ycaf/mas306-rapport/rorboyer-Steinsland_Fiaz.tex

\documentclass[norsk,a4paper,twoside,11pt]{report}
% Alternative Options:
%	Paper Size: a4paper / a5paper / b5paper / letterpaper / legalpaper / executivepaper
% Duplex: oneside / twoside
% Base Font Size: 10pt / 11pt / 12pt

%% Language %%%%%%%%%%%%%%%%%%%%%%%%%%%%%%%%%%%%%%%%%%%%%%%%%
\usepackage[norsk]{babel} %francais, polish, spanish, ...
\usepackage[T1]{fontenc}
\usepackage[ansinew]{inputenc}
\usepackage{hyperref}
\usepackage{natbib}

\usepackage{lmodern} %Type1-font for non-english texts and characters
\usepackage{graphicx} %%For loading graphic files
\usepackage{amsmath}
\usepackage{amsthm}
\usepackage{amsfonts}

%% Line Spacing %%%%%%%%%%%%%%%%%%%%%%%%%%%%%%%%%%%%%%%%%%%%%
%\usepackage{setspace}
%\singlespacing        %% 1-spacing (default)
%\onehalfspacing       %% 1,5-spacing
%\doublespacing        %% 2-spacing

%% Other Packages %%%%%%%%%%%%%%%%%%%%%%%%%%%%%%%%%%%%%%%%%%%
%\usepackage{a4wide} %%Smaller margins = more text per page.
\usepackage{fancyhdr} %%Fancy headings
%\usepackage{longtable} %%For tables, that exceed one page

\usepackage{listings}
\usepackage{textcomp}

\usepackage{color}
\definecolor{darkgreen}{rgb}{0.3,0.6,0.3}
\definecolor{listinggray}{gray}{0.9}
\definecolor{lbcolor}{rgb}{0.9,0.9,0.9}

\lstset{
	backgroundcolor=\color{lbcolor},
	tabsize=4,
	rulecolor=,
	language=c++,
	basicstyle=\scriptsize,
	upquote=true,
	aboveskip={1.5\baselineskip},
	columns=fixed,
	showstringspaces=false,
	extendedchars=true,
	breaklines=true,
	prebreak = \raisebox{0ex}[0ex][0ex]{\ensuremath{\hookleftarrow}},
	frame=single,
	showtabs=false,
	showspaces=false,
	showstringspaces=false,
	identifierstyle=\ttfamily,
	keywordstyle=\color[rgb]{0,0,1},
	commentstyle=\color[rgb]{0.133,0.545,0.133},
	stringstyle=\color[rgb]{0.627,0.126,0.941},
}

\parindent 0mm
\setlength{\oddsidemargin}{0mm}
\setlength{\evensidemargin}{0mm}
\setlength{\topmargin}{-20mm}
\setlength{\textwidth}{165mm}
\setlength{\textheight}{260mm}

\hypersetup{
   pdfauthor={UiA Mechatronics Student},
   pdftitle={MAS306 Bachelor Thesis},
   pdfkeywords={report, mechatronics, master, University of Agder},
   pdfsubject={Project Report},
   colorlinks=true,
   citecolor=darkgreen,
   urlcolor=darkgreen,
   linkcolor=darkgreen,
   pdfstartview=Fit,
   pdfpagelayout=SinglePage,
   pdfcreator=pdflatex,
   pdfproducer=pdflatex
}

\begin{document}
\pagenumbering{roman}
\pagestyle{empty} %No headings for the first pages.
\input{titlepage}
\clearpage

\chapter*{Takksigelser}
Vi vil gjerne rette en stor takk til Morten Ottestad for veiledning og gode tips på veien, og Morten Kjeld Ebbesen for hjelp med mekanikken bak det hele. Vi vil også takke to av våre medelever, Tore Saua og Helge Andreas Falkum, for god hjelp med utforming av designet og den praktiske delen med bygging. 

\clearpage
\chapter*{Abstrakt}

\clearpage

\cleardoublepage %The first chapter should start on an odd page.
\pagestyle{plain} %Now display headings: headings / fancy / ...

\clearpage

% add table of contents, list of figures and tables
\tableofcontents 
\clearpage
\addcontentsline{toc}{chapter}{List of Figures}
\listoffigures
\clearpage
\addcontentsline{toc}{chapter}{List of Tables}
\listoftables
\clearpage
\lhead{\rightmark}
\pagenumbering{arabic}

\chapter{Introduksjon}
Denne oppgaven er tildelt av fakultet for teknologi og realfag ved Universitet i Agder. Det skal anvendes kunnskap som står i tråd med læringsmålene for en treårig bachelor i mekatronikk. 

\section{Metodikk}
Dette prosjektet tar for seg å designe og programmere en rørbøyemaskin som skal kunne forme rør uavhengig av lengde, og slike løsninger finnes det lite informasjon om. De fleste rørbøyemaskiner er installert med en dyttemekanisme i bakenden, som resulterer i at de blir store og tar mye plass om de skal kunne ta lange rør. Det ble derfor tatt i bruk SketchUp og SolidWorks for å lage gode løsninger i 3D-format. 
\section{Avgrensning}
Hovedoppgaven var å designe og konstruere hele rørbøyemaskinen. Gruppen ble dessverre svekket, da et medlem måtte hoppe av prosjektet. Dette gikk utover arbeidsfordelingen som opprinnelig var planlagt. Sammen med veileder ble da oppgaven kortet ned til å kun konsentrere seg om fremparten av maskinen, det gruppen har valgt å kalle XY-bordet.  
\section{Eksisterende rørbøyeteknikker}
Rørbøying har lenge vært en del av historien, og har vært i stadig utvikling. Det er relativt ukomplisert å bøye et rør. En metode er å gjøre det manuelt ved hjelp av en hydraulisk presse. Man kan bytte ut diene, og dermed enkelt kunne bøye rør med forskjellig diameter. Med disse manuelle pressene settes det begrensninger til utforming av røret, da de kun bøyer i én frihetsgrad. Det er i tillegg tidkrevende.  

Et annet alternativ er automatisk hydraulisk rørbøyer. Det er denne type teknikk som vil være den mest sammenlignbare metoden, opp mot oppgavens elektroniske CNC-maskin. En hydraulisk aktuator vil kunne oppnå et høyt moment på små maskiner\cite{HydVsEl}. Den vil ta litt større plass da aktuatoren må stå ved maskinen, hvor en elektrisk styrt aktuator kan plasseres uavhengig av maskinen. Det vil være noen fordeler med en hydraulisk maskin, men de mange fordelene med elektronikk vil veie mot. Slik som at en hydraulisk maskin vil ha høyere støynivå, vedlikehold med oljeskift og presisjon. 

\chapter{Teori}

\section{CNC-styring} 
Computer Numerical Control er elektroniske maskiner som utfører arbeid etter et forhåndsinnstilt program. CNC-styring er avkommet etter Computer Aided Design og Computer Aided Manufacturing (CAD/CAM) produksjoner \cite{NorskDatakunnskapNetwork}. 

De første numerisk styrte maskinene ble utviklet i USA på 1950-tallet. Det ble behov for maskiner som kunne produsere kompliserte og nøyaktige deler til fly. Etterhvert som elektronikken fikk mer innflytelse i maskinindustrien ble det tatt i bruk mikroprosessorer. Dette la grunnlaget for dagens databasert numeriske maskiner (CNC)\cite{Niskolen}. Mikroprosessorene gjorde det mulig å lagre opp til flere forhåndsprogrammerte programmer i hukommelsen til maskinen og lettere å rette opp feil i programmet. Hvor man tidligere måtte lage nye program kunne man nå rette dem opp i hukommelsen. Man tok også i bruk datamaskinens regnekunnskaper for å lettere regne ut koordinatene til maskinens posisjon. 

Programformatet for bruk av koding i CNC-styrte maskiner er regulert av den internasjonale standarden ISO 6983/1 og ISO 6983/2. Dette språket består av G- og M-funksjoner. G-funksjonene er forberedende funksjoner som plassering i X,Y,Z-planet, økende/minkende, høyre/venstre, valg av lengde/hastighet og slike ting. M-funksjonene er hjelpende funksjoner som stopp/start, på/av \cite{Niskolen}. 
\section{Kaldbearbeiding}

\section{Gripemekanisme}
Den mest vanlige metoden for mating av rør i eksisterende CNC-rørbøyemaskiner er å montere en dyttemekanisme i enden av maskinen. Det setter begrensninger til hvilken rørlengde det er mulig å jobbe med. Maskinen som skal konstrueres i denne oppgaven skal, i teorien, kunne ta en uendelig lengde. For å få dette til må det en form for gripemekanisme til. Det er viktig at mekanismen kan fungere godt med runde og glatte overflater. Og at det er høy friksjon mellom gjenstanden som skal ta tak i røret og røret. Balansen mellom å ta tak nok og for mye er veldig fin. Det er hensiktsmessig at mekanismen ikke griper så hardt at det blir skade eller deformasjon på røret. For å få dette til er det mulig å bruke prinsippet til en lift-tong. Den lift-tong vil gripe med en kraft som er proporsjonal med vekten til gjenstanden den skal løfte \cite{N.Sclater}. Dette prinsippet må anvendes på en måte slik at den kan brukes på en horisontal kraft. 
\section{Belastninger} 
For å ha få en oversikt over hvilke krefter som virker på røret når det bøyes, settes opp et enkelt FLD (Free-Body-Diagram), som er illustrert i figur \ref{FLD}. Det er satt opp et lokalt koordinatsystem som følger aksen til røret. Det er kraften $P_L$ som sier noe om hvor stort moment som trengs for å dytte røret i X-retning, og den kraften som er viktigst å finne ut for å kunne vite om motoren har stor nok kraft til å klare oppgaven. 

\begin{figure}[h]
\centering
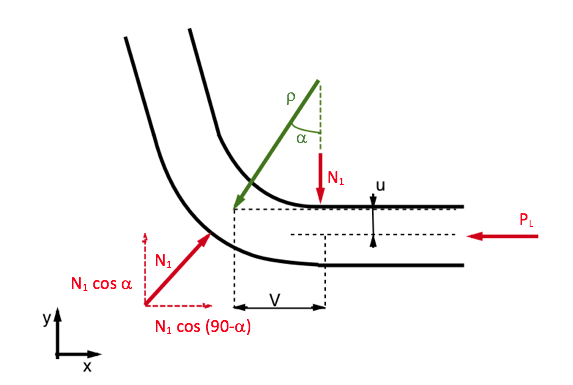
[picture p1: Pics/krefterror.png]

\caption[Krefter på rør]{Enkelt FLD av kreftene som virker på røret}
\label{FLD}
\end{figure}

\begin{equation}\label{u}
u=\rho\cdot(1-cos\alpha)
\end{equation}
\begin{equation}\label{V}
V=\rho\cdot sin \alpha
\end{equation}
Hvor: \\
$u$=Forskyvning på skinnene\\
$V$=Avstand fra stuss og senter av sfærisk lager \\
$\alpha$=Bøyeradius i radianer\\
$\rho$= Radius av bøyen på røret \\

$V$ og $u$ er konstanter som kan hentes ut i fra konstruksjonen. Vi sitter da igjen med to ligninger og ukjent. Ved å løse ligning \ref{V} med hensyn på $\rho$, og sette den nn i ligning \ref{u} får vi

\begin{equation}\label{alpha}
u=\frac{V}{sin\alpha}\cdot(1-cos\alpha)
\end{equation}

Denne ligningen kan løses grafisk. Ved å finne det maksimale $u$ kan være, finner man den maksimale bøyeradien som er mulig å oppnå. Det er da mulig å løse ligning \ref{rho} og finne $\rho$.

\begin{eqnarray}\label{rho}
\rho=\frac{u}{1-cos\alpha}
\end{eqnarray}

For at røret skal få varig derformasjon må det over flytegrensen, slik at det får en plastisk deformasjon. Dette vil i teorien skje i ytterpunktene av røret. Mens i midten vil holde seg under flytegrensen. For å finne denne grensen bruker man 
\begin{equation}
\epsilon_y=\frac{-y}{\rho}
\end{equation}
\begin{eqnarray}
\sigma_y&=&E\cdot\epsilon_y \Downarrow\nonumber\\
\epsilon_y&=&\frac{\sigma_y}{E}
\end{eqnarray}
Dette gir 
\begin{eqnarray}\label{y}
\frac{-y}{\rho}&=&\frac{\sigma_y}{E} \Downarrow\nonumber\\
y&=&\frac{-\sigma_y\cdot\rho}{E}
\end{eqnarray}\\
Hvor: \\
$\epsilon_y$=Tøyning\\
$y$= Avstanden fra senter av røret til den plastiske deformasjonen begynner\\
$\rho$= Radiusen av bøyen på røret\\
$E$=Elasitetsmodulen\\
$\sigma_y$=Flytegrensen til metallet\\
 
 I figur \ref{fig;pl} er det illustrert med to røde streker hvor overgangen fra den elastiske deformasjonen til plastisk deformasjon vil skjer. Lengden $y$ er ukjent, så nøyaktig hvor dette skille går finner man ikke ut før man har løst ligning \ref{y}. 
\begin{figure}[h!] 
\centering
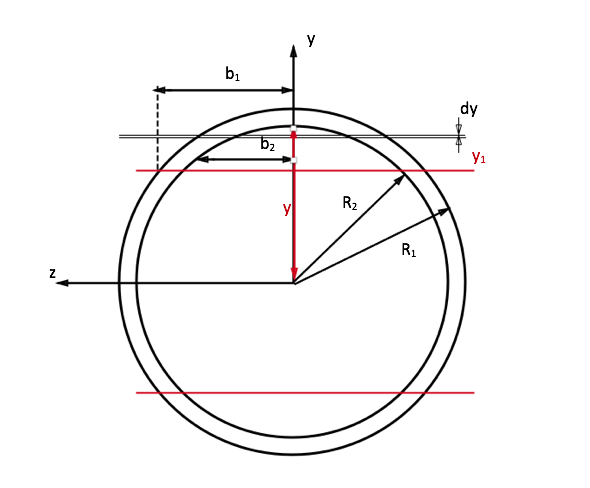
[picture p2: Pics/plastisk.png]

\caption[Plastisk deformasjon]{llustrasjon om hvor det plastiske området begynner}
\label{fig;pl}
\end{figure}

\begin{eqnarray}
R_1^2&=&b_1^2+y^2 \Downarrow\nonumber\\
 b_1&=&\sqrt{R_1^2-y^2}
\end{eqnarray}
\begin{eqnarray}
R_2^2&=&b_2^2+y^2 \Downarrow\nonumber\\ 
b_2&=&\sqrt{R_2^2-y^2}
\end{eqnarray}
Momentet som trengs for å komme opp i plastisk deformasjon er utledet ut i fra figur \ref{fig;pl}. 

\begin{eqnarray}\label{plastisk}
M_P&=&\int_{F}y dF \Downarrow \nonumber\\
&=&\int_{y_1}^{R_1}y\cdot\sigma_y\cdot2b_1 dy - \int_{y_1}^{R_2}y\cdot\sigma_y\cdot2b_2 dy \Downarrow\nonumber\\
&=&\frac{2}{3}\cdot\sigma_y((R_1^2-y_1^2)^\frac{3}{2}-(R_2^2-y_1^2)^\frac{3}{2})
\end{eqnarray}
Hvor:\\
$M_P$=Moment for å oppnå plastisk deformasjon\\
$\sigma_y$=Flytegrensen\\ 
$b_1$=Bredden fra senterlinje til yttersiden av røret\\
$b_2$=Bredden fra senterlinje til innsiden av røret\\
$R_1$=Ytre radius\\
$R_2$=Indre radius\\
$y_1$= Grensen til plastisk deformasjon\\

Momentene som regnes ut i ligning \ref{plastisk} og \ref{elastisk} er kun for halve høyden av røret, så svaret må ganges med to. I figur \ref{fig;el} er samme rør illustret på nytt, men denne gangen med hensyn på den elastiske deformasjonen. Det er 

\begin{figure}[h!]
\centering
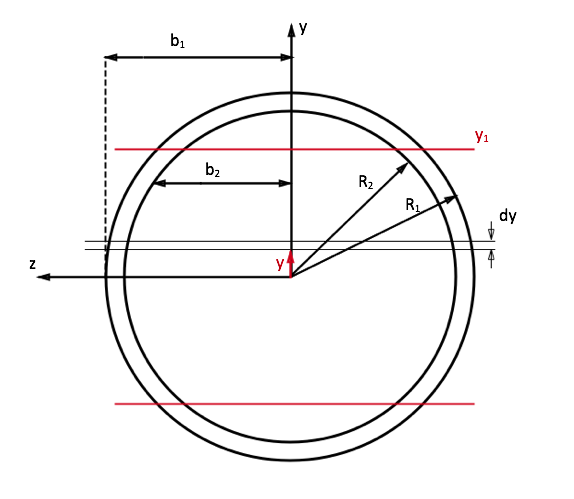
[picture p3: Pics/elastisk.png]

\caption[Elastisk deformasjon]{Illustrasjon av hvor det elastiske området vil befinne seg}
\label{fig;el}
\end{figure}

\begin{eqnarray}\label{elastisk}
M_E&=&\int_{F}ydF\Downarrow\nonumber\\
&=&\int_{A}y\cdot\sigma_ydA\Downarrow\nonumber\\
&=&\int_{0}^{y_1}y\cdot\frac{\sigma_y}{y_1}\cdot y\cdot2b_1dy-\int_{0}^{y_1}y\cdot\frac{\sigma_y}{y_1}\cdot y\cdot2b_2dy\Downarrow\nonumber\\
&=&2\frac{\sigma_y}{y_1}\cdot(-y_1\frac{(R_1^2-y_1^2)^\frac{3}{2}}{4})+\frac{R_1^2\cdot y_1\sqrt{R_1-y_1^2}}{8}+\frac{R_1^4}{8}\cdot\arcsin\frac{y_1}{R_1}\nonumber\\ &-& 2\frac{\sigma_y}{y_1}\cdot(-y_1\frac{(R_2^2-y_1^2)^\frac{3}{2}}{4})+\frac{R_2^2\cdot y_1\sqrt{R_2-y_1^2}}{8}+\frac{R_2^4}{8}\cdot\arcsin\frac{y_1}{R_2}
\end{eqnarray}
Hvor:\\
$M_E$=Momentet for å oppnå elastisk deformasjon\\
$\sigma_y$=Flytegrensen\\ 
$b_1$=Bredden fra senterlinje til yttersiden av røret\\
$b_2$=Bredden fra senterlinje til innsiden av røret\\
$R_1$=Ytre radius\\
$R_2$=Indre radius\\
$y_1$= Avstanden opp til plastisk deformasjon\\

\begin{eqnarray}\label{kraft}
M_E+M_P&=&V\cdot N_1\Downarrow\nonumber\\
N_1&=&\frac{M_E+M_P}{V}
\end{eqnarray}
Hvor:

$M_E$=Momentet for å oppnå elastisk deformasjon\\ 
$M_P$=Momentet for å oppnå plastisk deformasjon\\ 
$N_1$=Kraften som står vinkelrett på røret\\

\begin{eqnarray}\label{dyttekraft}
\sum F_x=0N&=&-P_L+N_1\cdot \cos(\frac{\pi}{2}-\alpha)\Downarrow\nonumber\\
P_L&=&N_1\cdot\cos(\frac{\pi}{2}-\alpha)
\end{eqnarray}

Hvor:\\
$P_L$=Kraften som må til for å dytte røret\\ 
$N_1$=Kraften som står vinkelrett på røret\\

\chapter{Konstruksjon og styring}
(Her beskrives fremgangsmåten i detalj slik at resultatet kan reproduseres av andre)
\section{Utstyr}
Før planleggingen av designet var det hensiktsmessig å gå over lagret, for å få en oversikt over hva som var tilgjengelig og hva som eventuelt måtte kjøpes inn. Vi hadde tilgang på ledeskruer med tilhørende mutter, samt skinner med vogn som sklir lett frem og tilbake. Dette skulle implementeres for å kunne laget et plan som kunne bøye røret i X- og Y-retning, og føre røret fremover. Det resterende som manglet for å kunne konstruere en full rørbøyemaskin måtte tegnes og konstrueres selv, ved hjelp av SolidWorks og SketchUp. 

Programvaren som skal brukes for å styre X-Y-Z-planet er Mach3. Dette er et mye brukt kontrollsystem for CNC-maskiner. Det virker bra i CAD/CAM produksjoner, som med laserkuttere og fres for å nevne noen. 

\section{Design}
Hele prosessen med oppgaven startet med designet. Flere maskiner ble undersøkt for å få inspirasjon til design. Og det ble relativt tidlig laget et utkast av en maskin, som vises i figur \ref{forste}. Den er installert med to motorer for å styre den delen som skal bevege seg i X- og Y-retning. Det er også en motor i bakenden, for å dytte røret fremover. Men den mekanismen måtte re-designes da maskinen skulle ha gripemekanisme for å kunne ta uendelig lange rør. I figur \ref{andre} ser man det neste konseptet som ble designet. I denne designfasen ble den fremste delen av maskinen, den delen som skal bevege seg i X-Y-planet, videreutviklet.  Utfordringene kom når midt-delen, med en matemekanisme, skulle tegnes. Her er den med den første ideen til en gripemekanisme, men denne prosessen er forklart nærmere i de videre kapitlene angående gripemekanismen og rotasjon av rør.

\begin{figure}[h!]
\centering
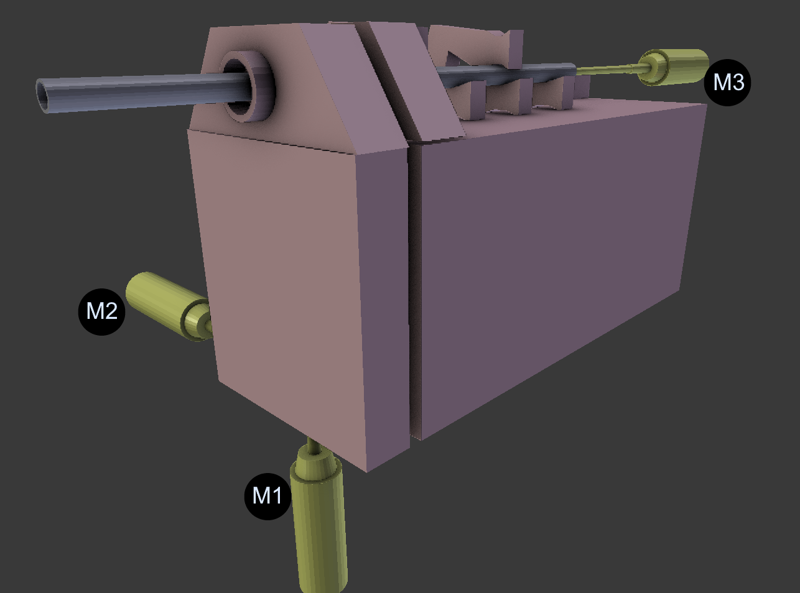
[picture p4: Pics/prinsippSkisse_1.png]

\caption[Konsept 1]{Første konseptet}
\label{forste}
\end{figure}
\begin{figure}[h!]
\centering
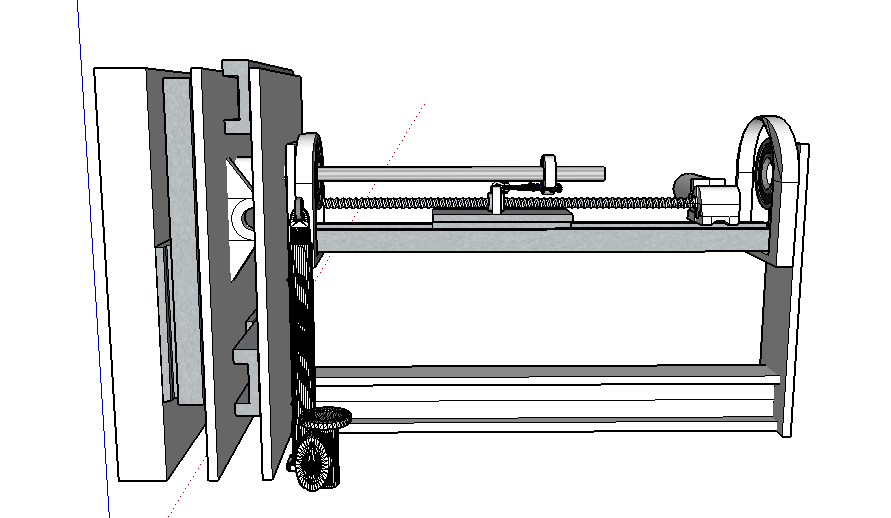
[picture p5: Pics/Ide2.png]

\caption[Konsept 2]{Det andre konseptet}
\label{andre}
\end{figure}
Det er lagt mye arbeid i at maskinen skal være kompakt, slik at den tar lite plass. Den endelig maskinen er designet med i alt tre motorer og en lineær-sylinder. Det er plassert en motor på bakerste del for å styre skruen i Z-retning. Denne jobber sammen med lineær-sylinderen for å rotere røret i spesifikke grader. En motor er festet på undersiden av XY-bordet for å styre skruen i Y-retning og en tredje motor på siden for å styre skruen i X-retning. I figur \ref{ide3} er hele konstruksjonen illustrert, hvor røret blir matet i Z-retning mot venstre. 

\begin{figure}[h]
\centering
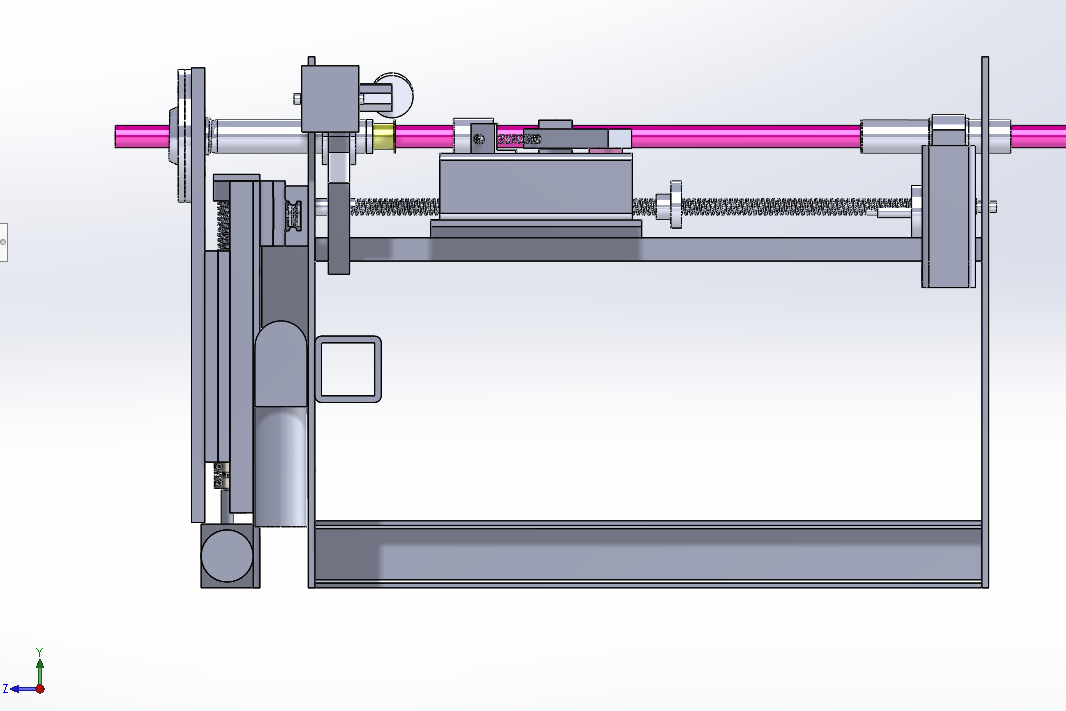
[picture p6: BildeZY.PNG]

\caption{Full illustrasjon av design}
\label{ide3}
\end{figure}

\section{Materialer}
Alle materialene som måtte produseres fra bunnen av er tiltenkt å være i stål. Stålplatene er på 10mm med hull som er tilpasset de ferdigproduserte skinnene. Disse passer til en M8 bolt. Skinnene og vognene er av aluminium, så ingen av delen kunne sveises til stålplatene. I figur X ser man en skinne og vogn montert fast i en plate. 

Det er brukt lager fra Igus til opplagring av skruer og stussen. Disse er laget i plastikk, og trenger ingen vedlikehold eller smøring \cite{Igus}. Lagrene som er valgt ut for X-og Y-skrue kan tåle opp til 120 MPa \cite{IgusQ2}. Og lageret som er valgt ut til stussen tåler opp til 80MPa \cite{IgusG}

\begin{figure}[h!]
\centering
\graphicspath{{Pics}}
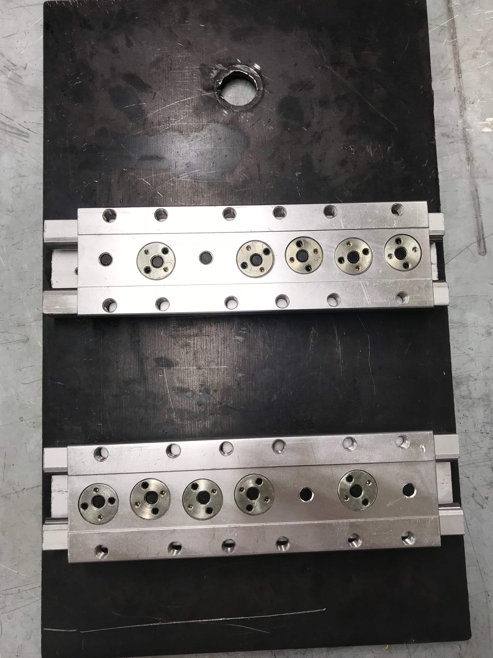
[picture p7: IMG_E1818.jpg]

\caption[Skinner]{Her er skinene og vognen montert på en av stålplatene som skal styre øyet}
\label{stal}
\end{figure}
\pagebreak
\section{Mating av rør}
Prosessen med å finne en mekanisme for å mate røret i Z-retning var den mest krevende. En av de første ideene var en lift-tong festet til en ledeskrue, med to halvmåner som tar tak i røret, dette er illustrert i figur \ref{grip1} Ideen var at halvmånene skulle klemme til når skruen gikk i positiv retning, og løse opp når den skulle gå i negativ retning for å hente mer rør. Problemet med denne løsningen er at den bare tar tak i nedre del av halvmånen. Når dette skal rotere vil det skape et uønsket moment. Dette ble løst ved å montere på en til klype på toppen av halvmånene, og laget et slags hus, som man kan se i figur \ref{grip2}. Men ved nærmere ettertanke ble det avklart at det ble for avansert å produsere. Det var det nåværende gripehuset ble konstruert, figur \ref{grip3} Det er større og mer robust, og skal fungere på samme måte med at det griper til i positiv retning og slipper opp i negativ retning. Dette kan enklere produseres da det er brukt forskjellige typer standardiserte stålkomponenter. I motsetning til de første to ideene hvor lift-tongen måtte vært skjært ut i ulike former. 
\begin{figure}
\centering
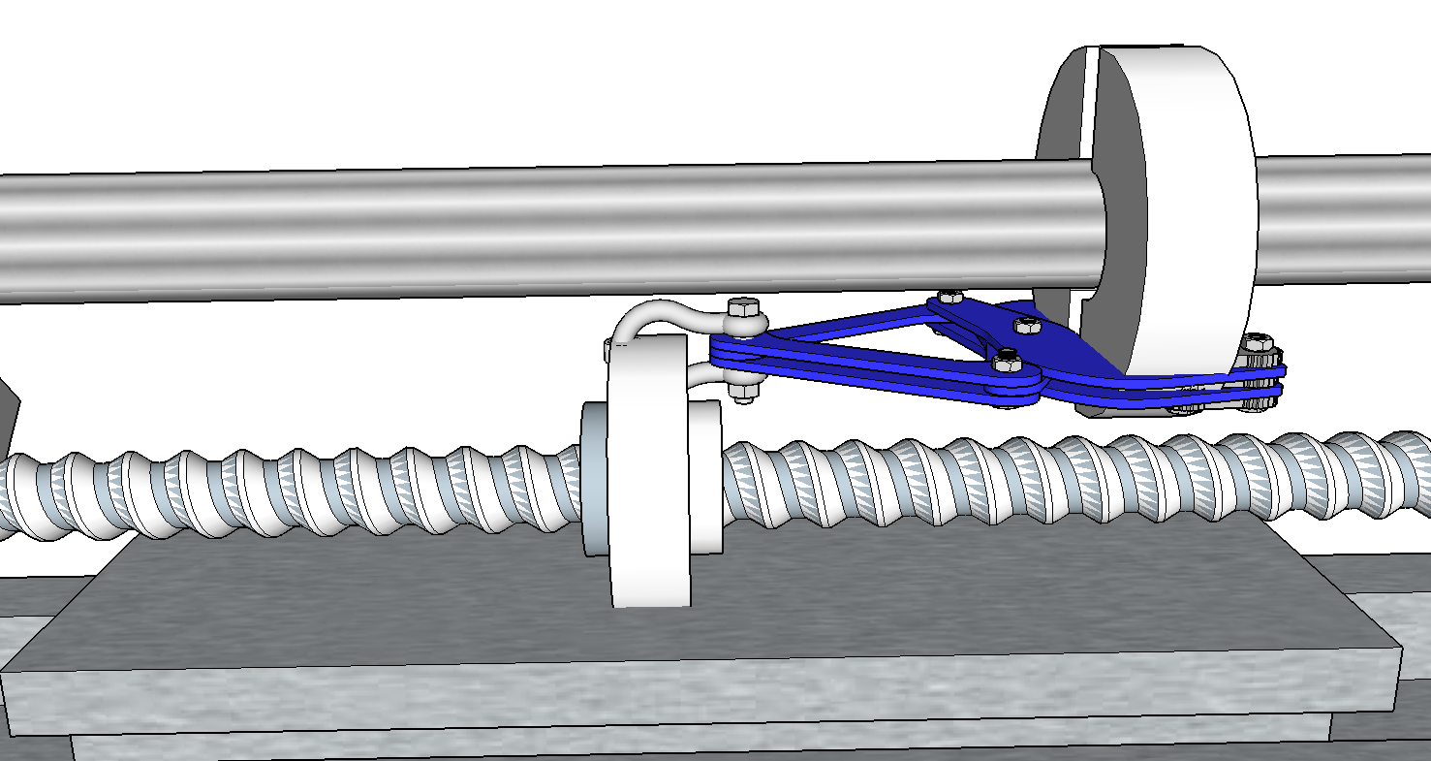
[picture p8: Pics/GripeKonsept.PNG]

\caption[Gripemekanisme 1]{Den første ideen til gripemekanisme}
\label{grip1}
\end{figure}
\begin{figure}
\centering
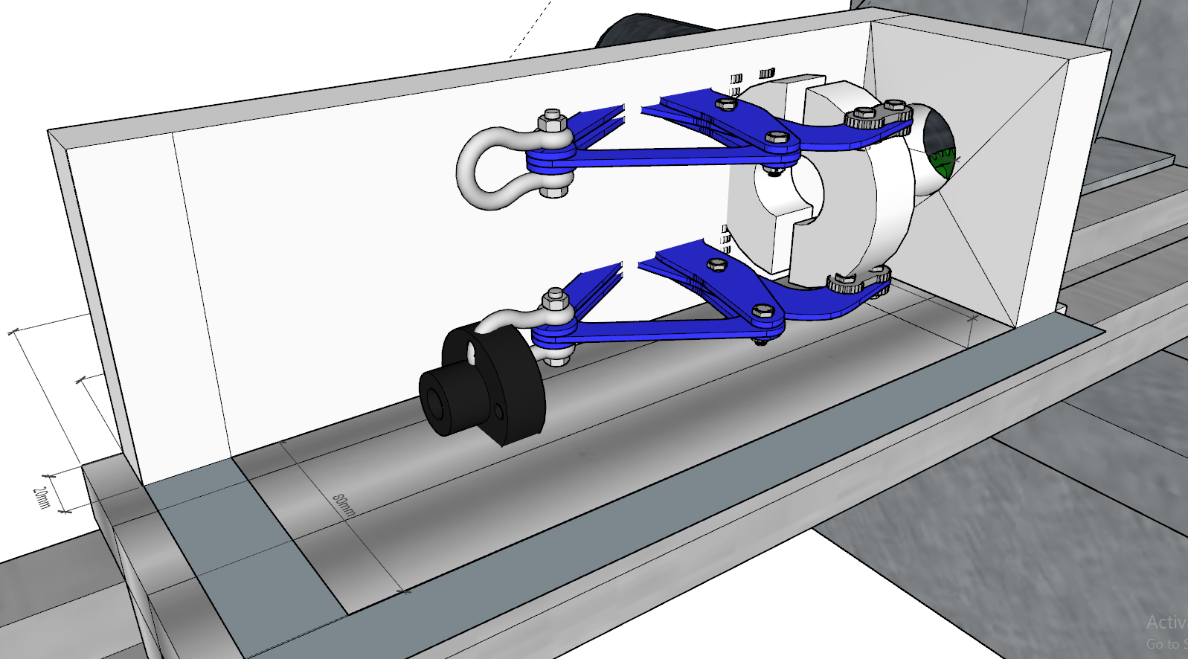
[picture p9: Pics/gripeHusConcept.PNG]

\caption[Gripemekanisme 2]{Den andre ideen til gripemekanisme}
\label{grip2}
\end{figure}
\begin{figure}
\centering
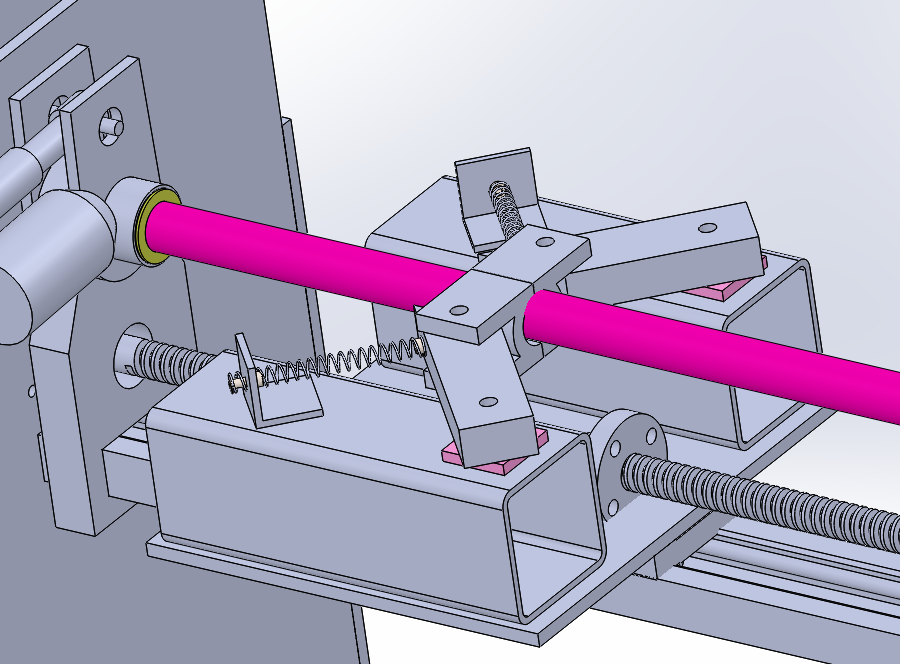
[picture p10: Pics/Gripemekanisme.png]

\caption[Gripemekanisme 3]{Den endelige gripemekanismen}
\label{grip3}
\end{figure}
\pagebreak
\subsection{Gripehus}
I fra figur \ref{FLD} ser man at det kommer en kraft $P_L$ på røret. Det er denne kraften som trengs for å kunne føre og bøyet røret. For å finne denne, må ligning \ref{u} - \ref{dyttekraft} anvendes. Hvis man tar utgangspunktet i at det skal bøyes et rør med flytegrenser $\sigma_y = 195MPa$ og E-modul $E=210 GPa$. Et rør med tykkelse $t=2,65mm$ gir en ytre radius $R_1= 16,85mm$ og indre radius $R_2=14,2mm$. $u$ er den maksimale skyvningen skinnene kan ha i X- og Y-retning før det sfæriske lageret går ut av posisjon. Og den er funnet til å være $u=15mm$. $V$ er avstanden fra stussen til senter av det sfæriske lageret. Ut i fra konstroksjonen kan man lese av at denne er $V=40.33mm$. 

\begin{equation}\label{alphanew}
u=\frac{V}{sin\alpha}\cdot(1-cos\alpha)
\end{equation}

Ut i fra figur \ref{graf} kan man se av $\alpha$ = 0,712 rad

\begin{figure}[h!]
\centering

\caption[Graf]{Grafen viser sammenhengen mellom $u$ og $\alpha$}
\label{graf}
\end{figure}

\begin{eqnarray}\label{rhonew}
\rho&=&\frac{u}{1-\cos\alpha}\nonumber\\
&=&\frac{15mm}{1- \cos 0,712}\nonumber\nonumber\\
&=&{\underline{\underline{61,717mm}}}
\end{eqnarray}

\begin{eqnarray}\label{ynew}
y&=&\frac{-\sigma_y\cdot\rho}{E}\nonumber\\
&=&\frac{-(-195MPa)\cdot61,717mm}{210\cdot10^3 MPa}\nonumber\\
&=&\underline{\underline{0,057mm}}
\end{eqnarray}\\

\begin{eqnarray}\label{plastisknew}
M_P&=&\frac{2}{3}\cdot\sigma_y((R_1^2-y_1^2)^\frac{3}{2}-(R_2^2-y_1^2)^\frac{3}{2})\nonumber\\
&=&\frac{2}{3}\cdot195MPa(((16,85mm)^2-(0,057mm)^2)^\frac{3}{2}-((14,2mm)^2-(0,057mm)^2)^\frac{3}{2})\nonumber\\
&=&\underline{249 703,099Nmm}
\end{eqnarray}

Dette er kun momentet for å komme opp i plastisk deformasjon for halve røret. For å få et korrekt tall for hele røret, må svaret ganges med to. Så dette gir at det fullstendige momentet som må til er 

\begin{eqnarray}
M_P &=& 2 \cdot 249703,099\nonumber\\
&=&\underline{\underline{499 406,198Nmm}}
\end{eqnarray}

\begin{eqnarray}\label{elastisknew}
M_E&=&2\cdot \frac{195MPa}{0,057mm}\cdot(-0,057mm\frac{((16,85mm)^2-(0,057mm)^2)^\frac{3}{2}}{4})\nonumber\\
&+&\frac{(16,85mm)^2\cdot 0,057mm\sqrt{(16,85mm)^2-(0,057mm)^2}}{8}\nonumber\\
&+&\frac{(16,85mm)^4}{8}\cdot\arcsin\frac{0,057mm}{16,85mm}\nonumber\\ 
&-& 2\cdot \frac{195MPa}{0,057mm}\cdot(-0,057mm\frac{((14,2mm)^2-(0,057mm)^2)^\frac{3}{2}}{4})\nonumber\\
&+&\frac{(14,2mm)^2\cdot 0,057mm\sqrt{(14,2mm)^2-(0,057mm)^2}}{8}\nonumber\\
&+&\frac{(14,2)^4}{8}\cdot\arcsin\frac{0,057mm}{14,2mm}\nonumber\\
&=& 9,892 Nmm - 8,336Nmm\nonumber\\
&=&\underline{1,555Nmm}
\end{eqnarray}

I dette tilfellet er det også bare regnet ut den elastiske deformasjonen for halve røret. Så dette svaret på også ganges med to. 

\begin{eqnarray}
M_E&=& 2 \cdot 1,555Nmm\nonumber\\
&=&\underline{\underline{3,111Nmm}} 
\end{eqnarray}

\begin{eqnarray}\label{n1}
N_1&=&\frac{M_E+M_P}{V}\nonumber\\
&=&\frac{3,111Nmm+499 406,198Nmm}{40,33mm}\nonumber\\
&=&\underline{\underline{12 383,073N}}
\end{eqnarray}

\begin{eqnarray}\label{pl}
P_L&=&N_1\cdot\cos(\frac{\pi}{2}-\alpha)\nonumber\\
&=&12 383,073\cdot \cos(\frac{\pi}{2}-0,712rad)\nonumber\\
&=&\underline{\underline{8091,923N}}
\end{eqnarray}

\subsection{Opplagring}

\clearpage
\section{Rotasjon av rør}
Ifølge kravspesifikasjonen skal røret kunne rotere $\pm45^\circ$. Maksimalt nødvendig moment for å kunne rotere røret oppstår når røret roteres mot bøyeretningen. Det vil være avhengig av friksjonen pga. $P_{u}$ og smøring i det sfæriske lageret. 

\begin{figure}[h!]
\centering
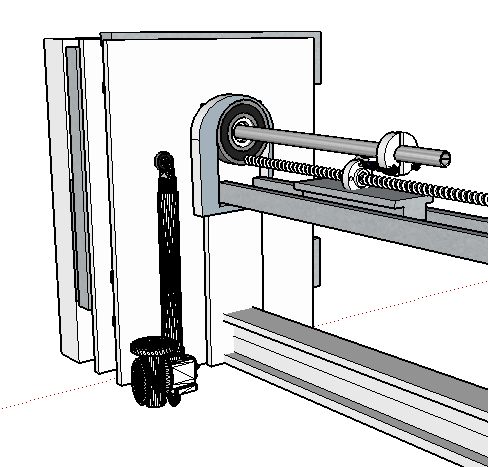
[picture p11: Pics/sylinder2.png]

\caption[Sylinder 1]{Første ide til hvordan rotere røret}
\label{syl1}
\end{figure}

\begin{figure}[h!]
\centering
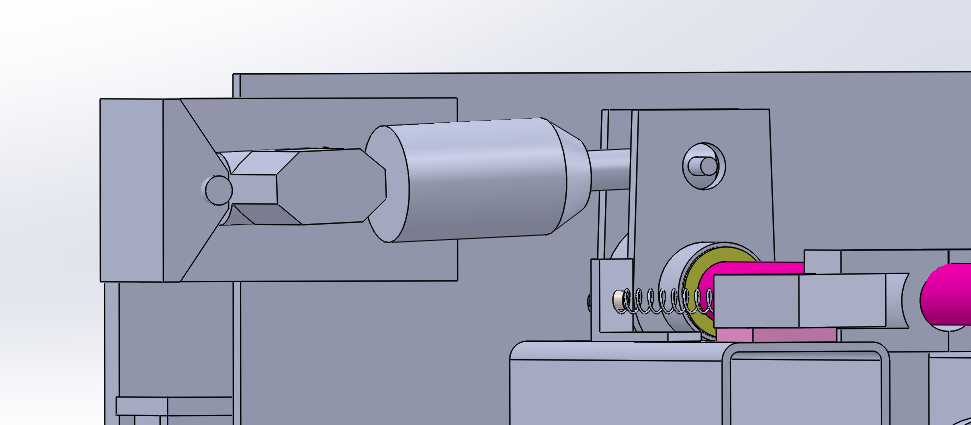
[picture p12: Pics/Sylinderny.png]

\caption[Sylinder 2]{Hvordan rotasjonsmekanismen ble seende ut til slutt}
\label{syl2}
\end{figure}

\subsection{Elektrisk sylinder}
\section{Bøyemekanisme}
\subsection{Sfærisk lager}
Det sfæriske lageret er formet som en kule, som sitter fast mellom to skiver. 
\begin{figure}
\centering
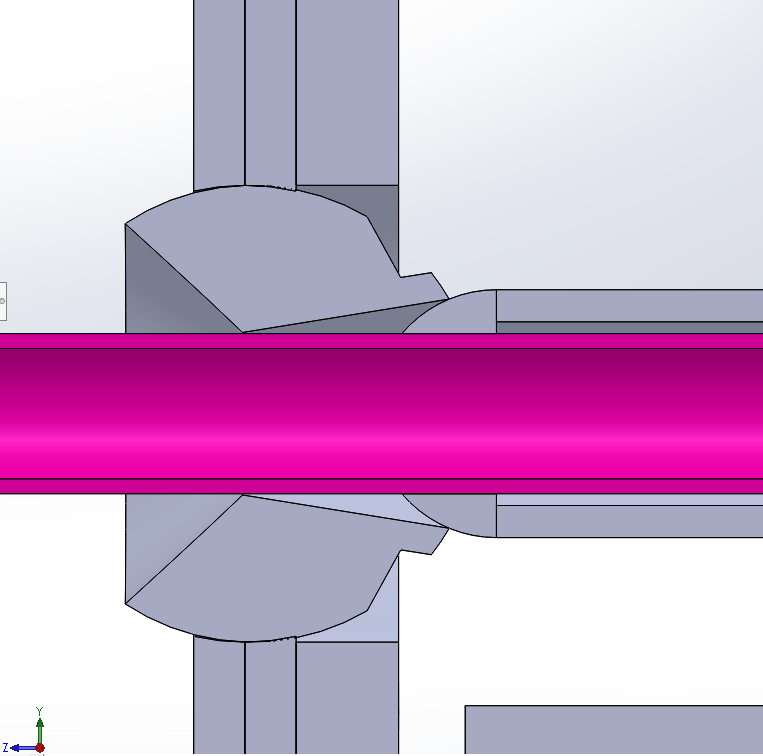
[picture p13: Pics/Kuttoye.png]

\caption[Sfærisk lager]{Hvordan det sfæriske øyet er utformet innvendig}
\label{sferiskkutt}
\end{figure}

\begin{figure}
\centering
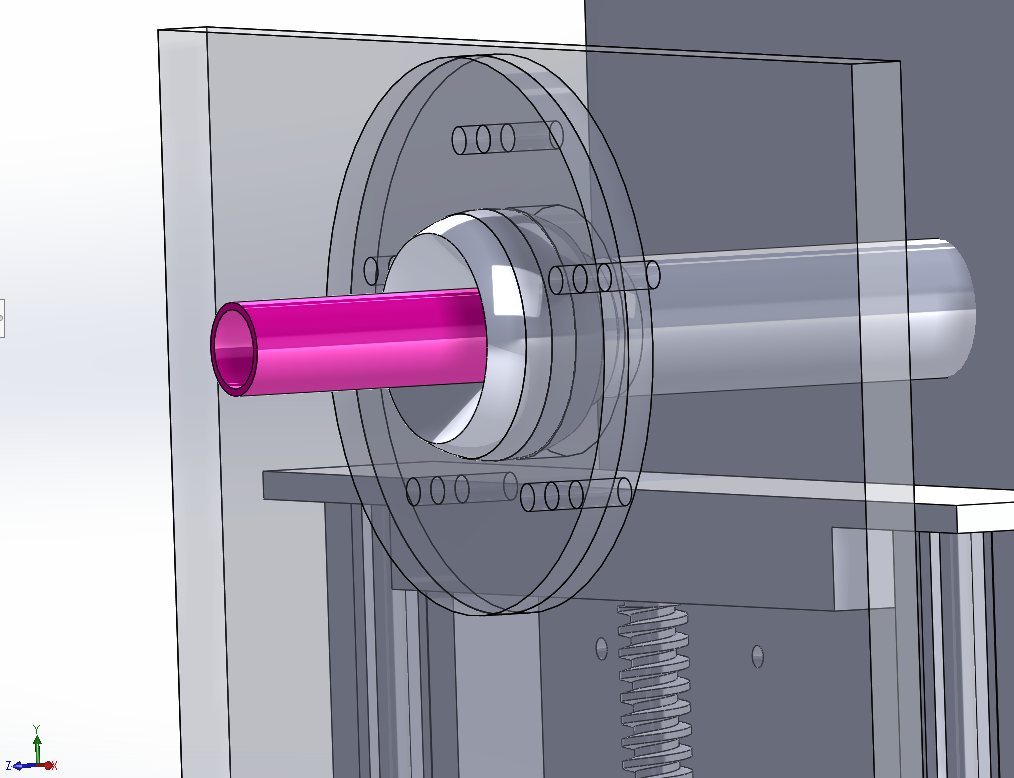
[picture p14: Pics/rontgenoye.PNG]

\caption[Sfærisk lager]{Hvordan det sfæriske lageret ser ut festet i mellom skivene}
\label{sferisk1}
\end{figure}
\clearpage

\section{XY-bord}
Systemet er basert på samme prinsipp som en fres. XY-bordet fungerer på samme måte som et verktøy som beveger seg i XY-planet. Matingen i Z-aksen tilsvarer Z-bevegelsen til verktøyet, og rotasjonen av røret tilsvarer «spindle-speed». 

I det gitte senarioet i figur \ref{FLD} vil den maksimale kraften som utsetter på skruen være 
$N_1 \cdot \cos \alpha$. I og med at røret bøyes i Y-retning, i forhold til koordinatsystemet til maskinen, vil skruen i Y-retning ta opp all kraften. Hadde man tatt samme senario, men vridd røret så det bøydes med samme grader i X-retning, ville det vært skruen i X-retning som tok opp kreftene. Man kan da konkludere med at skal man fordele kreftene mellom de to skruene vil det være hensiktsmessig å rotere røret slik at det sto midt i planet mellom X og Y. 

Vi fant den maksimale bøyeradien maskinen kan oppnå til å være alpha=0.712 rad. Det betyr at den maksimale kraften hver skrue vil være utsatt for, ved det mest ekstreme tilfelle vil være 

\begin{equation}\label{}
N_s=N_1 \cdot \cos\alpha=12 383,072 N \cdot \cos 0,712
=\underline{\underline{9373,433 N}}
\end{equation}

\begin{figure}[h!]
\centering
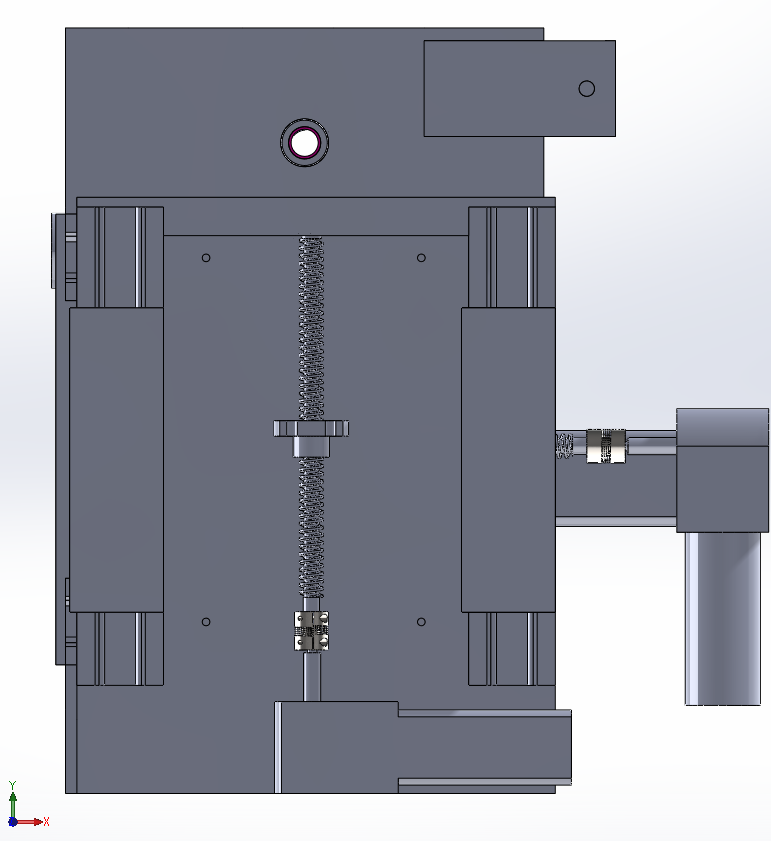
[picture p15: rontgenYskrue.PNG]

\caption[Y-mekanisme]{Bildet viser hvordan Y-mekanismen er designet}
\label{ymek}
\end{figure}
%denne skal under Design

\begin{figure}[h!]
	\centering
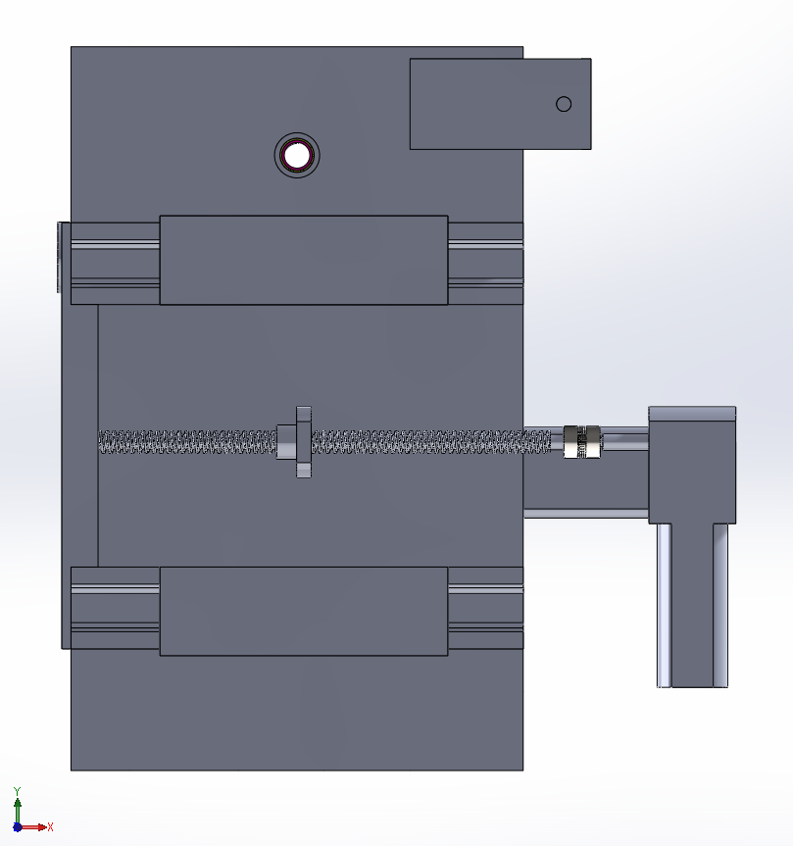
[picture p16: RontgenXskrue.PNG]
	
	\caption[X-mekanisme]{Bilde viser hvordan X-mekanismen er designet}
	\label{xmek}
\end{figure}
%Denne skal under Design
\pagebreak

\subsection{Ledeskinne}
\subsection{Ledeskrue}
Ledeskruene som er brukt er av typen trapesgjenget ledeskrue. Det er denne type skrue som er best egnet å bruke når man har en last som skal bevege seg i begge retninger\cite{MachineDesign}.  I figur \ref{acme} ser man hvordan trapesskruen er utformet i forhold til firkantgjenger og saggjenger. Trapesgjengen har en vinkel på $29^\circ$ mellom hver gjenge. Skruen som brukes i denne oppgaven har en ytre diameter på $ d_y=25mm $ og en indre diameter $ d_i=19mm $ og stinging på gjengene er $ P=5mm $.

\begin{figure}[h!]
\centering
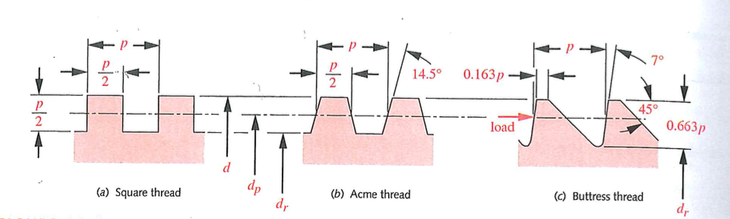
[picture p17: Pics/acme.png]

\caption[Ledeskruer]{Bildet illustrerer tre forskjellige ledeskruer}
\cite{MachineDesign}
\label{acme}
\end{figure}

Momentet som oppstår når skruene går frem og tilbake er regnet ut ved å anvende et ligningsett fra Machine Design \cite{MachineDesign} som omhandler momentregning på en ledeskrue. Ligningssettet består av en ligning for momentet når skruen går fremover og en ligning for momentet når skruen går bakover. 

Vi kan regne ut midtdiameteren på skruen ($d_p$ i figur \ref{acme}) som; (\cite{Midtdiameter})

\begin{eqnarray}
d_m&=&\frac{d_y+d_i}{2}\nonumber\\
&=&\frac{25mm+19mm}{2}\nonumber\\
&=&\underline{\underline{22mm}}
\end{eqnarray}

Når skruen går fremover blir momentet regnet ut som 

\begin{eqnarray}
M_F&=&M_{SF}+M_L\nonumber\\
&=&\frac{N_S\cdot d_m}{2}\cdot \frac{(\mu_S\cdot \pi \cdot d_m + P\cdot \cos \alpha_t)}{(\pi\cdot d_m\cdot \cos \alpha_t - \mu_S\cdot P)}+\mu_L\cdot N_S \cdot \frac{d_L}{2}\nonumber\\
&=&\frac{8818,667N\cdot 22mm}{2}\cdot \frac{(0,17\cdot \pi \cdot 22mm + 5mm\cdot \cos 14,5^\circ)}{(\pi\cdot 22mm\cdot \cos 14,5^\circ -0,17\cdot 5mm)}\nonumber\\
&+&0,42\cdot 8818,667N \cdot \frac{20mm}{2}\nonumber\\
&=&\underline{\underline{61 398,988 Nmm}}
\end{eqnarray}

Når skruen går bakover blir momentet regnet ut som 
\begin{eqnarray}
M_B&=&M_{SB}+M_L\nonumber\\
&=&\frac{N_S\cdot d_m}{2}\cdot \frac{(\mu_S\cdot \pi \cdot d_m - P\cdot \cos \alpha_t)}{(\pi\cdot d_m\cdot \cos \alpha_t + \mu_S\cdot P)}+\mu_L\cdot N_S \cdot \frac{d_L}{2}\nonumber\\
&=&\frac{8818,667N\cdot 22mm}{2}\cdot \frac{(0,17\cdot \pi \cdot 22mm - 5mm\cdot \cos 14,5^\circ)}{(\pi\cdot 22mm\cdot \cos 14,5^\circ + 0,17\cdot 5mm)}\nonumber\\
&+&0,42\cdot 8818,667N \cdot \frac{20mm}{2}\nonumber\\
&=&\underline{\underline{46 928,558Nmm}}
\end{eqnarray}

$ Hvor: $ 

$M_L$=Momentet fremover

$M_B$=Momentet bakover

$M_{SF}$=Momentet fra skruen fremover

$M_{SB}$=Momentet fra skruen bakover

$M_L$=Momentet fra lageret 

$N_S$=Kraften som påføres skruen 

$P$=Stigningen i gjengen 

$d_m$=Midtdiameter på skruen 

$\alpha_t$=Vinkel på trapesgjengene i grader

$d_L$=Diameter på lager \cite{IgusQ2}

$\mu_S$=Friksjon stål mot stål med smøring \cite{Friksjon}

$\mu_L$=Friksjon stål mot lager \cite{IgusQ2}\\

$ M_F $ og $ M_B $ blir da det totale momentet som trengs for å bevege lasten frem og tilbake. Som tidligere er det brukt krefter for det mest ekstreme tilfellet maskinen kommer til å oppnå. Så dette momentet vil også være det største mulige. 
\subsection{Motorer}
\section{Motordrivere}
\section{Mach3-software}
Systemet er basert på samme prinsipp som en fres. XY-bordet fungerer på samme måte som et verktøy som beveger seg i XY-planet. Matingen i Z-aksen tilsvarer Z-bevegelsen til verktøyet, og rotasjonen av røret tilsvarer «spindle-speed».

\textit{Figur 1: Sammenheng mellom tradisjonell fres og rørbøyer}

\textbf{Driver – DCS810}
Motorstyringen skal skje ved hjelp av en motor driver av typen DCS810. Dette er en servo-driver som konverterer et lav-spennings kontroll-signal om til høy-spenningssignal som driver motoren. 
Driveren har 
Prosjektet er basert på å bruke material og utstyr som er lett tilgjengelig I tråd med dette blir det benyttet en «single-ended» enkoder i motsetning til en differensial enkoder. I tillegg, så er det i utgangspunktet snakk om korte kabellengder.
\pagebreak

\begin{figure}[h]
	\centering
	
	\caption[Driver]{Tilkoblinger til driveren for x-aksen}
\end{figure}

\textbf{Kontroller}
Kontrolleren som ble benyttet er en BSMCE04U-PP.  Den bruker USB-tilkobling til PC og vil gjenkjennes av Mach3.

\textit{Figur 3: Koblingsskjema av kontroller til driver}

\textbf{Pulsing}

For å finne nødvendige antall pulser som Mach3 skal sende, må man vite noe om hele drivsystemet, dvs. motor, enkoder, gir og ledeskrue.

Utvekslingsforholdet ble målt på to forskjellige måter og ga to forskjellige resultater. Det ble først målt uten enkoder. Det foregikk ved å vri enkoder-akselen til akselen ut av girboksen (last akselen) hadde gått en omdreining. Utvekslings forholdet ble da målt til 32:1. Det ble antatt at enkoder-akselen har samme utvekslingsforhold som ut fra motoren til girboksen. 

Den andre metoden gikk ut på å koble enkoderen til en Arduino som vist i figur [nr]. Se for øvrig kode i tillegg [nr]. Motoren ble koblet til en variabel strømforsyning. 

Figur: Arduino-krets

Deretter ble motoren kjørt flere ganger mens enkoder-verdier ble lest av i Arduino-IDEens seriellmonitor.  

Ardiuno teller hvert step og lagrer dette i variabelen $ encoder0Pos $ for å få dette omgjort til grader brukes følgende linje med kode: 

\begin{lstlisting}
angle = encoder0Pos * (360.0/2400.0);
\end{lstlisting}

Dette vil gi verdier som ligger rundt $ 9820 $ for en rotasjon av lastakselen. Siden man fra før hadde funnet utvekslingsforholdet til å være $ 32:1 $. Dette gir antall grader som følger:

\begin{equation}\label{key}
\theta _{maks}=\frac{\phi}{(u.f.)} = \frac{9820 ^\circ }{32} = 306.9 ^\circ
\end{equation}

Da dette ikke ga riktig antall grader måtte man finne en et nytt utvekslingsforhold:

\begin{equation}\label{key}
\ (u.f.)_{ny}=\frac{\phi}{360^\circ } = \frac{9820^\circ }{360^\circ} = 27.28 ^\circ
\end{equation}

Ny kode blir da:
\begin{lstlisting}
angle = (encoder0Pos * (360.0/2400.0))/27.28;
\end{lstlisting}

Med det nye utvekslingsforholdet funnet til å være 27,28, måles konsistent verdier på$ \approx 360^\circ $ 

Det ble ikke gjort ytterligere forsøk med Arduino for å forbedre nøyaktigheten, da det ble antatt at Mach3 kan gi et annet resultat.

Stigningen for gjengene er 5 mm dette gir:

$$
P = 5 mm
$$
Antall skrue omdreininger per millimeter, $rev_{skrue}$: $$\frac{1}{P} = \frac{1}{5} = 0,25 [\frac{rev}{mm}]$$ 

Motoromdreininger per millimeter ($Teoretisk\ \vee\ Kompensert$): $$rev_{skrue} \cdot utvekslingsforhold\ til\ girboks$$
$$0,25\cdot32 = \underline{8} \qquad\vee\qquad
0,25\cdot27,3 = \underline{6,825}$$

Motorpulser per omdreinging: $2400$ 

Mach3 steps per millimeter: $$2400 \cdot 8 = 19200$$

Mach3 steps per unit = Mach3 steps per rev x Motor revs per unit

For posisjonsgjenkjenning ble det brukt en kvadraturenkoder. Denne har 600 åpninger i skiven sin, og genererer 4 utpulser per åpning, som gir totalt 2400 utpulser. 

$$
P = 5 mm
$$
Antall skrue omdreininger per millimeter, $rev_{skrue}$: $$\frac{1}{P} = \frac{1}{5} = 0,25 [\frac{rev}{mm}]$$ 
Motoromdreininger per millimeter ($Teoretisk\ \vee\ Kompensert$):

\begin{equation}\label{girutv}
rev_{skrue} \cdot utvekslingsforhold\ til\ girboksen\Downarrow\nonumber
0,25\cdot32=\underline{8} \qquad\vee\qquad
0,25\cdot27,3=\underline{6,825}
\end{equation}

Motorpulser per omdreinging: $2400$

Mach3 steps per millimeter: $$$$ \\ $$2400 \cdot 8 = 19200$$
Mach3 steps per unit = Mach3 steps per rev x Motor revs per unit

Andre styringskomponenter:

\begin{itemize}
	\item Nødstoppknapp
	\item "Hjembryter"
	\item Grensebrytere for hver akse (+/-)
	\item Manuell puls generator (MPG)
\end{itemize}

Nødstoppknapp skal være med alle CNC-maskiner for rask tilgang til stopp i tilfelle uønsket drift. Hjembryteren brukes for å signalisere til maskinkontrolleren at verktøyet er en ønsket startstilling. I dette tilfellet, når det sfæriske lageret er midtstilt (slik at rør som føres gjennom ikke bøyes.) Grensebryterne brukes til å signalisere til kontrolleren at en akse er ved sin maksimale grense. I dette tilfellet er det når vognen har flyttet seg $\pm15$\ mm. 
\subsection{CAD til G-code}
Flyten  fra en 3D-modell til G-code er vanligvis som følger:

Solidworks $ \rightarrow $ CAM $ \rightarrow $ Mach3

I prinsippet kan en 3D CAD-fil importeres til et CAM-program som generer G-koder. Disse G-kodene kan så lastes inn i Mach3.
Nødvendig u, for en gitt bøyeradius, R er avhengig av materialet (og rørdiameter?) (Kilde: tubenet) Dersom man bruker u/R forholdet,  9/80 (Kobber, d = 20.0mm, t = 1.0mm) gir dette følgende koordinat: 

\chapter{Resultater}
\section{Analyse}
\section{Testing av rør}

\chapter{Diskusjon}
\section{Prinsipper, Forhold, Generaliseringer}
(Her trekkes man frem hvilke prinsipper, forhold og generaliseringer man kan finne ut i fra resultatene)
\section{Presentasjon av analyse, modell eller teori}

\section{(Utfordringer)}
\section{(Mulige forbedringer)}

\chapter{Konklusjon}

\appendix

\chapter{}
\begin{lstlisting}
#define encoder0PinA 2
#define encoder0PinB 3

volatile unsigned int encoder0Pos = 0 ;

float angle = 0.0;

void setup ( ) {
pinMode( encoder0PinA , INPUT ) ;
pinMode( encoder0PinB , INPUT ) ;

void doEncoderA ( ) ;

void doEncoderB ( ) ;

// encoder pin on interrupt 0 (pin 2)
attachInterrupt (0, doEncoderA , CHANGE) ;

// encoder pin on interrupt 1 (pin 3)
attachInterrupt( 1 , doEncoderB , CHANGE) ;

Serial.begin(9600);
}

void loop ( ) {
//Serial.println (encoder0Pos, DEC);
angle = (encoder0Pos * (360.0/2400.0))/27.3;
Serial.println (angle);
}

void doEncoderA(){
// look for a low-to-high on channel A
if (digitalRead(encoder0PinA) == HIGH) {
//check channel B to see which way encoder us turning
if(digitalRead(encoder0PinB) == LOW)  {
encoder0Pos = encoder0Pos + 1;
}
else {
encoder0Pos = encoder0Pos - 1; // CCW
}

}

else { // must be a high-to-low edge on channel A
// check channel B to see which way encoder is turning
if (digitalRead(encoder0PinB) == HIGH) {
encoder0Pos = encoder0Pos + 1; //CW
}
else {
encoder0Pos = encoder0Pos - 1; // CCW
}
}
}

void doEncoderB ( ) {
// look for a low-to-high on channel B
if (digitalRead(encoder0PinB) == HIGH) {
// check channel A to see which way encoder is turning
if ( digitalRead(encoder0PinA) == HIGH) {
encoder0Pos = encoder0Pos + 1 ; // CW
}
else {
encoder0Pos = encoder0Pos - 1; // CCW
}
}

// Look for a high -to-low on channel B
else {
// check channel B to see which way encoder is turning
if (digitalRead (encoder0PinA) == LOW) {
encoder0Pos = encoder0Pos + 1 ; // CW
}
else {
encoder0Pos = encoder0Pos - 1; // CCW
}
}
}

\end{lstlisting}
\chapter{}
\begin{lstlisting}
% Initialize
clear all
close all
clc

dt = 0.001;
v = 40.33;
a = -1:dt:1;

%Solve function
solution = fsolve(@fcn,1)

%Plot
for i = 1:length(a)
u(i) = v*(1 - cos(a(i)))/(sin(a(i)));
end

plot(a,u)
line([0 solution],[15 15], 'Color','m');
hold on
plot(solution,15,'-o','MarkerIndices',[1])
grid on;

xlim([0 1])
xlabel('a')
ylabel('U')

function x = fcn(a)
v=40.33;
x=(v/sin(a)*(1-cos(a))-15);
end
\end{lstlisting}
\chapter{} 
%\includegraphics[scale=0.49,angle=90,origin=c]{Vedlegg/BakersteVegg}
%
%\includegraphics[scale=0.49,angle=90,origin=c]{Vedlegg/H-bjelke}
%
%\includegraphics[scale=0.49,angle=90,origin=c]{Vedlegg/Plate}
%
%\includegraphics[scale=0.49,angle=90,origin=c]{Vedlegg/mellomplate}
%
%\includegraphics[scale=0.49,angle=90,origin=c]{Vedlegg/veggoye}
%
%\includegraphics[scale=0.49,angle=90,origin=c]{Vedlegg/skinner}
%
%\includegraphics[scale=0.49,angle=90,origin=c]{Vedlegg/Vogn}
%
%\includegraphics[scale=0.49,angle=90,origin=c]{Vedlegg/Skrue}
%
%\includegraphics[scale=0.49,angle=90,origin=c]{Vedlegg/Mutter}
%
%\includegraphics[scale=0.49,angle=90,origin=c]{Vedlegg/Stuss}
%
%\includegraphics[scale=0.49,angle=90,origin=c]{Vedlegg/sferisklager1}
%
%\includegraphics[scale=0.49,angle=90,origin=c]{Vedlegg/sferiskfest1}
%
%\includegraphics[scale=0.49,angle=90,origin=c]{Vedlegg/sferiskfest2}
%
%\includegraphics[scale=0.49,angle=90,origin=c]{Vedlegg/FesteMotor}
%
%\includegraphics[scale=0.49,angle=90,origin=c]{Vedlegg/MotorBrakettX}
%
%\includegraphics[scale=0.49,angle=90,origin=c]{Vedlegg/MotorBrakettY}
%
%\includegraphics[scale=0.49,angle=90,origin=c]{Vedlegg/opplagring}
%
%\includegraphics[scale=0.49,angle=90,origin=c]{Vedlegg/kopling}
%
%\includegraphics[scale=0.49,angle=90,origin=c]{Vedlegg/Matelager}
%
%\includegraphics[scale=0.49,angle=90,origin=c]{Vedlegg/Sylinderfeste}
%
%\includegraphics[scale=0.49,angle=90,origin=c]{Vedlegg/matelagersyl}
%
%\includegraphics[scale=0.49,angle=90,origin=c]{Vedlegg/materplattform}
%
%\includegraphics[scale=0.49,angle=90,origin=c]{Vedlegg/materbjelke}
%
%\includegraphics[scale=0.49,angle=90,origin=c]{Vedlegg/materarm}
%
%\includegraphics[scale=0.49,angle=90,origin=c]{Vedlegg/materfjerholder}
%
%\includegraphics[scale=0.49,angle=90,origin=c]{Vedlegg/materhalvmane}
%
%\includegraphics[scale=0.49,angle=90,origin=c]{Vedlegg/materfjer}

\bibliographystyle{plainnat}
\bibliography{bibliografiDatabase}{}

\end{document}
