ycaf/mas306-rapport/titlepage.tex

% Alternative Options:
%	Paper Size: a4paper / a5paper / b5paper / letterpaper / legalpaper / executivepaper
% Duplex: oneside / twoside
% Base Font Size: 10pt / 11pt / 12pt

\begin{titlepage}

\begin{center}


\vspace{1cm}

{\LARGE
\textsc{Konstruksjon og styring av friform r\o rb\o yemaskin }\\

\vspace{0.5cm}

<Undertittel> \\

\vspace{4.5cm}

{\bf{Ine Lee Steinsland\\ 
		Yasin Chris Aure Fiaz\\}}

\vspace{4cm}

{\bf{Supervisor}} \\
Morten Ottestad

\vspace{3cm}

\vspace{2cm}

University of Agder, 2018 \\
Faculty of Engineering and Science \\
Department of Engineering Sciences

\end{center}
\end{titlepage}
