ycaf/mas306-rapport/rorboyer-Steinsland_Fiaz.pdf

## <Undertittel>

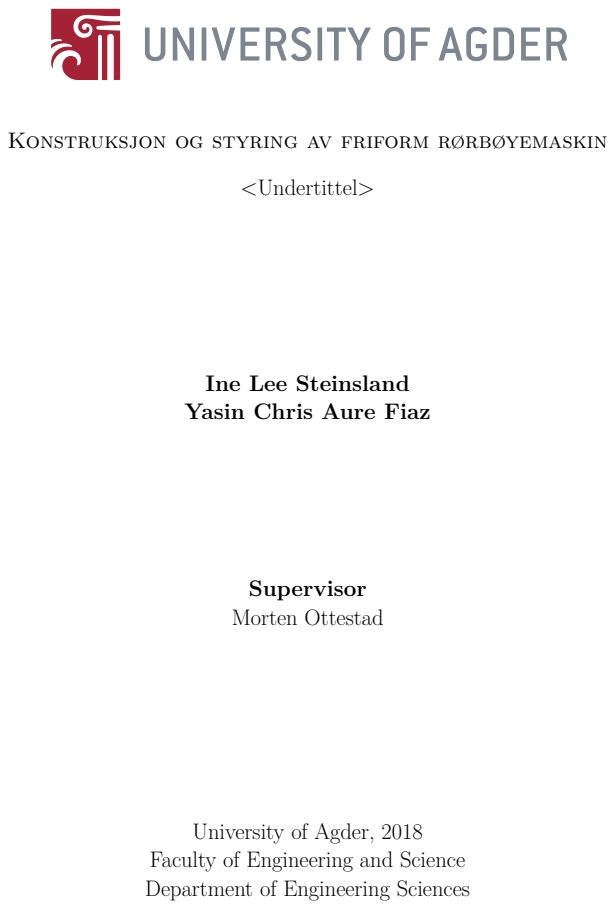
[picture p18: page 1]
Supervisor Morten Ottestad

Konstruksjon og styring av friform rørbøyemaskin

Ine Lee Steinsland
Yasin Chris Aure Fiaz

University of Agder, 2018
Faculty of Engineering and Science
Department of Engineering Sciences

# Takksigelser

Morten Ottestad, Morten Kjeld Ebbesen, Tore Saua, Helge Falkum Igus for hjelp med lager og sponsing(?) av dette

ii

# Abstrakt

iii

# Innhold

List of Figures | vii
List of Tables | viii
1 Introduksjon | 1
2 Teori | 2
3 Konstruksjon og styring | 7
4 Resultater | 19
5 Diskusjon | 20
6 Konklusjon | 21

v

A 22

B 24

C 25

vi

# Figurer

2.1 Krefter på rør | | 3
2.2 Plastisk deformasjon | | 4
2.3 Elastisk deformasjon | | 5
3.1 Konsept 1 | | 7
3.2 Konsept 2 | | 8
3.3 Full illustrasjon av design | | 8
3.4 Skinner | | 9
3.5 Gripemekanisme 1 | | 9
3.6 Gripemekanisme 2 | 10
3.7 Gripemekanisme 3 | 10
3.8 Graf | 11
3.9 Sylinder 1 | 13
3.10 Sylinder 2 | 13
3.11 Y-mekanisme | 14
3.12 X-mekanisme | 15
3.13 Driver | 16

vii

# Tabeller

viii

# Kapittel 1

# Introduksjon

Denne oppgaven er tildelt av fakultet for teknologi og realfag ved Universitet i Agder. Det skal anvendes kunnskap som står i tråd med læringsmålene for en treårig bachelor i mekatronikk.

### 1.1 Metodikk

Dette prosjektet tar for seg å designe og programmere en rørbøyemaskin som skal kunne forme rør uavhengig av lengde, og slike løsninger finnes det lite informasjon om. De fleste rørbøyemaskiner er installert med en dyttemekanisme i bakenden, som resulterer i at de blir store og tar mye plass om de skal kunne ta lange rør. Det ble derfor tatt i bruk SketchUp og SolidWorks for å lage gode løsninger i 3D-format.

### 1.2 Avgrensning

Hovedoppgaven var å designe og konstruere hele rørbøyemaskinen. Gruppen ble dessverre svekket, da et medlem måtte hoppe av prosjektet. Dette gikk utover arbeidsfordelingen som opprinnelig var planlagt. Sammen med veileder ble da oppgaven kortet ned til å kun konsentrere seg om fremparten av maskinen, det gruppen har valgt å kalle XY-bordet.

### 1.3 Eksisterende rørbøyeteknikker

Rørbøying har lenge vært en del av historien, og har vært i stadig utvikling. Det er relativt ukomplisert å bøye et rør. En metode er å gjøre det manuelt ved hjelp av en hydraulisk presse. Man kan bytte ut diene, og dermed enkelt kunne bøye rør med forskjellig diameter. Med disse manuelle pressene settes det begrensninger til utforming av røret, da de kun bøyer i én frihetsgrad. Det er i tillegg tidkrevende.
Et annet alternativ er automatisk hydraulisk rørbøyer. Det er denne type teknikk som vil være den mest sammenlignbare metoden, opp mot oppgavens elektroniske CNC-maskin. En hydraulisk aktuator vil kunne oppnå et høyt moment på små maskinerW. Pawlus [2016]. Den vil ta litt større plass da aktuatoren må stå ved maskinen, hvor en elektrisk styrt aktuator kan plasseres uavhengig av maskinen. Det vil være noen fordeler med en hydraulisk maskin, men de mange fordelene med elektronikk vil veie mot. Slik som at en hydraulisk maskin vil ha høyere støynivå, vedlikehold med oljeskift og presisjon.

# Kapittel 2

# Teori

### 2.1 CNC-styring

Computer Numerical Control er elektroniske maskiner som utfører arbeid etter et forhåndsinnstilt program. CNC-styring er avkommet etter Computer Aided Design og Computer Aided Manufacturing (CAD/CAM) produksjoner Network.
De første numerisk styrte maskinene ble utviklet i USA på 1950-tallet. Det ble behov for maskiner som kunne produsere kompliserte og nøyaktige deler til fly. Etterhvert som elektronikken fikk mer innflytelse i maskinindustrien ble det tatt i bruk mikroprosessorer. Dette la grunnlaget for dagens databasert numeriske maskiner (CNC)Industriskolen. Mikroprosessorene gjorde det mulig å lagre opp til flere forhåndsprogrammerte programmer i hukommelsen til maskinen og lettere å rette opp feil i programmet. Hvor man tidligere måtte lage nye program kunne man nå rette dem opp i hukommelsen. Man tok også i bruk datamaskinens regnekunnskaper for å lettere regne ut koordinatene til maskinens posisjon.
Programformatet for bruk av koding i CNC-styrte maskiner er regulert av den internasjonale standarden ISO 6983/1 og ISO 6983/2. Dette språket består av G- og M-funksjoner. G-funksjonene er forberedende funksjoner som plassering i X,Y,Z-planet, økende/minkende, høyre/venstre, valg av lengde/hastighet og slike ting. M-funksjonene er hjelpende funksjoner som stopp/start, på/av Industriskolen.

### 2.2 Kaldbearbeiding

### 2.3 Gripemekanisme

Den mest vanlige metoden for mating av rør i eksisterende CNC-rørbøyemaskiner er å montere en dyttemekanisme i enden av maskinen. Det setter begrensninger til hvilken rørlengde det er mulig å jobbe med. Maskinen som skal konstrueres i denne oppgaven skal, i teorien, kunne ta en uendelig lengde. For å få dette til må det en form for gripemekanisme til. Det er viktig at mekanismen kan fungere godt med runde og glatte overflater. Og at det er høy friksjon mellom gjenstanden som skal ta tak i røret og røret. Balansen mellom å ta tak nok og for mye er veldig fin. Det er hensiktsmessig at mekanismen ikke griper så hardt at det blir skade eller deformasjon på røret. For å få dette til er det mulig å bruke prinsippet til en lift-tong. Den lift-tong vil gripe med en kraft som er proporsjonal med vekten til gjenstanden den skal løfte Sclater [2011]. Dette prinsippet må anvendes på en måte slik at den kan brukes på en horisontal kraft.

### 2.4 Belastninger

For å ha få en oversikt over hvilke krefter som virker på røret når det bøyes, settes opp et enkelt FLD (Free-Body-Diagram), som er illustrert i figur 2.1. Det er satt opp et lokalt koordinatsystem som følger aksen til røret. Det er kraften PL som sier noe om hvor stort moment som trengs for å dytte røret i X-retning, og den kraften som er viktigst å finne ut for å kunne vite om motoren har stor nok kraft til å klare oppgaven.


Figur 2.1: Enkelt FLD av kreftene som virker på røret

u = ρ · (1 − cosα) | (2.1)
V = ρ · sinα | (2.2)

Hvor:
u=Forskyvning på skinnene
V =Avstand fra stuss og senter av sfærisk lager α=Bøyeradius i radianer
ρ= Radius av bøyen på røret

V og u er konstanter som kan hentes ut i fra konstruksjonen. Vi sitter da igjen med to ligninger og ukjent. Ved å løse ligning 2.2 med hensyn på ρ, og sette den nn i ligning 2.1 får vi

u =

V
sinα
- (1 − cosα) | (2.3)

Denne ligningen kan løses grafisk. Ved å finne det maksimale u kan være, finner man den maksimale bøyeradien som er mulig å oppnå. Det er da mulig å løse ligning 2.4 og finne ρ.

ρ =

u
1 − cosα

(2.4)

For at røret skal få varig derformasjon må det over flytegrensen, slik at det får en plastisk deformasjon. Dette vil i teorien skje i ytterpunktene av røret. Mens i midten vil holde seg under flytegrensen. For å finne denne grensen bruker man

y =

−y
ρ

(2.5)

σy | = E · y ⇓
y | =

σy
E

(2.6)

Dette gir
−y
ρ

=

σy
E

⇓

y =

−σy · ρ
E

(2.7)

Hvor:
y=Tøyning
y= Avstanden fra senter av røret til den plastiske deformasjonen begynner ρ= Radiusen av bøyen på røret
E=Elasitetsmodulen
σy=Flytegrensen til metallet

I figur 2.2 er det illustrert med to røde streker hvor overgangen fra den elastiske deformasjonen til plastisk deformasjon vil skjer. Lengden y er ukjent, så nøyaktig hvor dette skille går finner man ikke ut før man har løst ligning 2.7.


Figur 2.2: llustrasjon om hvor det plastiske området begynner

R

2
1 = b

2
1 + y

2 ⇓

b1 =

q
R²
1 − y
2 | (2.8)

R

2
2 = b

2
2 + y

2 ⇓

b2 =

q
R²
2 − y
2 | (2.9)

Momentet som trengs for å komme opp i plastisk deformasjon er utledet ut i fra figur 2.2.

MP =

Z

F

ydF ⇓

=

Z R1

y1

y · σy · 2b1dy −

Z R2

y1

y · σy · 2b2dy ⇓

=

2
3
- σy((R

2
1 − y

2/1)

3
2 − (R

2
2 − y

2/1)

3
2 ) | (2.10)

Hvor:
MP=Moment for å oppnå plastisk deformasjon σy=Flytegrensen
b1=Bredden fra senterlinje til yttersiden av røret b2=Bredden fra senterlinje til innsiden av røret R1=Ytre radius
R2=Indre radius
y1= Grensen til plastisk deformasjon

Momentene som regnes ut i ligning 2.10 og 2.11 er kun for halve høyden av røret, så svaret må ganges med to. I figur 2.3 er samme rør illustret på nytt, men denne gangen med hensyn på den elastiske deformasjonen. Det er

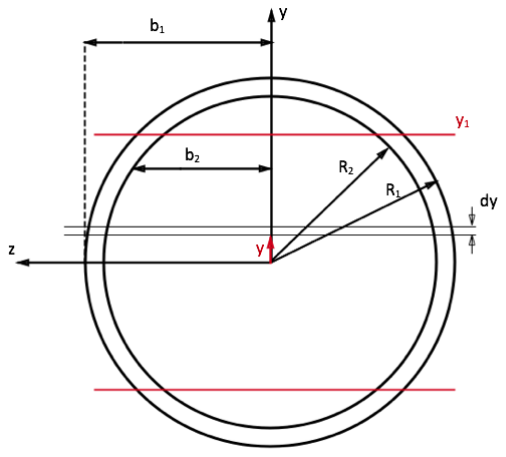
[picture p19: figure]

Figur 2.3: Illustrasjon av hvor det elastiske området vil befinne seg

ME =

Z

F

ydF ⇓

| =

Z

A

y · σydA ⇓

| =

Z y1

0

y ·

σy
y1
- y · 2b1dy −

Z y1

0

y ·

σy
y1
- y · 2b2dy ⇓

= 2

σy
y1
- (−y1

(R²
1 − y

2/1)

3
2
4

) +

R²
1
- y1

q
R1 − y

2
1
8

+

R⁴
1
8
- arcsin

y1
R1

− 2

σy
y1
- (−y1

(R²
2 − y

2/1)

3
2
4

) +

R²
2
- y1

q
R2 − y

2
1
8

+

R⁴
2
8
- arcsin

y1
R2

(2.11)

Hvor:
ME=Momentet for å oppnå elastisk deformasjon σy=Flytegrensen
b1=Bredden fra senterlinje til yttersiden av røret b2=Bredden fra senterlinje til innsiden av røret R1=Ytre radius
R2=Indre radius
y1= Avstanden opp til plastisk deformasjon

ME + MP | = V · N1 ⇓
N1 | = ME + MP V
(2.12)

Hvor:
ME=Momentet for å oppnå elastisk deformasjon MP=Momentet for å oppnå plastisk deformasjon N1=Kraften som står vinkelrett på røret

XFx = 0N = −PL + N1 · cos(π 2

− α) ⇓
PL = N1 · cos(π
2
− α) | (2.13)

Hvor:
PL=Kraften som må til for å dytte røret N1=Kraften som står vinkelrett på røret

# Kapittel 3

# Konstruksjon og styring

(Her beskrives fremgangsmåten i detalj slik at resultatet kan reproduseres av andre)

### 3.1 Utstyr

Før planleggingen av designet var det hensiktsmessig å gå over lagret, for å få en oversikt over hva som var tilgjengelig og hva som eventuelt måtte kjøpes inn. Vi hadde tilgang på ledeskruer med tilhørende mutter, samt skinner med vogn som sklir lett frem og tilbake. Dette skulle implementeres for å kunne laget et plan som kunne bøye røret i X- og Y-retning, og føre røret fremover. Det resterende som manglet for å kunne konstruere en full rørbøyemaskin måtte tegnes og konstrueres selv, ved hjelp av SolidWorks og SketchUp.
Programvaren som skal brukes for å styre X-Y-Z-planet er Mach3. Dette er et mye brukt kontrollsystem for CNC-maskiner. Det virker bra i CAD/CAM produksjoner, som med laserkuttere og fres for å nevne noen.

### 3.2 Design

Hele prosessen med oppgaven startet med designet. Flere maskiner ble undersøkt for å få inspirasjon til design. Og det ble relativt tidlig laget et utkast av en maskin, som vises i figur X. Men maskinen var installert med dyttemekanisme bak. Så den måtte re-designes. I figur X ser man det neste konseptet som ble designet. I denne designfasen ble den fremste delen av maskinen, den delen som skal bevege seg i X-Y-planet, videreutviklet. Utfordringene kom når midt-delen, med en matemekanisme, skulle tegnes. Denne prosessen er forklart nærmere i de videre kapitlene angående gripemekanismen og rotasjon av rør.


Figur 3.1: Første konseptet

Det er lagt mye arbeid i at maskinen skal være kompakt, slik at den tar lite plass. Den endelig maskinen er designet med i alt tre motorer og en lineær-sylinder. Det er plassert en motor på bakerste del for å styre skruen i Z-retning. Denne jobber sammen med lineær-sylinderen for å


Figur 3.2: Det andre konseptet

rotere røret i spesifikke grader. En motor er festet på undersiden av XY-bordet for å styre skruen i Y-retning og en tredje motor på siden for å styre skruen i X-retning. I figur X er hele konstruksjonen illustrert, hvor røret blir matet i Z-retning mot venstre.


Figur 3.3: Full illustrasjon av design

### 3.3 Materialer

Alle materialene som måtte produseres fra bunnen av er tiltenkt å være i stål. Stålplatene er på 10mm med hull som er tilpasset de ferdigproduserte skinnene. Disse passer til en M8 bolt. Skinnene og vognene er av aluminium, så ingen av delen kunne sveises til stålplatene. I figur X ser man en skinne og vogn montert fast i en plate.

Det er brukt lager fra Igus til opplagring av skruer og stussen. Disse er laget i plastikk, og trenger ingen vedlikehold eller smøring Igus. Lagrene som er valgt ut for X-og Y-skrue kan tåle opp til 120 MPa IgusQ2. Og lageret som er valgt ut til stussen tåler opp til 80MPa IgusG


Figur 3.4: Her er skinene og vognen montert på en av stålplatene som skal styre øyet


Figur 3.5: Den første ideen til gripemekanisme

### 3.4 Mating av rør

Prosessen med å finne en mekanisme for å mate røret i Z-retning var den mest krevende. En av de første ideene var en lift-tong festet til en ledeskrue, med to halvmåner som tar tak i røret. Ideen var at halvmånene skulle klemme til når skruen gikk i positiv retning, og løse opp når den skulle gå i negativ retning for å hente mer rør. Problemet med denne løsningen er at den bare tar tak i nedre del av halvmånen. Når dette skal rotere vil det skape et uønsket moment. Dette ble løst ved å montere på en til klype på toppen av halvmånene, og laget et slags hus. Men ved nærmere ettertanke ble det avklart at det ble for avansert å produsere. Det var det nåværende gripehuset ble konstruert. Det er større og mer robust, og skal fungere på samme måte med at det griper til i positiv retning og slipper opp i negativ retning. Dette kan enklere produseres da det er brukt forskjellige typer standardiserte stålkomponenter. I motsetning til de første to ideene hvor lift-tongen måtte vært skjært ut i ulike former.


Figur 3.6: Den andre ideen til gripemekanisme


Figur 3.7: Den endelige gripemekanismen

### 3.4.1 Gripehus

I fra figur 2.1 ser man at det kommer en kraft PL på røret. Det er denne kraften som trengs for å kunne føre og bøyet røret. For å finne denne, må ligning 2.1 - 2.13 anvendes. Hvis man tar utgangspunktet i at det skal bøyes et rør med flytegrenser σy = 195MP a og E-modul E = 210GP a. Et rør med tykkelse t = 2, 65mm gir en ytre radius R1 = 16, 85mm og indre radius R2 = 14, 2mm. u er den maksimale skyvningen skinnene kan ha i X- og Y-retning før det sfæriske lageret går ut av posisjon. Og den er funnet til å være u = 15mm. V er avstanden fra stussen til senter av det sfæriske lageret. Ut i fra konstroksjonen kan man lese av at denne er V = 40.33mm.

u =

V
sinα
- (1 − cosα) | (3.1)

Ut i fra figur 3.8 kan man se av α = 0,712 rad

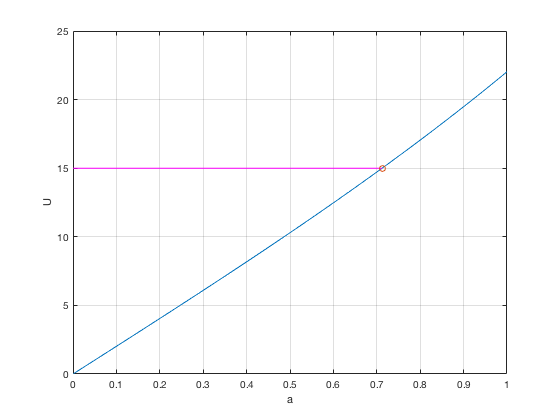
[picture p20: figure]

Figur 3.8: Grafen viser sammenhengen mellom u og α

ρ =

u
1 − cos α

=

15mm
1 − cos 0, 712
= 61, 717mm | (3.2)

y =

−σy · ρ
E

=

−(−195MP a) · 61, 717mm
210 · 10³MP a
= 0, 057mm | (3.3)
MP | =

2
3
- σy((R

2
1 − y

2/1)

3
2 − (R

2
2 − y

2/1)

3
2 )

=

2
- 195MP a(((16, 85mm)

2 − (0, 057mm)

2
)

3
2 − ((14, 2mm)

2 − (0, 057mm)

2
)

3
2 )
= 249703, 099Nmm | (3.4)

Dette er kun momentet for å komme opp i plastisk deformasjon for halve røret. For å få et korrekt tall for hele røret, må svaret ganges med to. Så dette gir at det fullstendige momentet som må til er

MP | = 2 · 249703, 099
= 499406, 198Nmm | (3.5)
ME | = 2 ·

195MP a
0, 057mm
- (−0, 057mm

((16, 85mm)

2 − (0, 057mm)

2
)

3
2
4

)

+

(16, 85mm)

2
- 0, 057mmp
(16, 85mm)

2 − (0, 057mm)

2
8

+

(16, 85mm)

4
8
- arcsin

0, 057mm
16, 85mm

− 2 ·

195MP a
0, 057mm
- (−0, 057mm

((14, 2mm)

2 − (0, 057mm)

2
)

3
2
4

)

+

(14, 2mm)

2
- 0, 057mmp
(14, 2mm)

2 − (0, 057mm)

2
8

+

(14, 2)⁴
8
- arcsin

0, 057mm
14, 2mm
= 9, 892Nmm − 8, 336Nmm
= 1, 555Nmm | (3.6)

I dette tilfellet er det også bare regnet ut den elastiske deformasjonen for halve røret. Så dette svaret på også ganges med to.

ME | = 2 · 1, 555Nmm
= 3, 111Nmm | (3.7)
N1 | =

ME + MP
V

=

3, 111Nmm + 499406, 198Nmm
40, 33mm
= 12383, 073N | (3.8)
PL | = N1 · cos(π
2

− α)
= 12383, 073 · cos(π
2

− 0, 712rad)

= 8091, 923N | (3.9)

### 3.4.2 Opplagring

### 3.5 Rotasjon av rør

Ifølge kravspesifikasjonen skal røret kunne rotere ±45◦
. Maksimalt nødvendig moment for å kunne rotere røret oppstår når røret roteres mot bøyeretningen. Det vil være avhengig av friksjonen pga. Pu og smøring i det sfæriske lageret.


Figur 3.9: Første ide til hvordan rotere røret

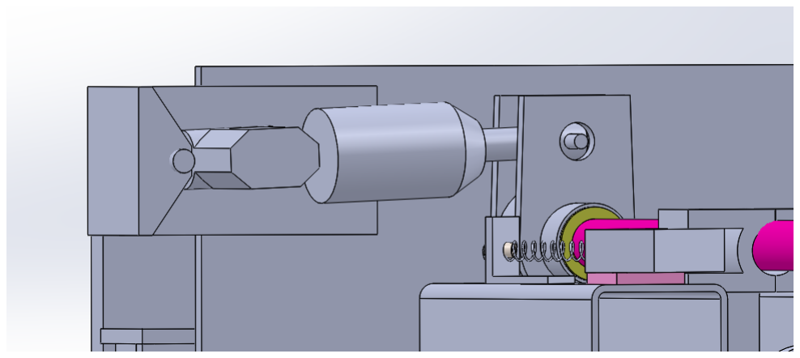
[picture p21: figure]

Figur 3.10: Hvordan rotasjonsmekanismen ble seende ut til slutt

### 3.5.1 Elektrisk sylinder

### 3.6 Bøyemekanisme

### 3.6.1 Sfærisk lager

### 3.7 XY-bord

Systemet er basert på samme prinsipp som en fres. XY-bordet fungerer på samme måte som et verktøy som beveger seg i XY-planet. Matingen i Z-aksen tilsvarer Z-bevegelsen til verktøyet, og rotasjonen av røret tilsvarer «spindle-speed».

I det gitte senarioet i figur 2.1 vil den maksimale kraften som utsetter på skruen være

N1 − cos α. I og med at røret bøyes i Y-retning, i forhold til koordinatsystemet til maskinen, vil skruen i Y-retning ta opp all kraften. Hadde man tatt samme senario, men vridd røret så det bøydes med samme grader i X-retning, ville det vært skruen i X-retning som tok opp kreftene. Man kan da konkludere med at skal man fordele kreftene mellom de to skruene vil det være hensiktsmessig å rotere røret slik at det sto midt i planet mellom X og Y.

Vi fant den maksimale bøyeradien maskinen kan oppnå til å være alpha=0.712 rad. Det betyr at den maksimale kraften hver skrue vil være utsatt for, ved det mest ekstreme tilfelle vil være

N1 − cos α = 12383, 072N − cos 0, 712 = 8818, 667N


Figur 3.11: Bildet viser hvordan Y-mekanismen er designet


Figur 3.12: Bilde viser hvordan X-mekanismen er designet

### 3.7.1 Ledeskinne

### 3.7.2 Ledeskrue

### 3.7.3 Motorer

### 3.8 Motordrivere

### 3.9 Mach3-software

Systemet er basert på samme prinsipp som en fres. XY-bordet fungerer på samme måte som et verktøy som beveger seg i XY-planet. Matingen i Z-aksen tilsvarer Z-bevegelsen til verktøyet, og rotasjonen av røret tilsvarer «spindle-speed».

Figur 1: Sammenheng mellom tradisjonell fres og rørbøyer

Driver – DCS810 Motorstyringen skal skje ved hjelp av en motor driver av typen DCS810. Dette er en servo-driver som konverterer et lav-spennings kontroll-signal om til høy-spenningssignal som driver motoren. Driveren har Prosjektet er basert på å bruke material og utstyr som er lett tilgjengelig I tråd med dette blir det benyttet en «single-ended» enkoder i motsetning til en differensial enkoder. I tillegg, så er det i utgangspunktet snakk om korte kabellengder.

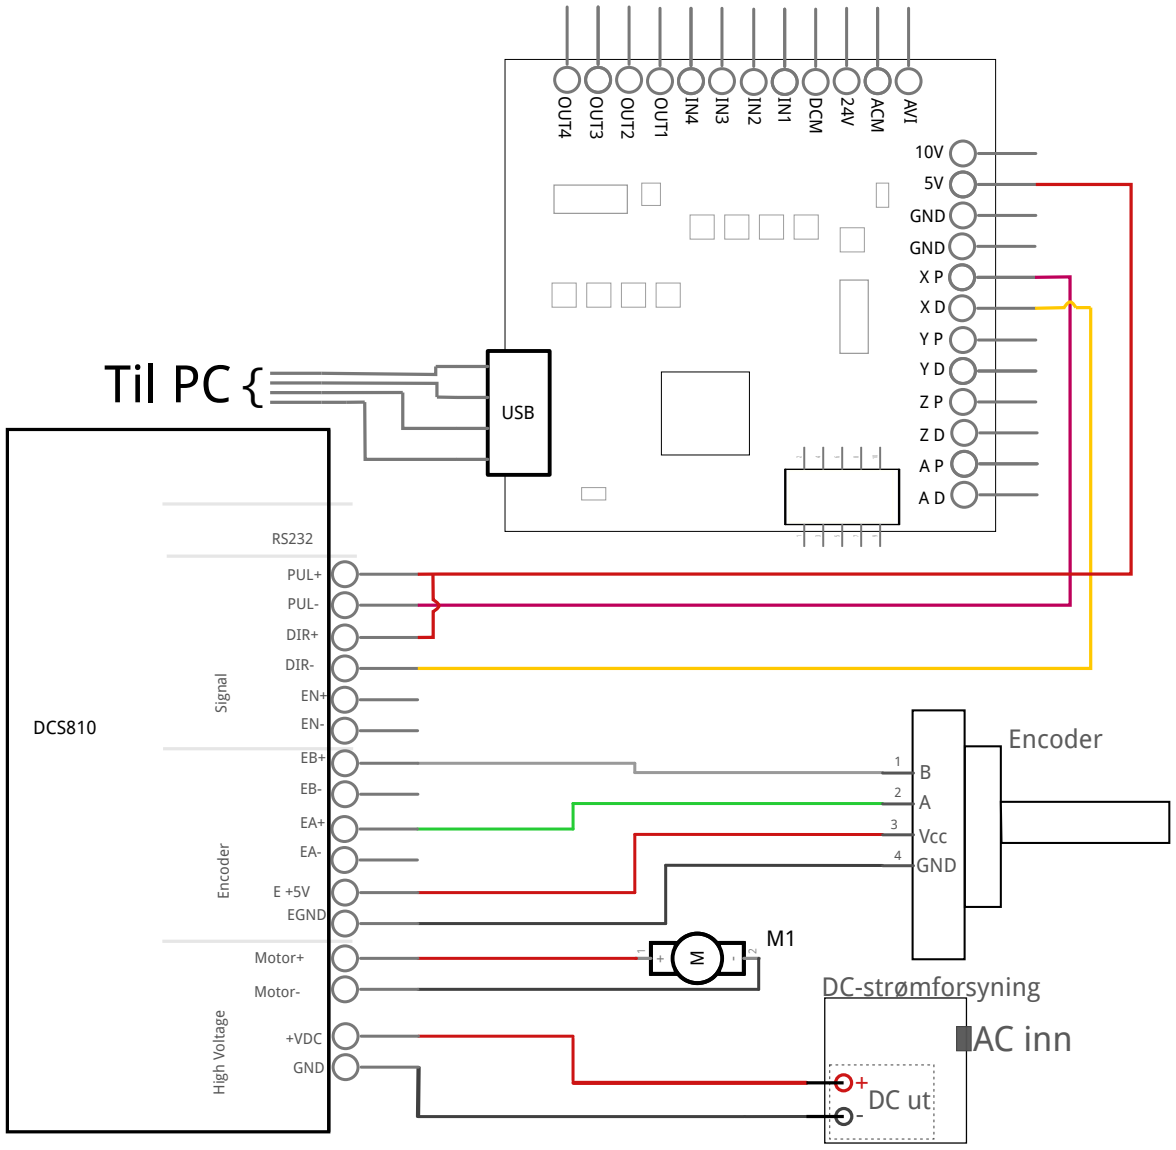
[picture p22: figure]
DCS810; PUL+; PUL-; DIR+; DIR-; E +5V EGND; Motor+; Motor-; +VDC; GND; High Voltage Encoder Signal; Vcc GND; Encoder; GND X P X D; OUT4; OUT3; OUT2; OUT1; DCM; ACM; AVI; AVR SPI; PROG; MOSI; RESET; SCK; MISO; USB; Til PC {; AC inn; DC-strømforsyning

Figur 3.13: Tilkoblinger til driveren for x-aksen

Kontroller Kontrolleren som ble benyttet er en BSMCE04U-PP. Den bruker USB-tilkobling til PC og vil gjenkjennes av Mach3.
Figur 3: Koblingsskjema av kontroller til driver
Pulsing
For å finne nødvendige antall pulser som Mach3 skal sende, må man vite noe om hele drivsystemet, dvs. motor, enkoder, gir og ledeskrue.
Utvekslingsforholdet ble målt på to forskjellige måter og ga to forskjellige resultater. Det ble først målt uten enkoder. Det foregikk ved å vri enkoder-akselen til akselen ut av girboksen (last akselen) hadde gått en omdreining. Utvekslings forholdet ble da målt til 32:1. Det ble antatt at enkoder-akselen har samme utvekslingsforhold som ut fra motoren til girboksen.
Den andre metoden gikk ut på å koble enkoderen til en Arduino som vist i figur [nr]. Se for øvrig kode i tillegg [nr]. Motoren ble koblet til en variabel strømforsyning.
Figur: Arduino-krets
Deretter ble motoren kjørt flere ganger mens enkoder-verdier ble lest av i Arduino-IDEens seriellmonitor.
Ardiuno teller hvert step og lagrer dette i variabelen encoder0P os for å få dette omgjort til grader brukes følgende linje med kode:

angle = encoder0Pos ∗ ( 3 6 0. 0 / 2 4 0 0. 0 ) ;

Dette vil gi verdier som ligger rundt 9820 for en rotasjon av lastakselen. Siden man fra før hadde funnet utvekslingsforholdet til å være 32 : 1. Dette gir antall grader som følger:

θmaks =

φ
(u.f.)

=

9820◦
32

= 306.9

◦
(3.10)

Da dette ikke ga riktig antall grader måtte man finne en et nytt utvekslingsforhold:

(u.f.)ny =

φ
360◦

=

9820◦
360◦

= 27.28◦
(3.11)

Ny kode blir da:

angle = ( encoder0Pos ∗ ( 3 6 0. 0 / 2 4 0 0. 0 ) ) / 2 7 . 2 8 ;
Med det nye utvekslingsforholdet funnet til å være 27,28, måles konsistent verdier på≈ 360◦
Det ble ikke gjort ytterligere forsøk med Arduino for å forbedre nøyaktigheten, da det ble antatt at Mach3 kan gi et annet resultat.
Stigningen for gjengene er 5 mm dette gir:

P = 5mm

Antall skrue omdreininger per millimeter, revskrue:

1
P

=

1
5

= 0, 25[ rev
mm

]

Motoromdreininger per millimeter (T eoretisk ∨ Kompensert):

revskrue · utvekslingsforhold til girboks

0, 25 · 32 = 8 | ∨ | 0, 25 · 27, 3 = 6, 825

Motorpulser per omdreinging: 2400
Mach3 steps per millimeter:
2400 · 8 = 19200

Mach3 steps per unit = Mach3 steps per rev x Motor revs per unit
For posisjonsgjenkjenning ble det brukt en kvadraturenkoder. Denne har 600 åpninger i skiven sin, og genererer 4 utpulser per åpning, som gir totalt 2400 utpulser.

P = 5mm

Antall skrue omdreininger per millimeter, revskrue:

1
P

=

| 1
| 5 | = 0, 25[ rev mm ]

Motoromdreininger per millimeter (T eoretisk ∨ Kompensert):

revskrue · utvekslingsforhold til girboksen ⇓ 0, 25 · 32 = 8 | ∨ | 0, 25 · 27, 3 = 6, 825

Motorpulser per omdreinging: 2400
Mach3 steps per millimeter:

2400 · 8 = 19200

Mach3 steps per unit = Mach3 steps per rev x Motor revs per unit Andre styringskomponenter:

- Nødstoppknapp
- "Hjembryter"
- Grensebrytere for hver akse (+/-)
- Manuell puls generator (MPG)

Nødstoppknapp skal være med alle CNC-maskiner for rask tilgang til stopp i tilfelle uønsket drift. Hjembryteren brukes for å signalisere til maskinkontrolleren at verktøyet er en ønsket startstilling. I dette tilfellet, når det sfæriske lageret er midtstilt (slik at rør som føres gjennom ikke bøyes.) Grensebryterne brukes til å signalisere til kontrolleren at en akse er ved sin maksimale grense. I dette tilfellet er det når vognen har flyttet seg ±15 mm.

### 3.9.1 CAD til G-code

Flyten fra en 3D-modell til G-code er vanligvis som følger:
Solidworks → CAM → Mach3
I prinsippet kan en 3D CAD-fil importeres til et CAM-program som generer G-koder. Disse Gkodene kan så lastes inn i Mach3. Nødvendig u, for en gitt bøyeradius, R er avhengig av materialet (og rørdiameter?) (Kilde: tubenet) Dersom man bruker u/R forholdet, 9/80 (Kobber, d = 20.0mm, t = 1.0mm) gir dette følgende koordinat:

# Kapittel 4

# Resultater

### 4.1 Analyse

### 4.2 Testing av rør

# Kapittel 5

# Diskusjon

### 5.1 Prinsipper, Forhold, Generaliseringer

(Her trekkes man frem hvilke prinsipper, forhold og generaliseringer man kan finne ut i fra resultatene)

### 5.2 Presentasjon av analyse, modell eller teori

### 5.3 (Utfordringer)

### 5.4 (Mulige forbedringer)

# Kapittel 6

# Konklusjon

# Tillegg A

#d e f i n e encoder0PinA 2

#d e f i n e encoder0PinB 3

v o l a t i l e un si gned i n t encoder0Pos = 0 ;

f l o a t angle = 0 . 0 ;

v oid setup ( ) {
pinMode ( encoder0PinA , INPUT ) ; pinMode ( encoder0PinB , INPUT ) ;

v oid doEncoderA ( ) ;

v oid doEncoderB ( ) ;

// enc ode r pin on i n t e r r u p t 0 ( pin 2 )
attachInterrupt ( 0 , doEncoderA , CHANGE ) ;

// enc ode r pin on i n t e r r u p t 1 ( pin 3 )
attachInterrupt ( 1 , doEncoderB , CHANGE ) ;

Serial . begin ( 9 6 0 0 ) ;
}

v oid loop ( ) {
// S e r i a l . p r i n t l n ( encoder0Pos , DEC) ;
angle = ( encoder0Pos ∗ ( 3 6 0. 0 / 2 4 0 0. 0 ) ) / 2 7 . 3 ;
Serial . println ( angle ) ;
}

v oid doEncoderA ( ) {
// l o o k f o r a low−to−hi gh on ch annel A
i f ( digitalRead ( encoder0PinA ) == HIGH ) {
// check ch annel B t o s e e which way enc ode r us t u r ni n g
i f ( digitalRead ( encoder0PinB ) == LOW ) {
encoder0Pos = encoder0Pos + 1 ;
}
e l s e {
encoder0Pos = encoder0Pos − 1 ; // CCW
}

}

e l s e { // must be a high−to−low edge on ch annel A
// check ch annel B t o s e e which way enc ode r i s t u r ni n g
i f ( digitalRead ( encoder0PinB ) == HIGH ) {
encoder0Pos = encoder0Pos + 1 ; //CW
}
e l s e {
encoder0Pos = encoder0Pos − 1 ; // CCW
}
}
}

v oid doEncoderB ( ) {
// l o o k f o r a low−to−hi gh on ch annel B
i f ( digitalRead ( encoder0PinB ) == HIGH ) {
// check ch annel A t o s e e which way enc ode r i s t u r ni n g
i f ( digitalRead ( encoder0PinA ) == HIGH ) {

encoder0Pos = encoder0Pos + 1 ; // CW
}
e l s e {
encoder0Pos = encoder0Pos − 1 ; // CCW
}
}

// Look f o r a hi gh −to−low on ch annel B
e l s e {
// check ch annel B t o s e e which way enc ode r i s t u r ni n g
i f ( digitalRead ( encoder0PinA ) == LOW ) {
encoder0Pos = encoder0Pos + 1 ; // CW
}
e l s e {
encoder0Pos = encoder0Pos − 1 ; // CCW
}
}
}

# Tillegg B

% Initialize
clear all
close all
clc

dt = 0 . 0 0 1 ;
v = 4 0 . 3 3 ;
a = −1:dt : 1 ;

%Solve function
solution = fsolve ( @fcn , 1 )

%Plot
f o r i = 1 : length ( a )
u ( i ) = v ∗( 1 − cos ( a ( i ) ) ) / ( sin ( a ( i ) ) ) ;
end

plot ( a , u )
line ( [ 0 solution ] , [ 1 5 1 5 ] , ' C ol o r ' , 'm' ) ;
hold on
plot ( solution , 1 5 , '−o ' , ' M a r k e r I n di c e s ' , [ 1 ] )
grid on ;

xlim ( [ 0 1 ] )
xlabel ( ' a ' )
ylabel ( 'U' )

function x = fcn ( a )
v = 4 0. 3 3;
x=(v/ sin ( a ) ∗(1−cos ( a ) ) −15) ; end

# Tillegg C

# Bibliografi

Igus. igubalÂ® spherical bearings. URL https://www.igus.no/wpck/11041/banderole_igubal.

IgusG.

IgusQ2. iglidurÂ® q2, sleeve bearing with flange, mm. URL https://www.igus.no/product/?artnr=Q2FM-2023-21. (https://www.igus.no/product/?artnr=Q2FM-2023-21)

Industriskolen. Grunnlegende innfÃ¸ring i cnc-teknikk. URL http://www.niskolen.no/pil/Medlem/Kurs/cnc_teknikk/story_content/external_files/CNC_VG2.pdf. (http://www.niskolen.no/pil/Medlem/Kurs/cnc_teknikk/story_content/external_files/CNC_VG2.pdf)

Norsk Datakunnskap Network. | Hva er cnc-maskiner. | URL http://www.datamaskin.biz/
Programmering/computer-programming-languages/88807.html#.WtSP6C_JLL8. (http://www.datamaskin.biz/Programmering/computer-programming-languages/88807.html#.WtSP6C_JLL8)

Neil Sclater. Mechanisms and Mechanical Devices. The McGraw-Hill Companies, fifth edition, 2011. Page:247.

M.R. Hansen W. Pawlus, M. Choux. Hydraulic vs. electric: A review of actuationsystems in offshore drilling equipment. Modeling, Identification and Control, (1):4–6, 2016.
