ycaf/mas306-rapport/BildeYX.PNG

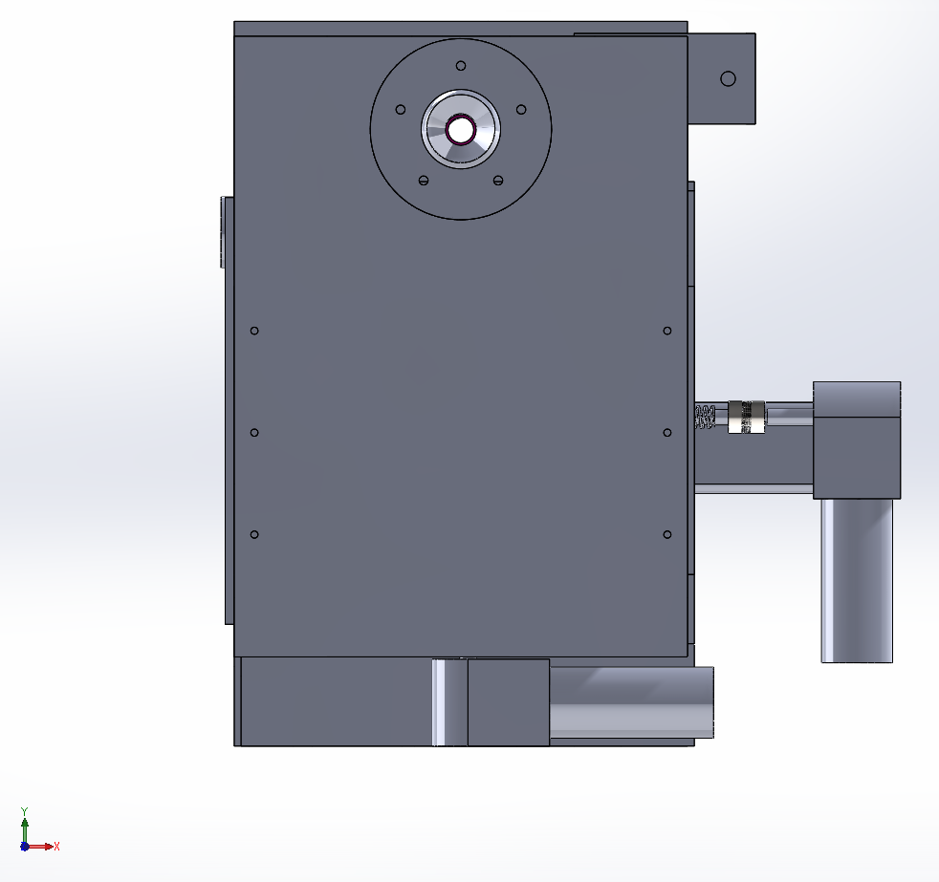
BildeYX.PNG
