ycaf/mas306-rapport/BildeYZ.PNG

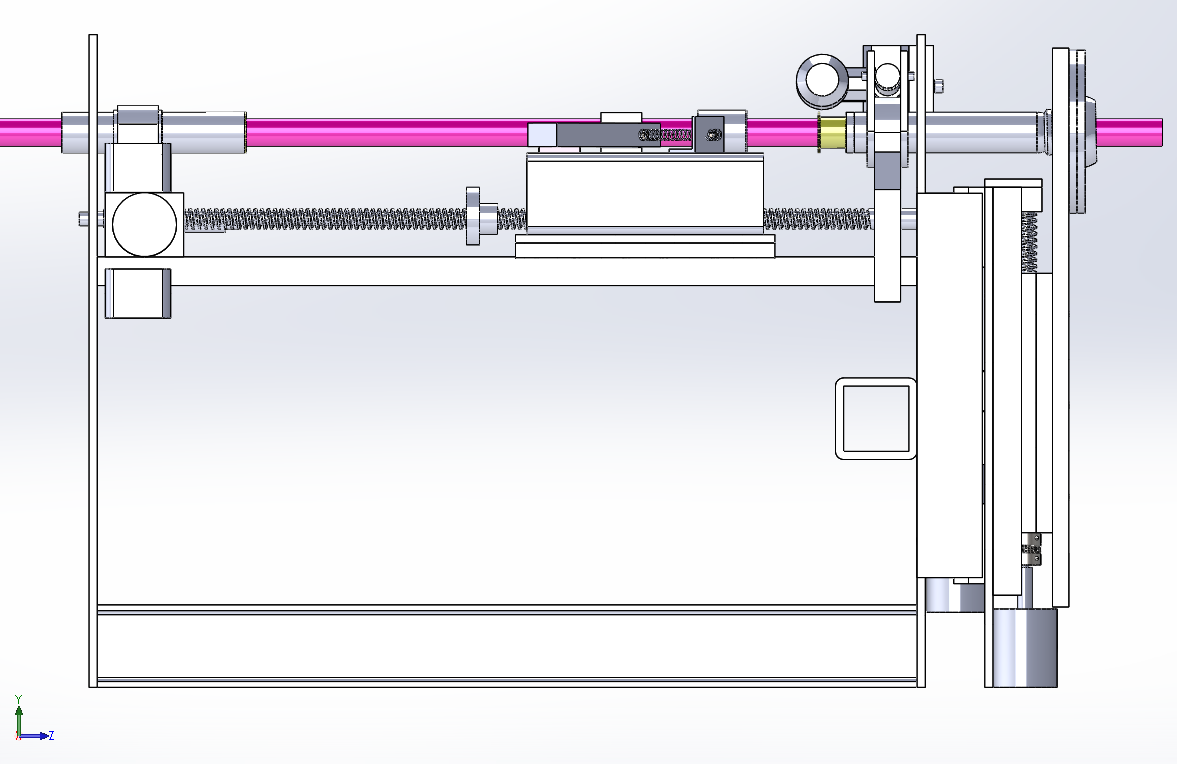
BildeYZ.PNG
