ycaf/mas306-rapport/IMG_E1822.jpg

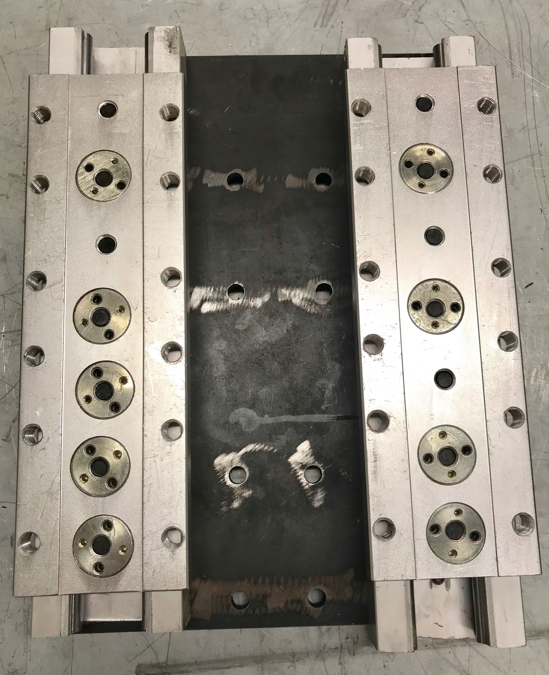
IMG_E1822.jpg
