ycaf/mas306-rapport/Overblikk.PNG

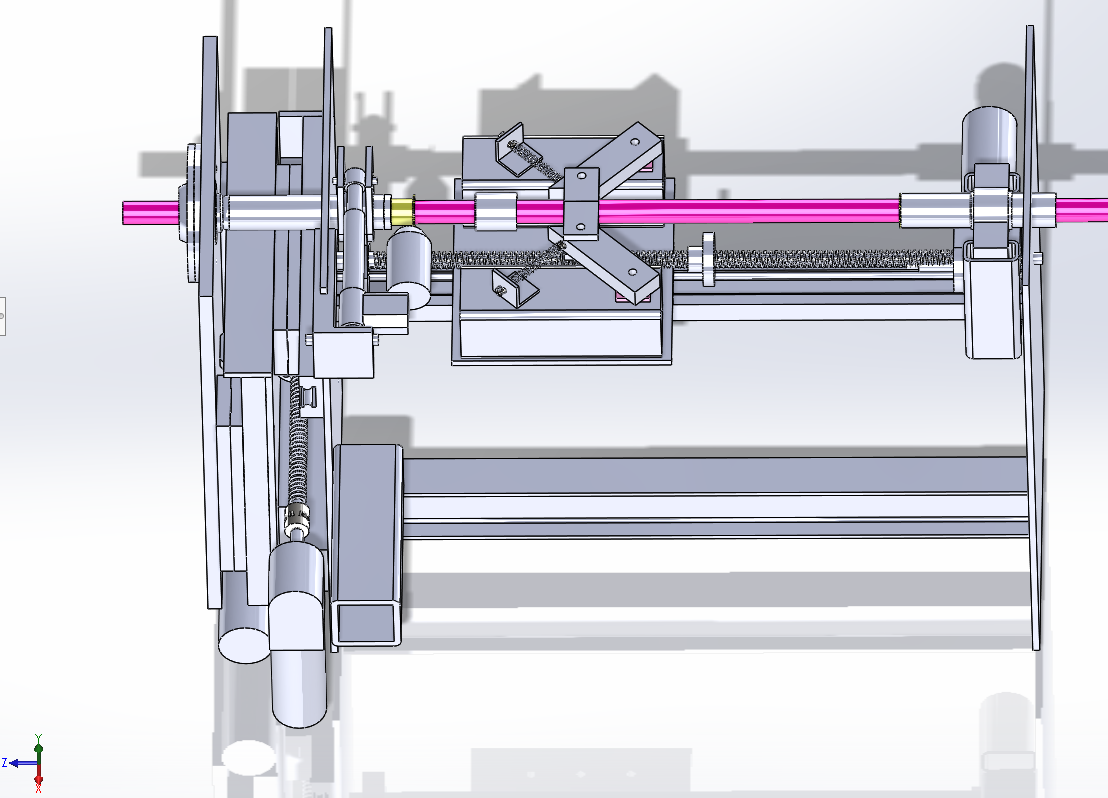
Overblikk.PNG
