ycaf/mas306-rapport/Pics/Halvkutt.png

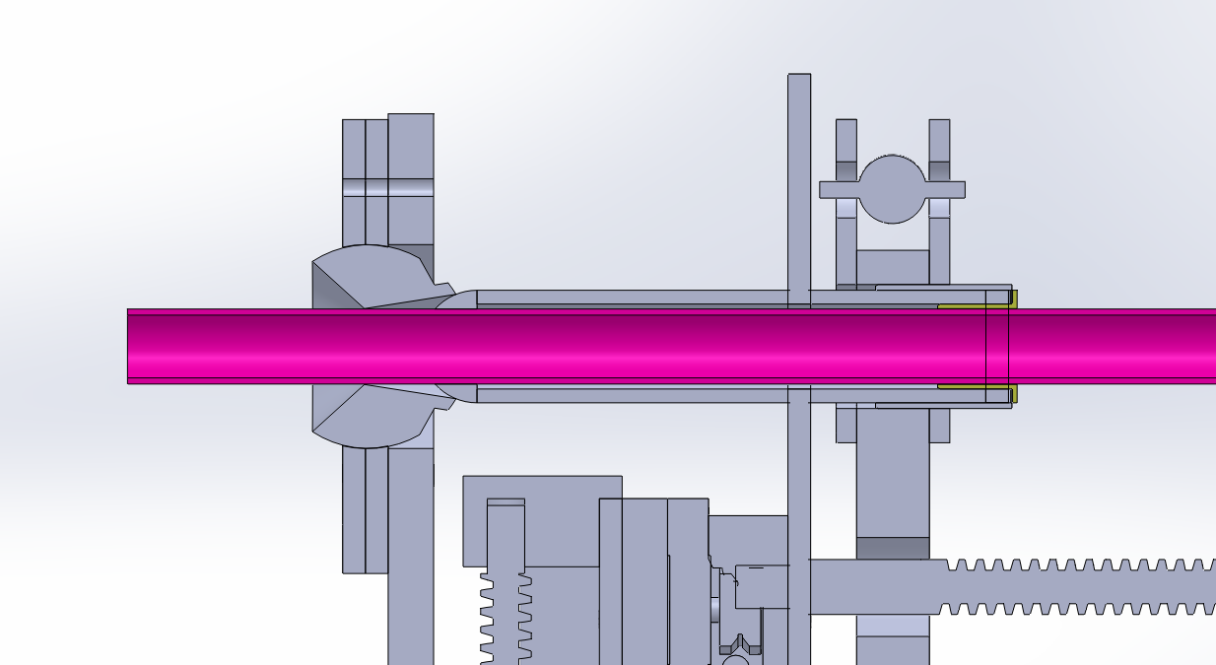
Pics/Halvkutt.png
