ycaf/mas306-rapport/Pics/Lagerror.png

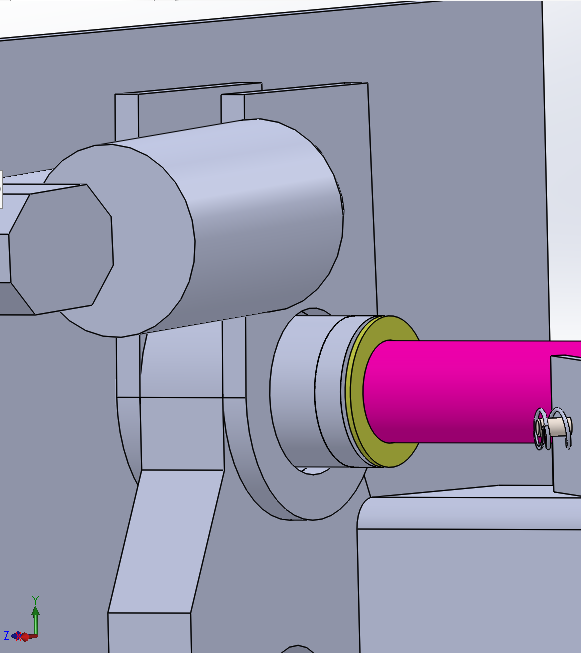
Pics/Lagerror.png
