ycaf/mas306-rapport/Pics/Lagerskrue.png

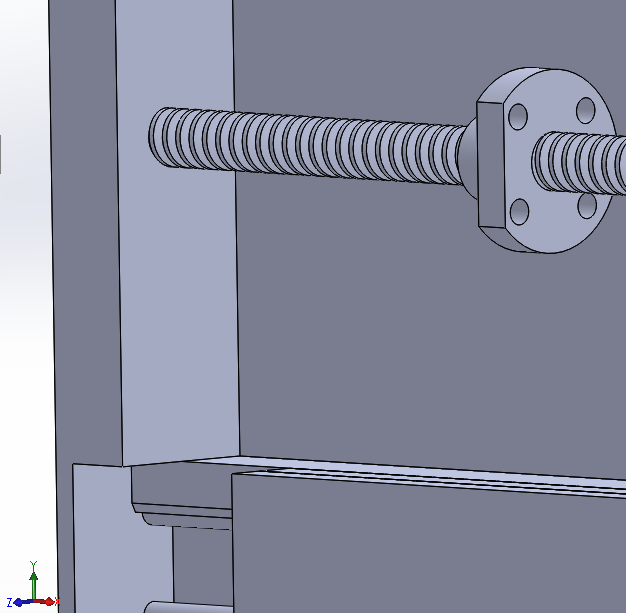
Pics/Lagerskrue.png
