ycaf/mas306-rapport/Pics/tube_Rough.png

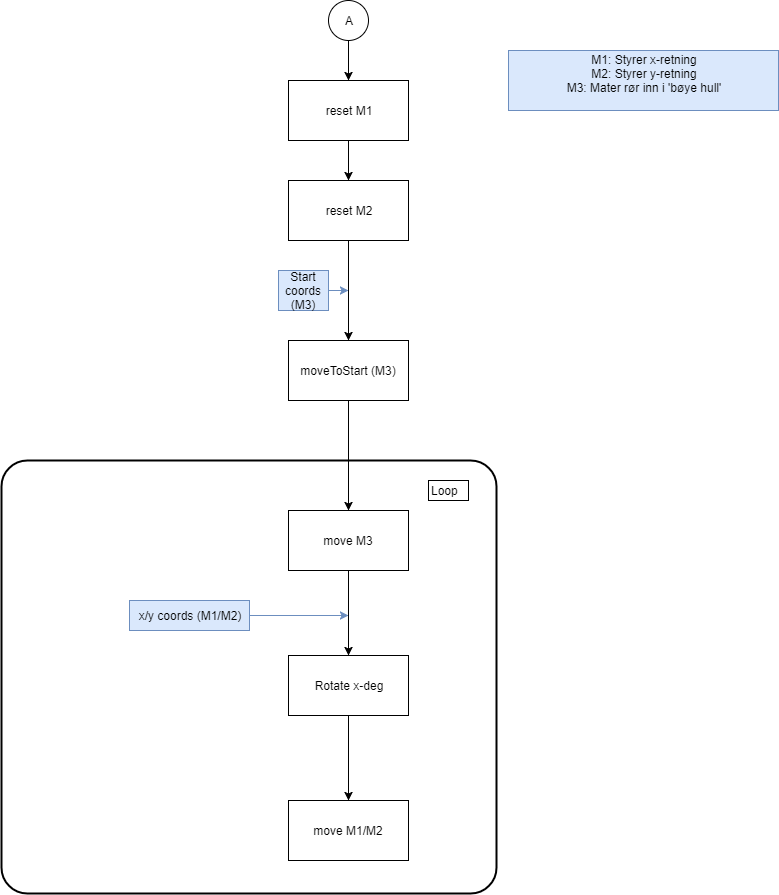
Pics/tube_Rough.png
