ycaf/mas306-rapport/(list of files, cad)

Other CAD files:
Vedlegg/Acople del Motor.SLDDRW
Vedlegg/BakersteVegg.SLDDRW
Vedlegg/FesteMotor.SLDDRW
Vedlegg/H-bjelke.SLDDRW
Vedlegg/Matelager.SLDDRW
Vedlegg/Mater - Bjelke.SLDDRW
Vedlegg/Mater - Halvmåne.SLDDRW
Vedlegg/Mater - fjær.SLDDRW
Vedlegg/Mater - fjærholder.SLDDRW
Vedlegg/Mater- Arm.SLDDRW
Vedlegg/MaterPlattform.SLDDRW
Vedlegg/MotorBrakettX.SLDDRW
Vedlegg/MotorBrakettY.SLDDRW
Vedlegg/Mutter.SLDDRW
Vedlegg/Plate.SLDDRW
Vedlegg/Sfærisk lager1.SLDDRW
Vedlegg/Sfærisk-festeskiveInnerst.SLDDRW
Vedlegg/Sfærisk-festeskiveYtterst.SLDDRW
Vedlegg/Skrue.SLDDRW
Vedlegg/Stuss.SLDDRW
Vedlegg/Sylinderfeste.SLDDRW
Vedlegg/Vogn.SLDDRW
Vedlegg/matelager-Sylinder.SLDDRW
Vedlegg/mellomplate.SLDDRW
Vedlegg/opplagring.SLDDRW
Vedlegg/skinner.SLDDRW
Vedlegg/vegg til øye.SLDDRW
