ycaf/mas306-rapport/Vedlegg/FesteMotor.PDF

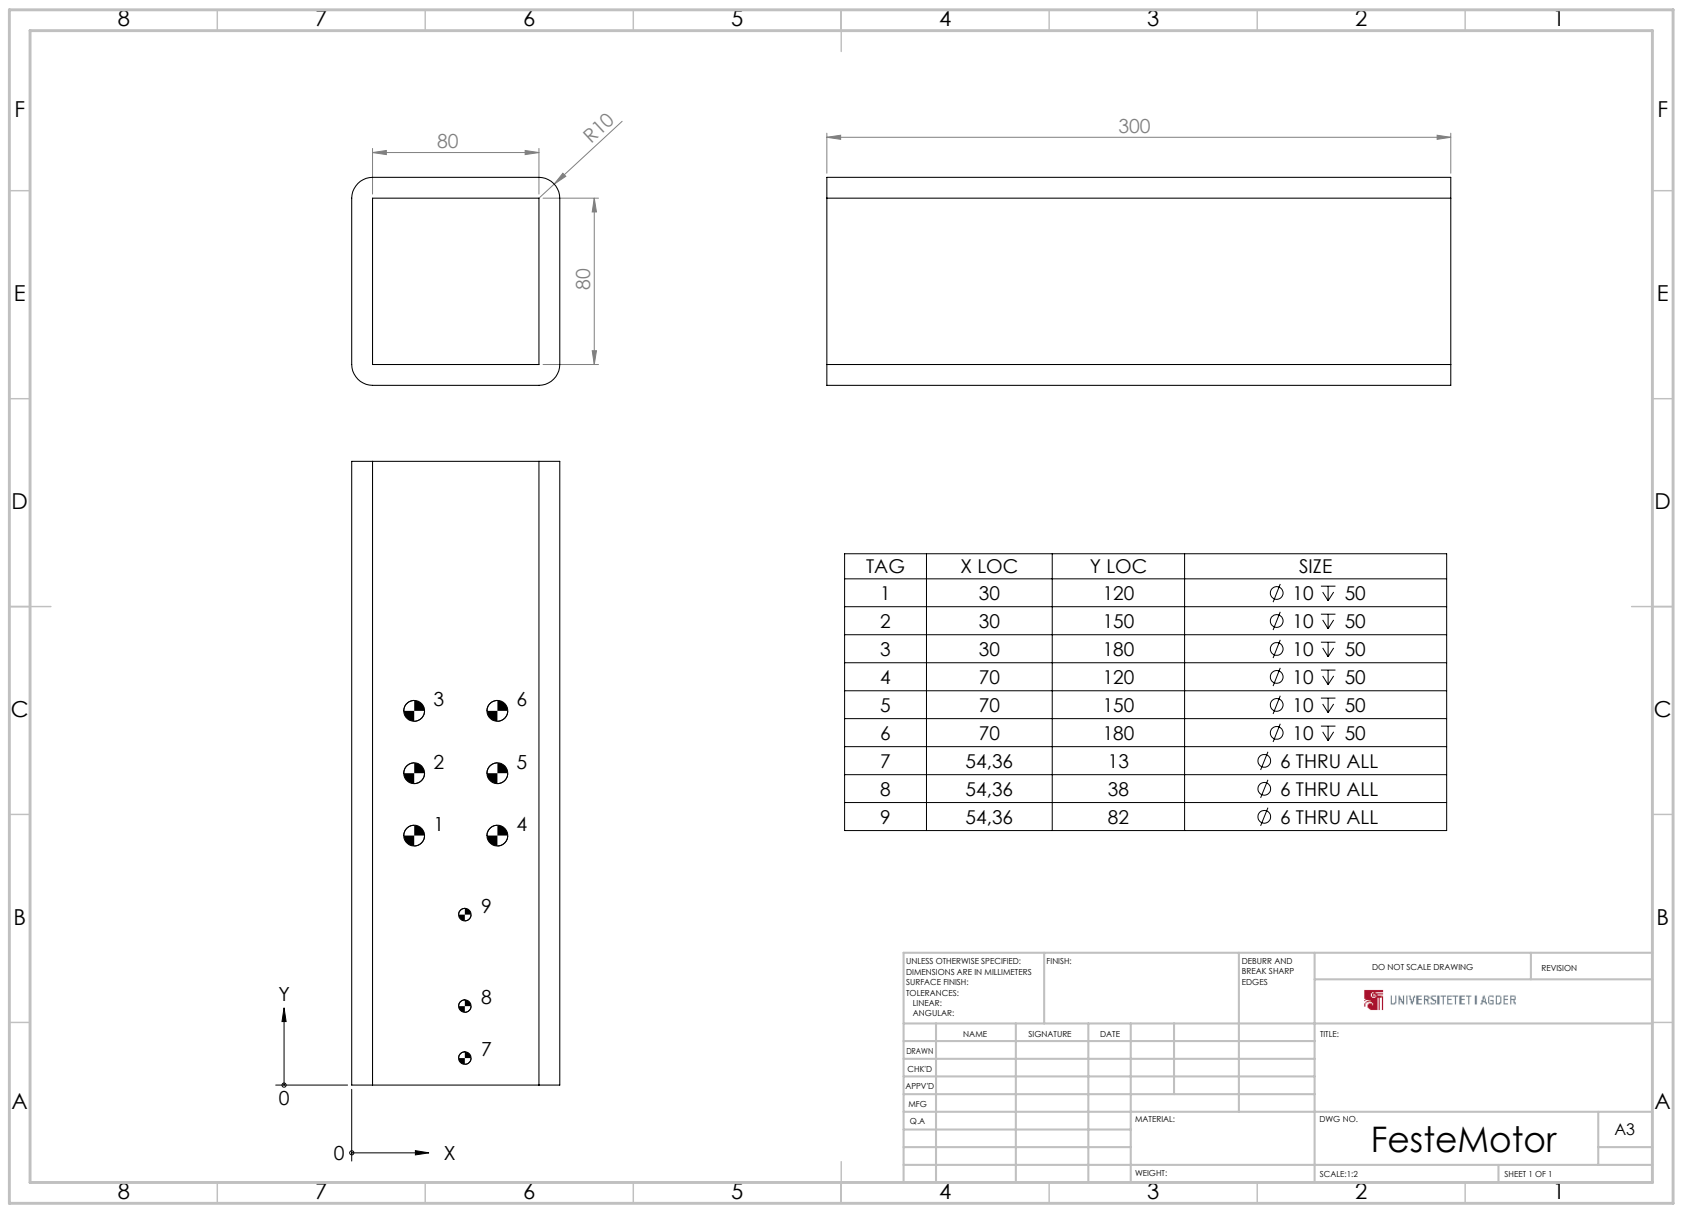
[picture p32: page 1]
FINISH:; DEBURR AND; BREAK SHARP; DO NOT SCALE DRAWING; REVISION; SCALE:1:2; SHEET 1 OF 1

TAG | X LOC | Y LOC | SIZE
1 | 30 | 120 | 10 50
2 | 30 | 150 | 10 50
3 | 30 | 180 | 10 50
4 | 70 | 120 | 10 50
5 | 70 | 150 | 10 50
6 | 70 | 180 | 10 50
7 | 54,36 | 13 | 6 THRU ALL
8 | 54,36 | 38 | 6 THRU ALL
9 | 54,36 | 82 | 6 THRU ALL

UNLESS OTHERWISE SPECIFIED:
DIMENSIONS ARE IN MILLIMETERS
SURFACE FINISH:
TOLERANCES:
LINEAR:
ANGULAR:

NAME | SIGNATURE | DATE | | | | TITLE:

DRAWN
CHK'D
APPV'D
MFG
Q.A | | | | MATERIAL: | DWG NO. FesteMotor | A3
