ycaf/mas306-rapport/Vedlegg/materfjer.PDF

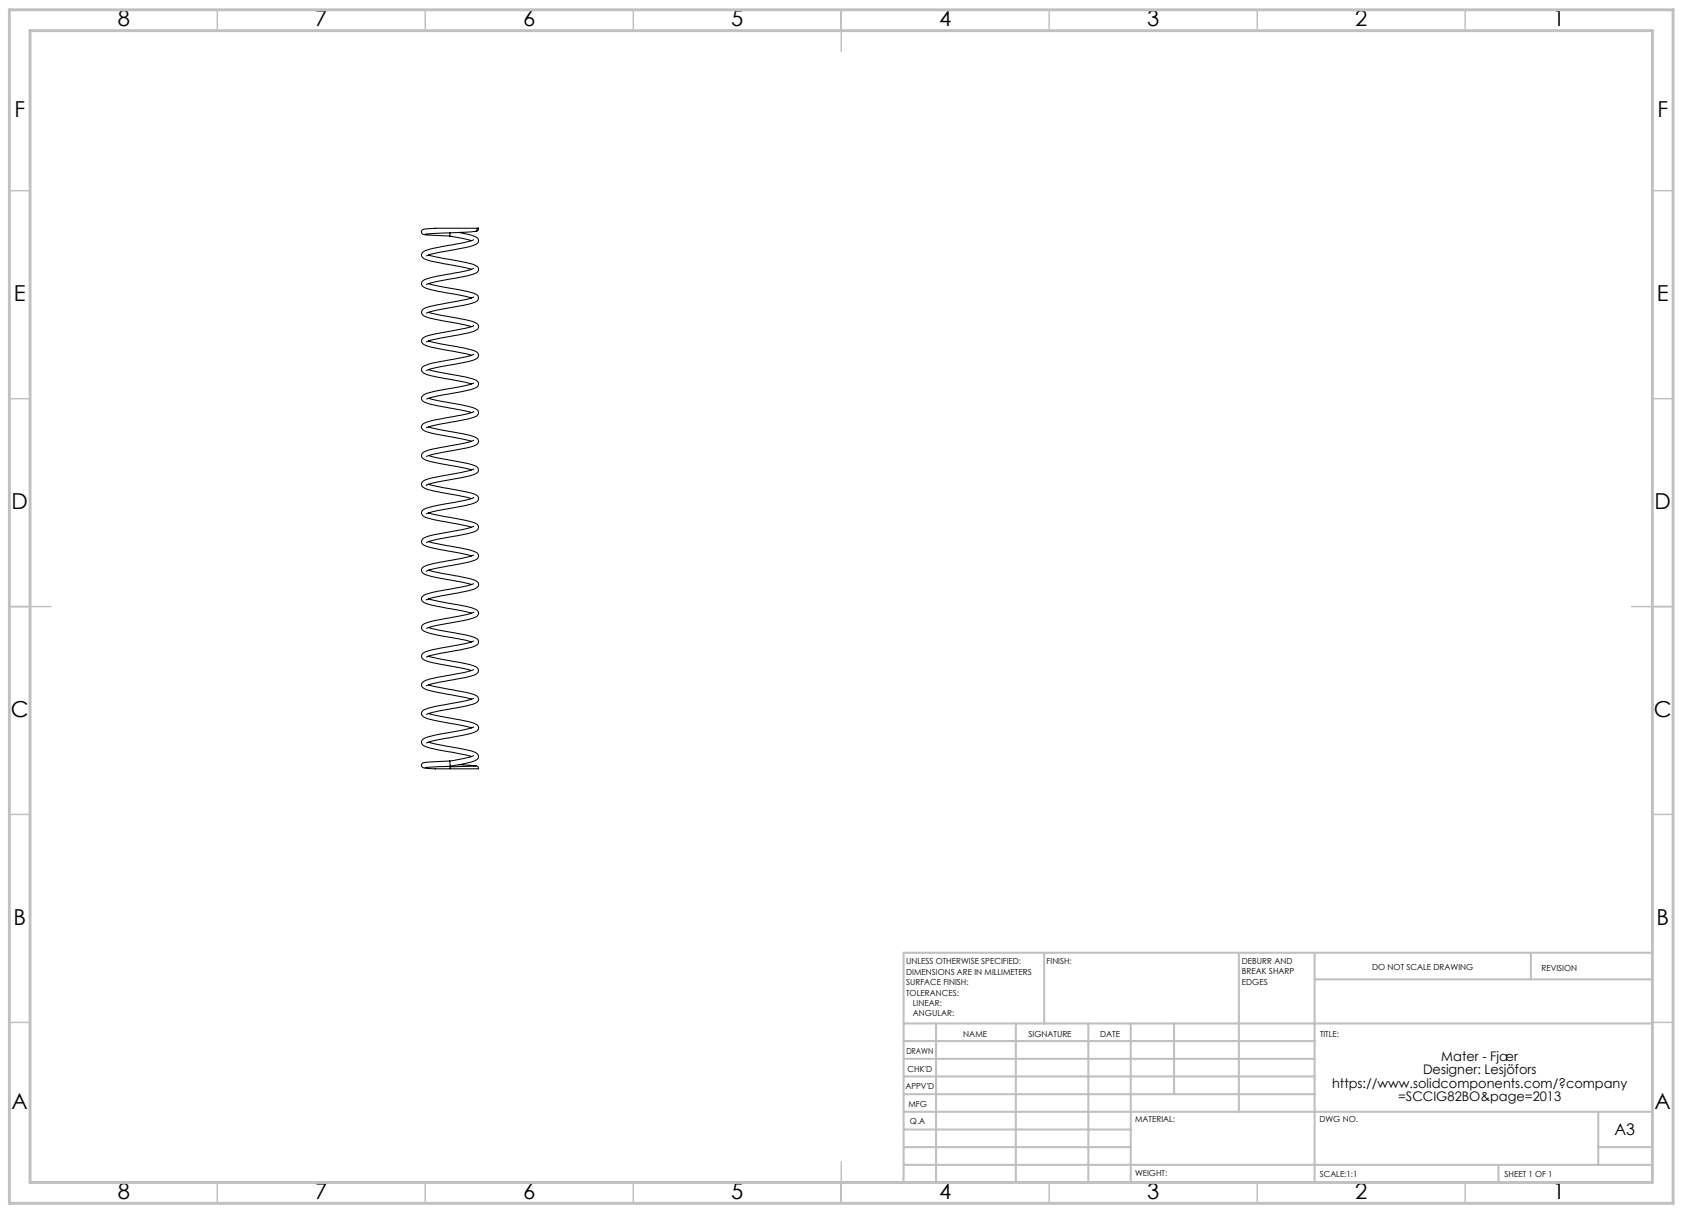
[picture p35: page 1]
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

UNLESS OTHERWISE SPECIFIED:
DIMENSIONS ARE IN MILLIMETERS
SURFACE FINISH:
TOLERANCES:
LINEAR:
ANGULAR:

NAME | SIGNATURE | DATE | | | | TITLE: Mater - Fjær Designer: Lesjöfors https://www.solidcomponents.com/?company=SCCIG82BO&page=2013

DRAWN
CHK'D
APPV'D
MFG
Q.A | | | | MATERIAL: | DWG NO. | A3
