ycaf/mas306-rapport/Vedlegg/MotorBrakettX.PDF

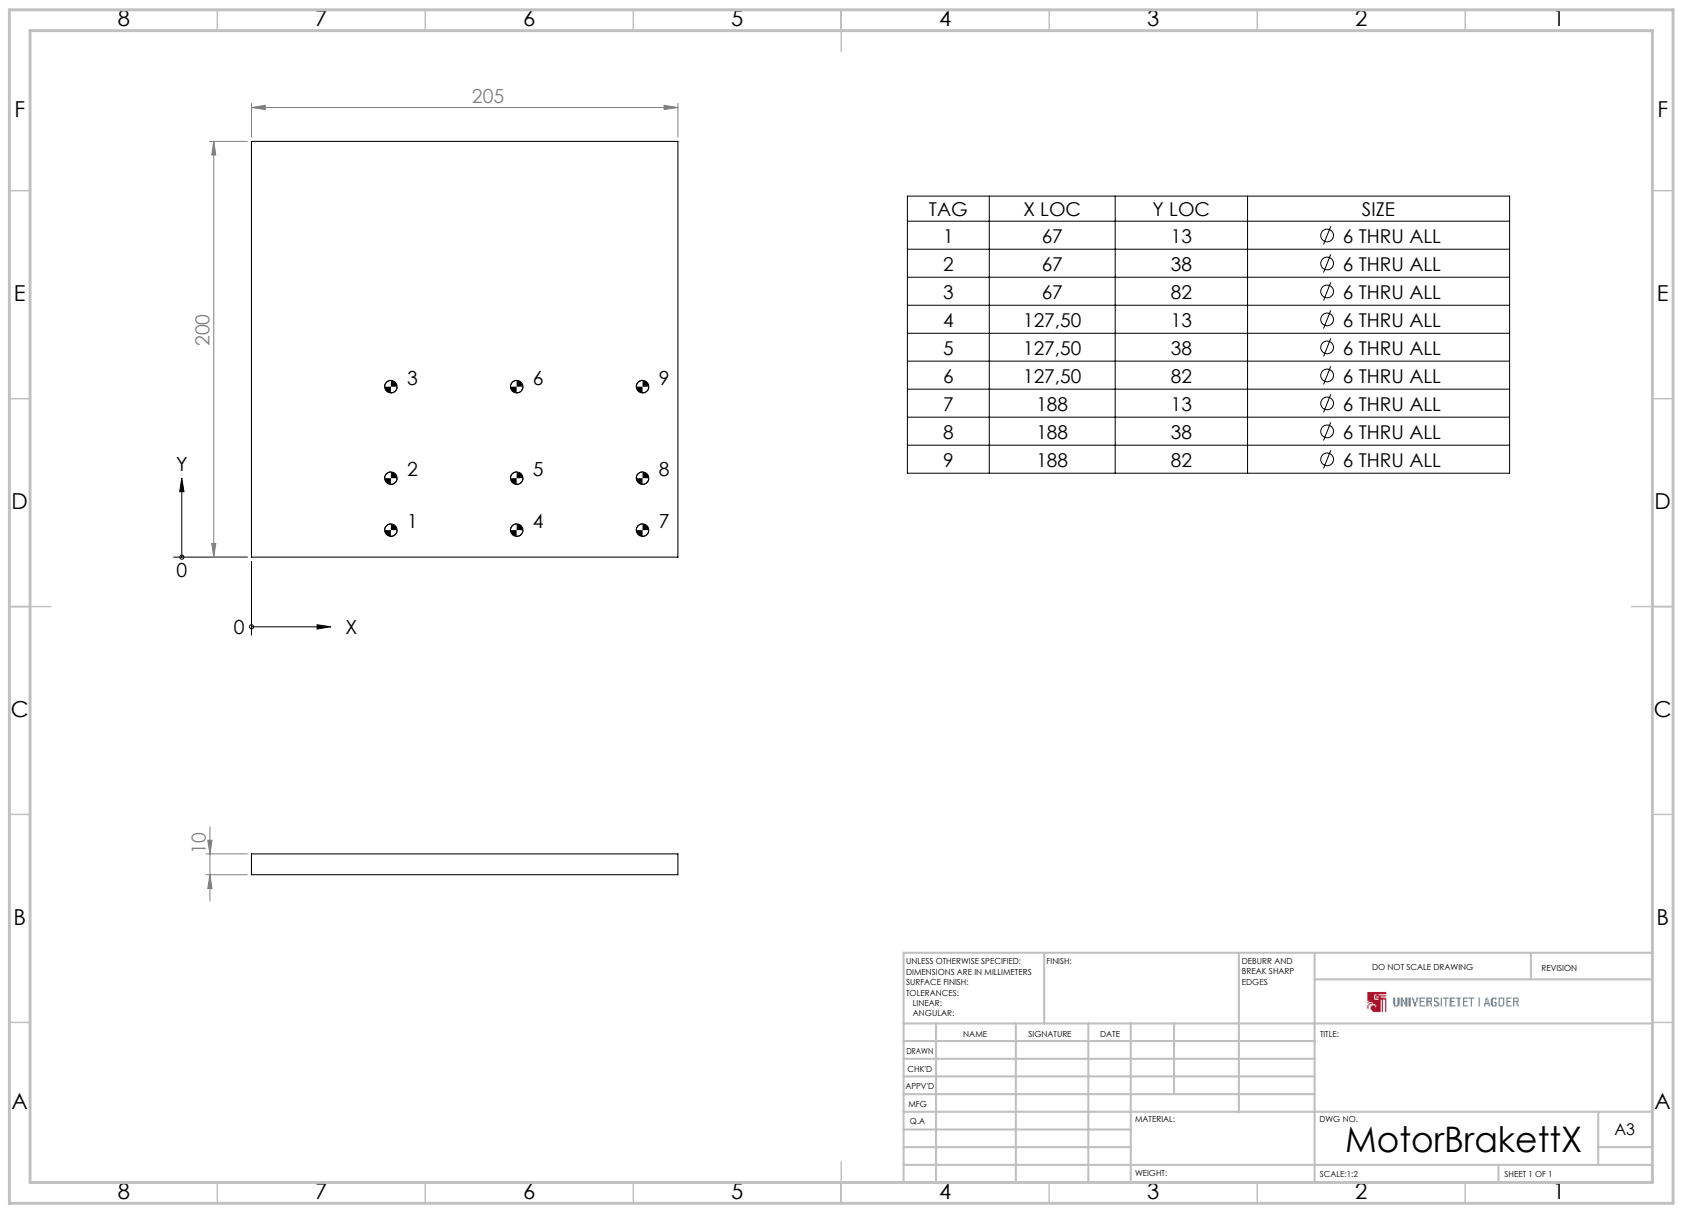
[picture p36: page 1]
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

TAG | X LOC | Y LOC | SIZE
1 | 67 | 13 | 6 THRU ALL
2 | 67 | 38 | 6 THRU ALL
3 | 67 | 82 | 6 THRU ALL
4 | 127,50 | 13 | 6 THRU ALL
5 | 127,50 | 38 | 6 THRU ALL
6 | 127,50 | 82 | 6 THRU ALL
7 | 188 | 13 | 6 THRU ALL
8 | 188 | 38 | 6 THRU ALL
9 | 188 | 82 | 6 THRU ALL

UNLESS OTHERWISE SPECIFIED:
DIMENSIONS ARE IN MILLIMETERS
SURFACE FINISH:
TOLERANCES:
LINEAR:
ANGULAR:

NAME | SIGNATURE | DATE | | | | TITLE:

DRAWN
CHK'D
APPV'D
MFG
Q.A | | | | MATERIAL: | DWG NO. MotorBrakettX | A3
