ycaf/mas306-rapport/Vedlegg/MotorBrakettY.PDF

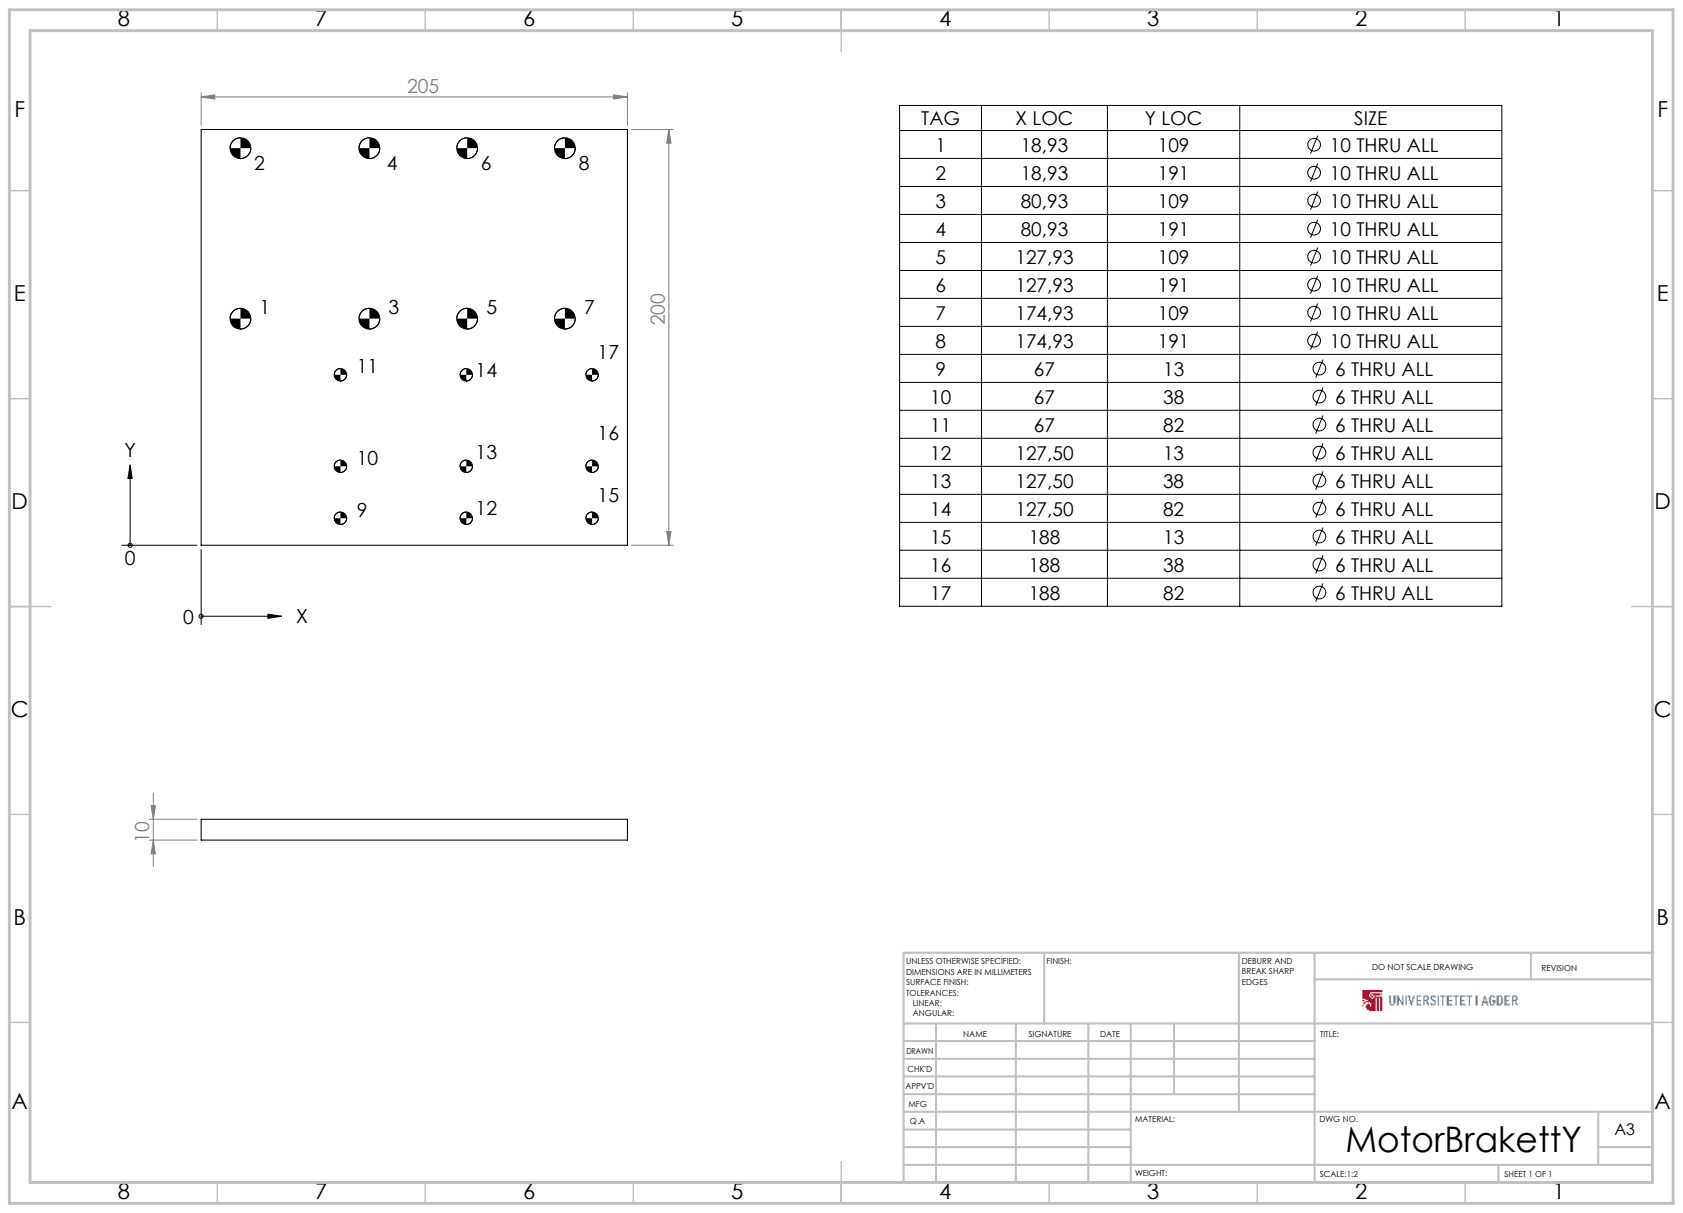
[picture p37: page 1]
TAG; X LOC; Y LOC; SIZE 1; 10 THRU ALL 2; 10 THRU ALL 3; 10 THRU ALL 4; 10 THRU ALL 5; 10 THRU ALL 6; 10 THRU ALL 7; 10 THRU ALL 8; 10 THRU ALL 9; 6 THRU ALL; FINISH:; DEBURR AND; BREAK SHARP; DO NOT SCALE DRAWING; REVISION; SCALE:1:2; SHEET 1 OF 1

10 | 67 | 38 | 6 THRU ALL
11 | 67 | 82 | 6 THRU ALL
12 | 127,50 | 13 | 6 THRU ALL
13 | 127,50 | 38 | 6 THRU ALL
14 | 127,50 | 82 | 6 THRU ALL
15 | 188 | 13 | 6 THRU ALL
16 | 188 | 38 | 6 THRU ALL
17 | 188 | 82 | 6 THRU ALL

UNLESS OTHERWISE SPECIFIED:
DIMENSIONS ARE IN MILLIMETERS
SURFACE FINISH:
TOLERANCES:
LINEAR:
ANGULAR:

NAME | SIGNATURE | DATE | | | | TITLE:

DRAWN
CHK'D
APPV'D
MFG
Q.A | | | | MATERIAL: | DWG NO. MotorBrakettY | A3
