ycaf/mas306-rapport/Vedlegg/opplagring.PDF

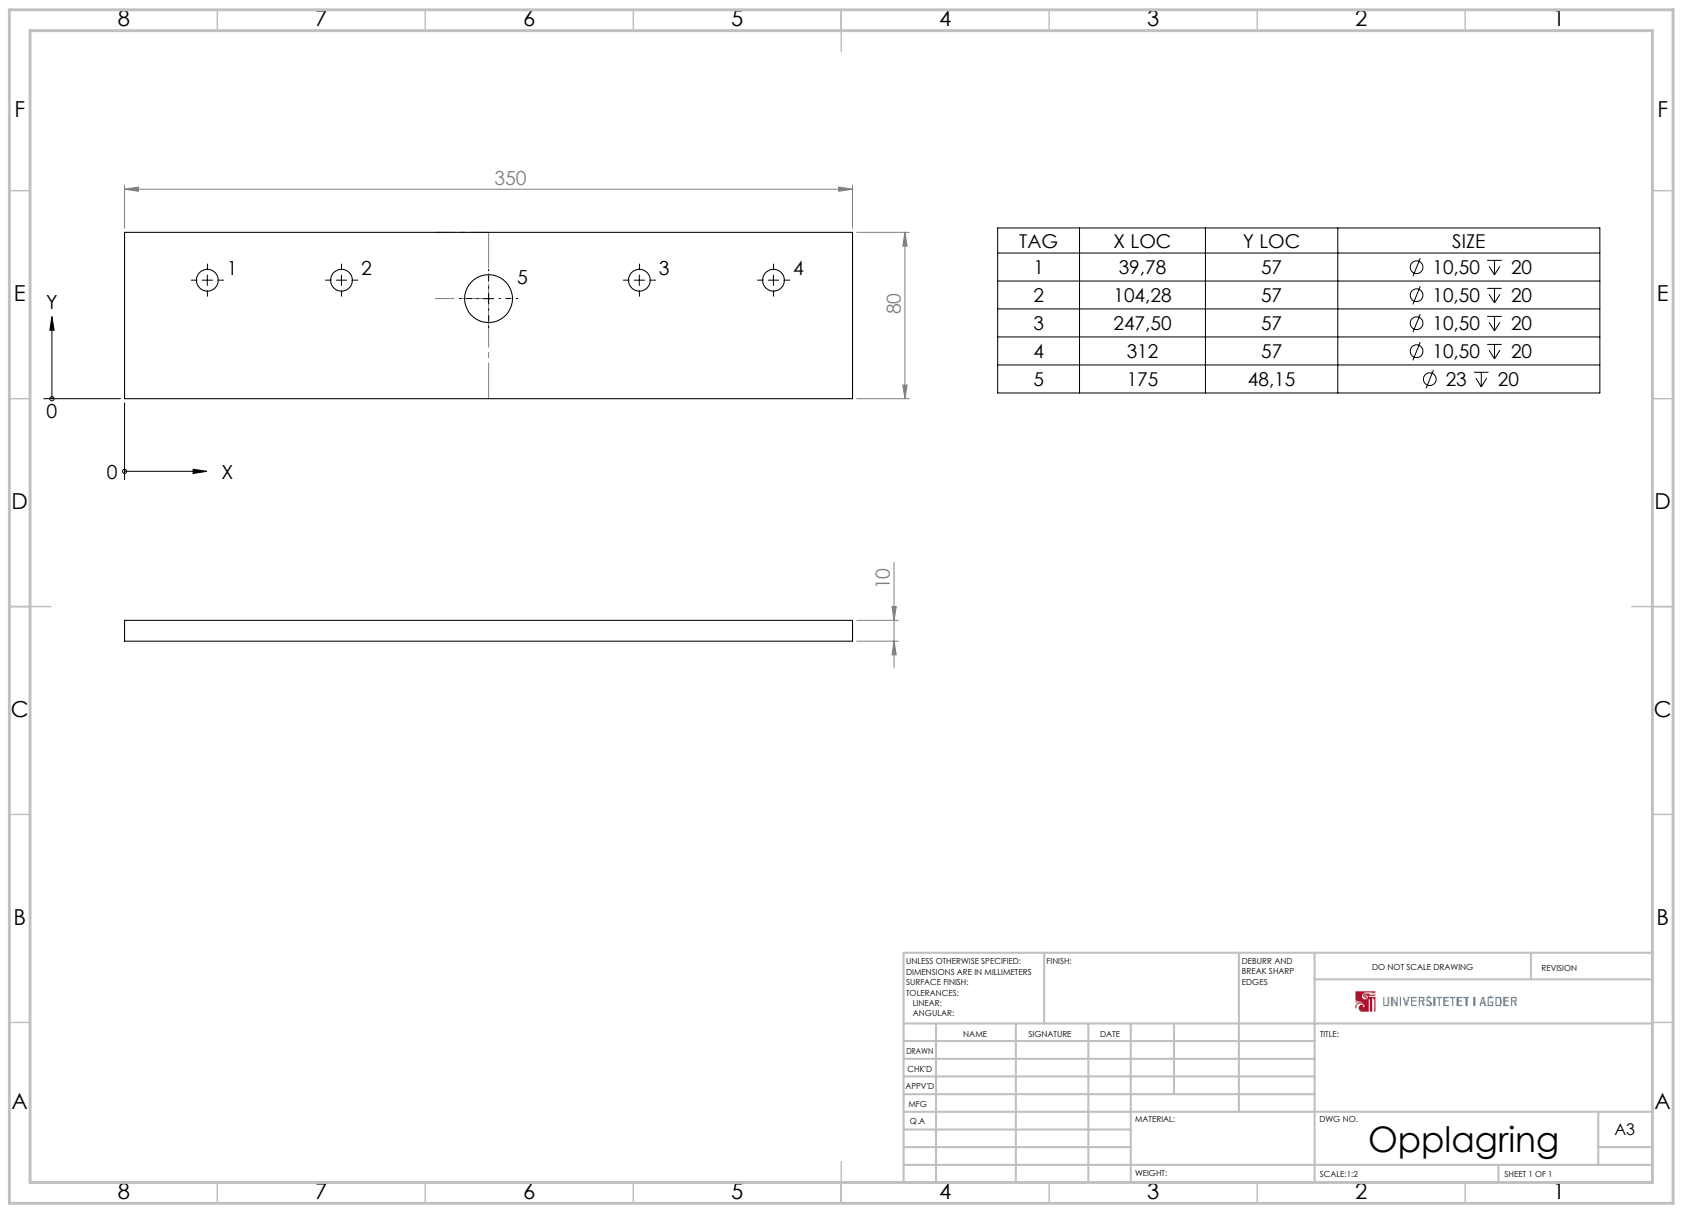
[picture p38: page 1]
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

TAG | X LOC | Y LOC | SIZE
1 | 39,78 | 57 | 10,50 20
2 | 104,28 | 57 | 10,50 20
3 | 247,50 | 57 | 10,50 20
4 | 312 | 57 | 10,50 20
5 | 175 | 48,15 | 23 20

UNLESS OTHERWISE SPECIFIED:
DIMENSIONS ARE IN MILLIMETERS
SURFACE FINISH:
TOLERANCES:
LINEAR:
ANGULAR:

NAME | SIGNATURE | DATE | | | | TITLE:

DRAWN
CHK'D
APPV'D
MFG
Q.A | | | | MATERIAL: | DWG NO. Opplagring | A3
