ycaf/mas306-rapport/Vedlegg/Plate.PDF

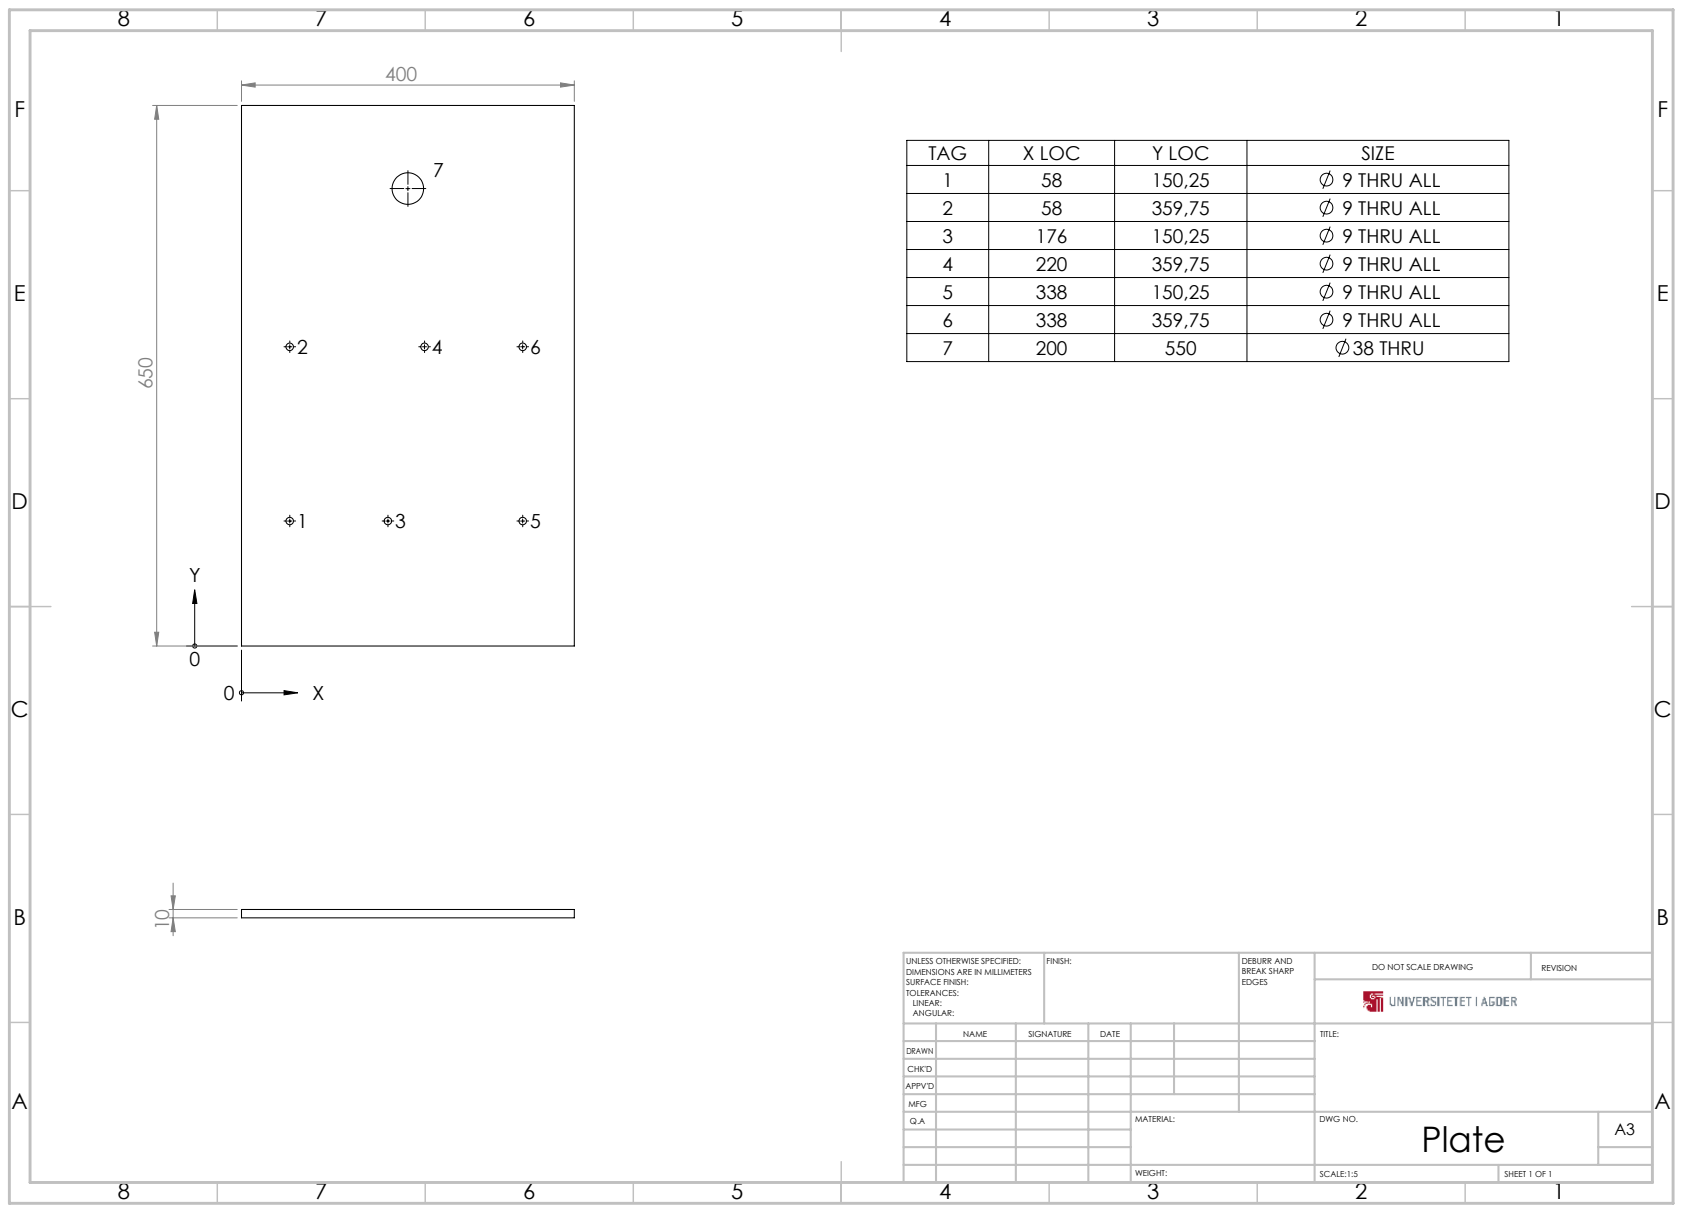
[picture p39: page 1]
9 THRU ALL; FINISH:; DEBURR AND; BREAK SHARP; DO NOT SCALE DRAWING; REVISION; SCALE:1:5; SHEET 1 OF 1

TAG | X LOC | Y LOC | SIZE
1 | 58 | 150,25 | 9 THRU ALL

3 | 176 | 150,25 | 9 THRU ALL
4 | 220 | 359,75 | 9 THRU ALL
5 | 338 | 150,25 | 9 THRU ALL
6 | 338 | 359,75 | 9 THRU ALL
7 | 200 | 550 | 38 THRU

UNLESS OTHERWISE SPECIFIED:
DIMENSIONS ARE IN MILLIMETERS
SURFACE FINISH:
TOLERANCES:
LINEAR:
ANGULAR:

NAME | SIGNATURE | DATE | | | | TITLE:

DRAWN
CHK'D
APPV'D
MFG
Q.A | | | | MATERIAL: | DWG NO. Plate | A3
