ycaf/mas306-rapport/Pics/driverConn.pdf

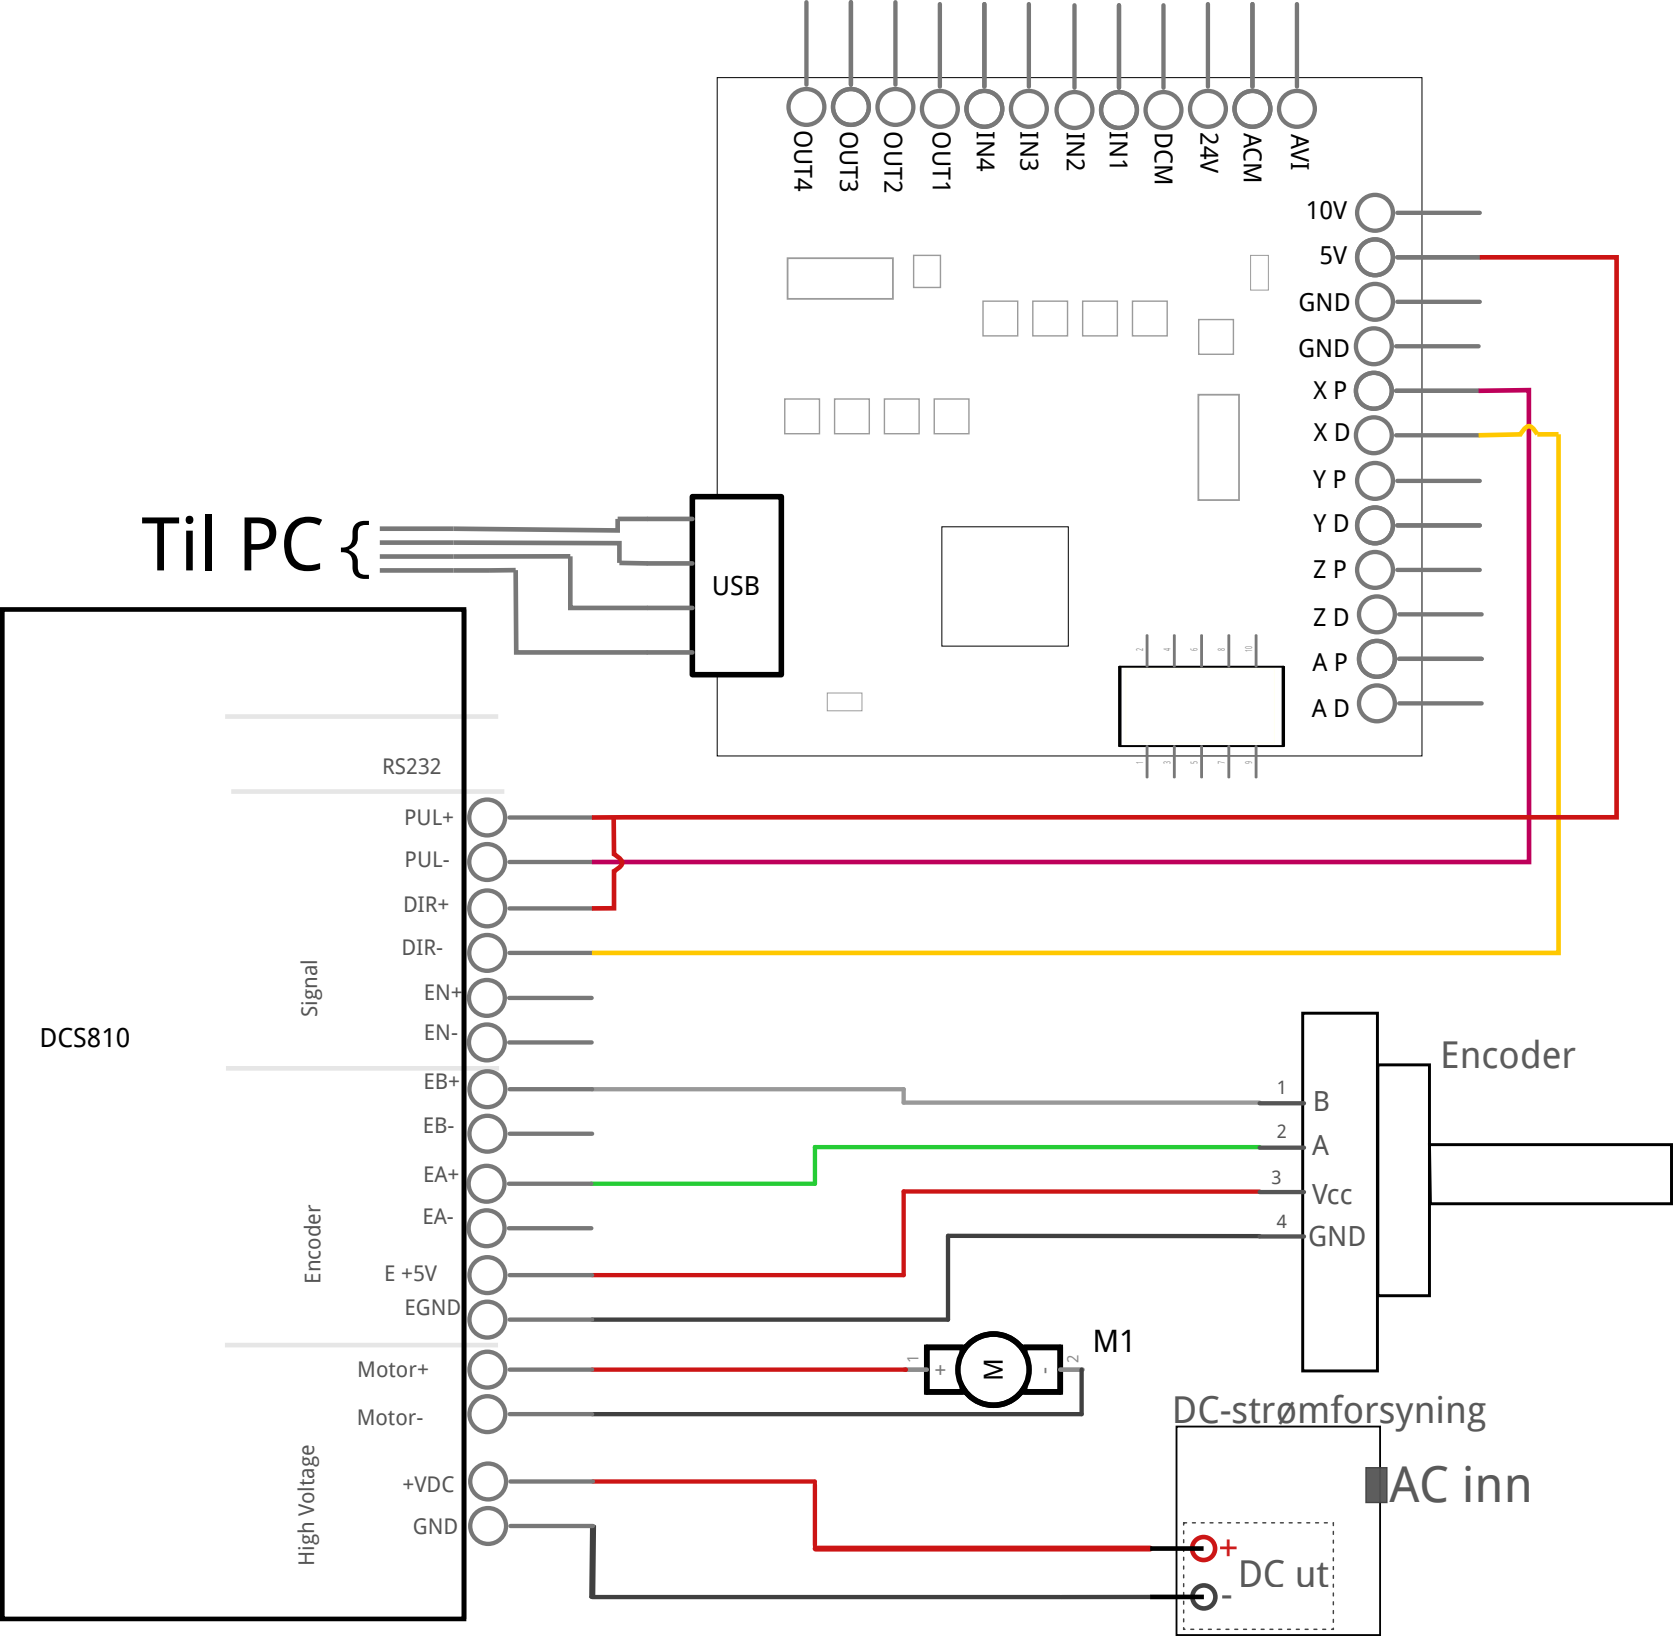
[picture p43: page 1]
DCS810; PUL+; PUL-; DIR+; DIR-; E +5V EGND; Motor+; Motor-; +VDC; GND; Vcc; GND AB; OUT4; OUT3; OUT2; OUT1; DCM; ACM; AVI; AVR SPI; PROG; MOSI; RESET; SCK; MISO; USB; Til PC

High Voltage Encoder Signal
