ycaf/mas306-rapport/Pics/graf1-eps-converted-to.pdf

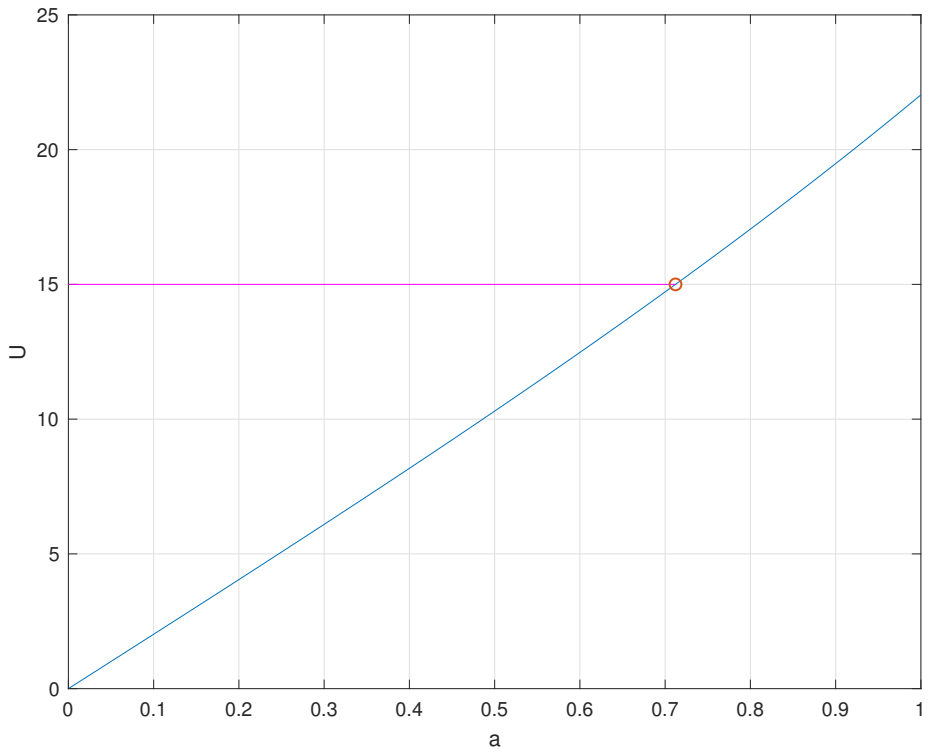
[picture p44: page 1]
