ycaf/mas306-rapport/Vedlegg/mellomplate.PDF

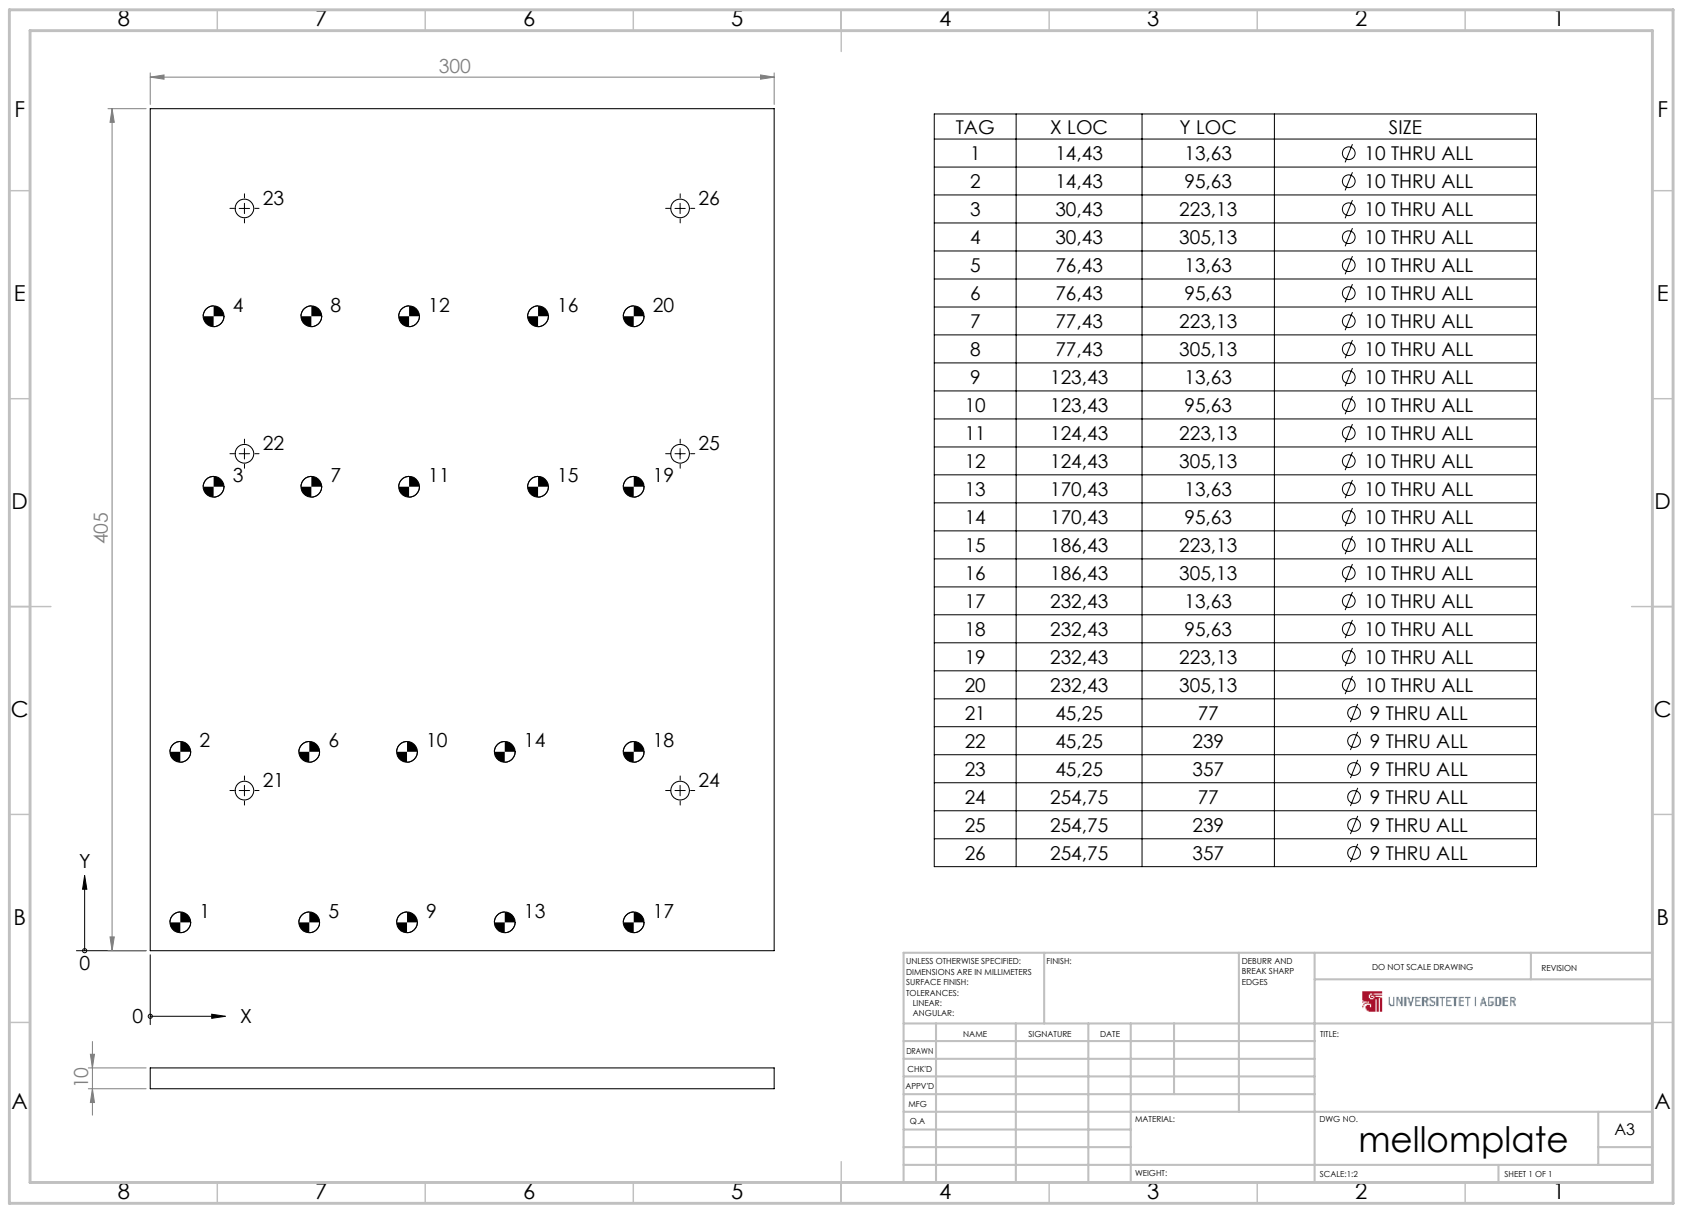
[picture p45: page 1]
TAG; X LOC; Y LOC; SIZE 1; 10 THRU ALL 2; 10 THRU ALL 3; 10 THRU ALL 4; 10 THRU ALL 5; 10 THRU ALL 6; 10 THRU ALL 7; 10 THRU ALL 8; 10 THRU ALL 9; 10 THRU ALL; FINISH:; DEBURR AND; BREAK SHARP; DO NOT SCALE DRAWING; REVISION; SCALE:1:2; SHEET 1 OF 1

10 | 123,43 | 95,63 | 10 THRU ALL
11 | 124,43 | 223,13 | 10 THRU ALL
12 | 124,43 | 305,13 | 10 THRU ALL
13 | 170,43 | 13,63 | 10 THRU ALL
14 | 170,43 | 95,63 | 10 THRU ALL
15 | 186,43 | 223,13 | 10 THRU ALL
16 | 186,43 | 305,13 | 10 THRU ALL
17 | 232,43 | 13,63 | 10 THRU ALL
18 | 232,43 | 95,63 | 10 THRU ALL
19 | 232,43 | 223,13 | 10 THRU ALL
20 | 232,43 | 305,13 | 10 THRU ALL
21 | 45,25 | 77 | 9 THRU ALL
22 | 45,25 | 239 | 9 THRU ALL
23 | 45,25 | 357 | 9 THRU ALL
24 | 254,75 | 77 | 9 THRU ALL
25 | 254,75 | 239 | 9 THRU ALL
26 | 254,75 | 357 | 9 THRU ALL

UNLESS OTHERWISE SPECIFIED:
DIMENSIONS ARE IN MILLIMETERS
SURFACE FINISH:
TOLERANCES:
LINEAR:
ANGULAR:

NAME | SIGNATURE | DATE | | | | TITLE:

DRAWN
CHK'D
APPV'D
MFG
Q.A | | | | MATERIAL: | DWG NO. mellomplate | A3
