ycaf/mas306-rapport/Vedlegg/veggoye.PDF

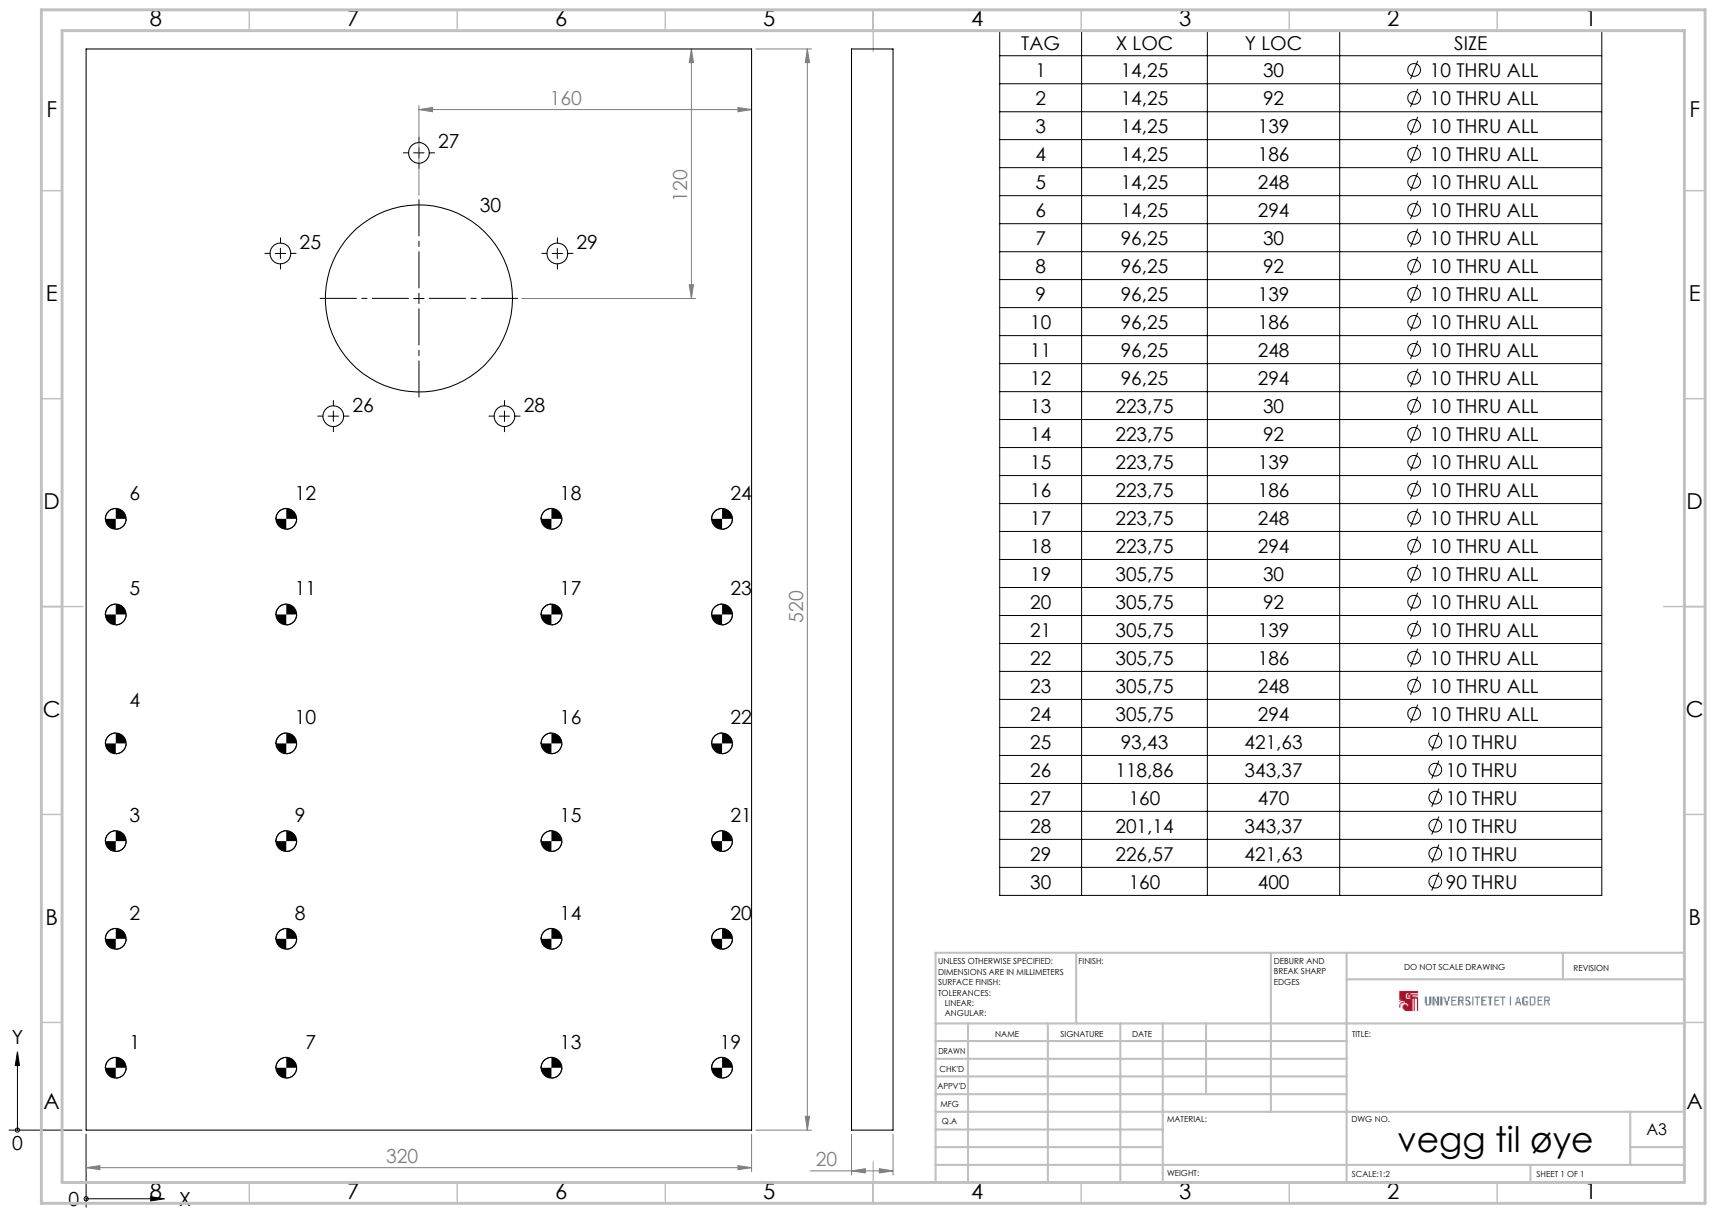
[picture p46: page 1]
TAG; X LOC; Y LOC; SIZE 1; 10 THRU ALL 2; 10 THRU ALL 3; 10 THRU ALL 4; 10 THRU ALL 5; 10 THRU ALL 6; 10 THRU ALL 7; 10 THRU ALL 8; 10 THRU ALL 9; 10 THRU ALL; 10 THRU; FINISH:; DEBURR AND; BREAK SHARP; DO NOT SCALE DRAWING; REVISION; SCALE:1:2; SHEET 1 OF 1

10 | 96,25 | 186 | 10 THRU ALL
11 | 96,25 | 248 | 10 THRU ALL
12 | 96,25 | 294 | 10 THRU ALL
13 | 223,75 | 30 | 10 THRU ALL
14 | 223,75 | 92 | 10 THRU ALL
15 | 223,75 | 139 | 10 THRU ALL
16 | 223,75 | 186 | 10 THRU ALL
17 | 223,75 | 248 | 10 THRU ALL
18 | 223,75 | 294 | 10 THRU ALL
19 | 305,75 | 30 | 10 THRU ALL
20 | 305,75 | 92 | 10 THRU ALL
21 | 305,75 | 139 | 10 THRU ALL
22 | 305,75 | 186 | 10 THRU ALL
23 | 305,75 | 248 | 10 THRU ALL
24 | 305,75 | 294 | 10 THRU ALL
25 | 93,43 | 421,63 | 10 THRU
26 | 118,86 | 343,37 | 10 THRU
27 | 160 | 470 | 10 THRU

29 | 226,57 | 421,63 | 10 THRU
30 | 160 | 400 | 90 THRU

UNLESS OTHERWISE SPECIFIED:
DIMENSIONS ARE IN MILLIMETERS
SURFACE FINISH:
TOLERANCES:
LINEAR:
ANGULAR:

NAME | SIGNATURE | DATE | | | | TITLE:

DRAWN
CHK'D
APPV'D
MFG
Q.A | | | | MATERIAL: | DWG NO. vegg til øye | A3
