ycaf/mas306-rapport/Pics/tube_Rough.pdf

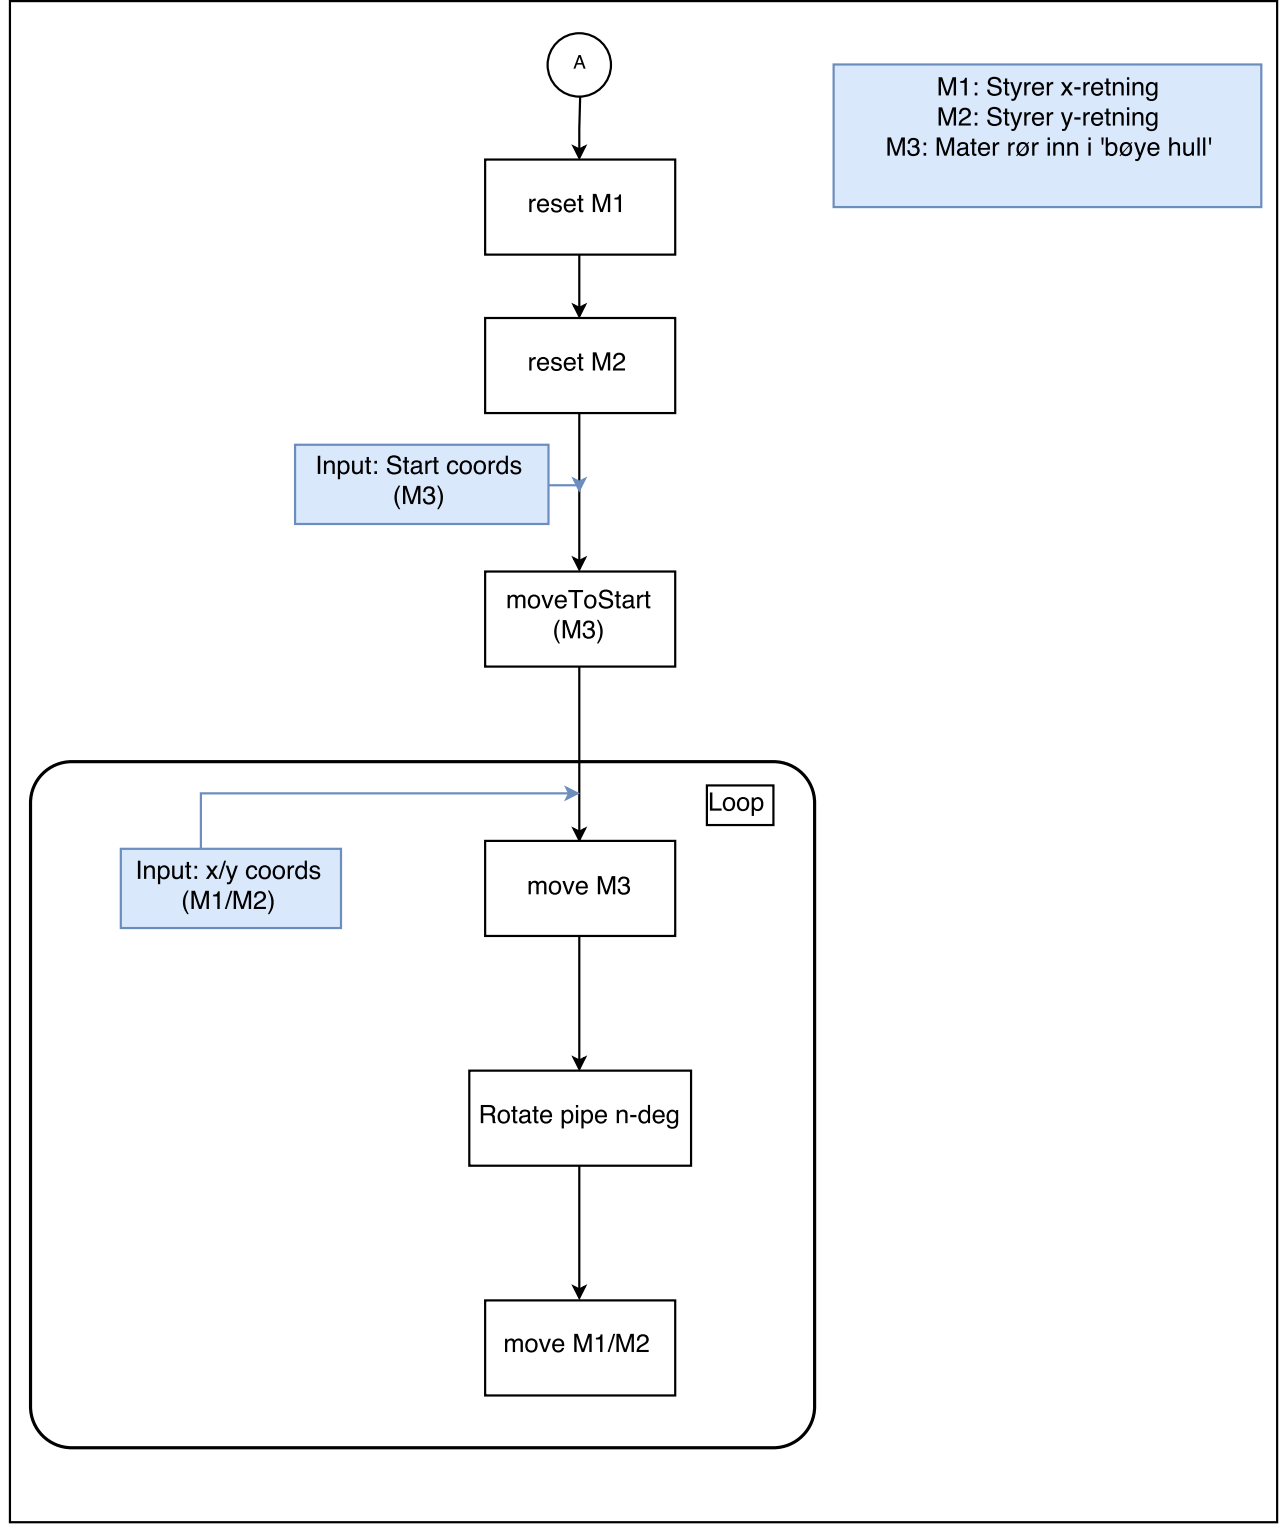
[picture p47: page 1]
