ycaf/mas306-rapport/(commit log)

2018-05-06 test (driverconn pic added)
2018-05-06 Cross reference
    Refereret til bilder i teksten slik at det blir riktig hvis de skulle bli forskjøvet
2018-05-07 Bilder
    Satt inn flere bilder, fikset på tekst under design og materialer
2018-05-12 Bøyemekanisme, XY-bord, litt designdelen
    [Acople del Motor.SLDDRW, BakersteVegg.SLDDRW, FesteMotor.SLDDRW, H-bjelke.SLDDRW, Matelager.SLDDRW, Mater - Bjelke.SLDDRW, Mater - Halvmåne.SLDDRW, Mater - fjær.SLDDRW]
